albale15/simulador_de_Extraccion_de_polipos_intestinales/INFORME/apendices imagenes/fidelidad visual1.png

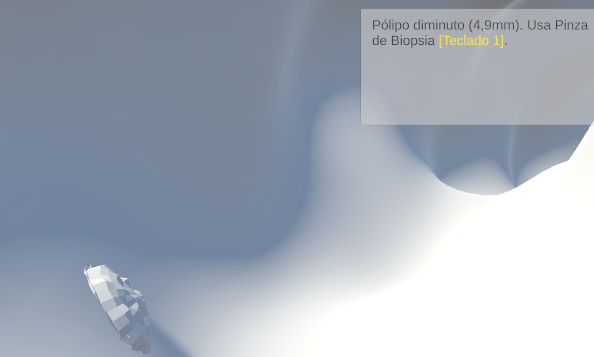
INFORME/apendices imagenes/fidelidad visual1.png
