albale15/simulador_de_Extraccion_de_polipos_intestinales/INFORME/apendices imagenes/MecanismoDeInsercion.PNG

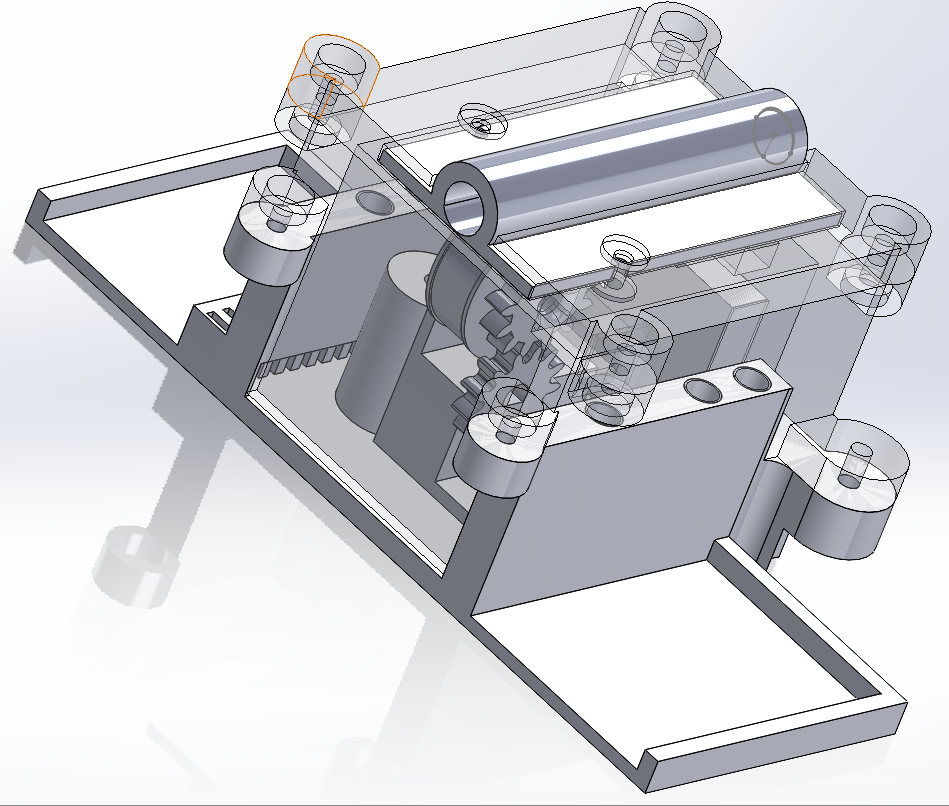
INFORME/apendices imagenes/MecanismoDeInsercion.PNG
