albale15/simulador_de_Extraccion_de_polipos_intestinales/presentacion/presentacion simulador de reseccion de polipos intestinales.pptx

## Simulador híbrido físico-virtual para el entrenamiento de resección de pólipos intestinales

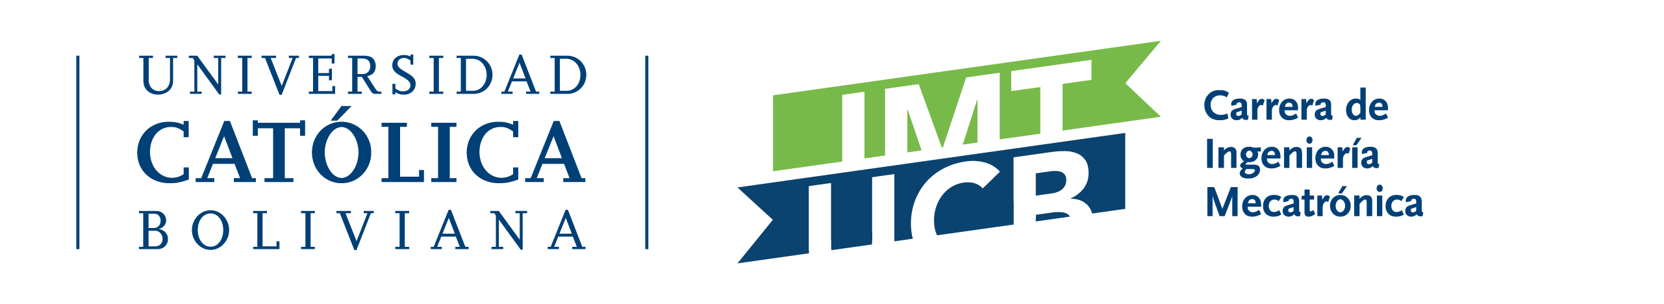
[picture p3: figure]

Por: Alejandro Eduardo Albarracin Rodriguez
TUTOR: Guillermo Enrique Manning Soria Galvarro
PANELISTA: Xavier Alexis Murillo Sanchez
RELATOR: Andrés Leonardo Gutierrez Rocha

## Introducción

TALLER DE GRADO 1-2026

Alejandro Eduardo Albarracin Rodriguez
TUTOR: Guillermo Enrique Manning Soria Galvarro
PANELISTA: Xavier Alexis Murillo Sanchez
RELATOR: Andrés Leonardo Gutierrez Rocha

- La Organización Mundial de la Salud (a través de datos recopilados en World Life Expectancy) indica que en Bolivia hubo cerca de 407 muertes atribuidas al cáncer colorrectal en 2020.
- En Bolivia, la escasez de simuladores clínicos o equipos de práctica especializados en el país obliga a que gran parte del aprendizaje de procedimientos endoscópicos se realice directamente sobre pacientes reales.

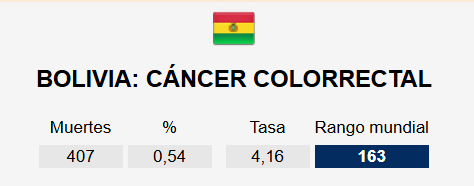
[picture p4: figure]

Datos de la Organización Mundial de la Salud (OMS), vía World Life Expectancy.

## Planteamiento del Problema

TALLER DE GRADO 1-2026

Alejandro Eduardo Albarracin Rodriguez
TUTOR: Guillermo Enrique Manning Soria Galvarro
PANELISTA: Xavier Alexis Murillo Sanchez
RELATOR: Andrés Leonardo Gutierrez Rocha

- Simuladores comerciales de alta fidelidad (GI Mentor) muy realistas, pero con costos prohibitivos (>USD 60,000).

- Soluciones locales de simulación médica — acceso más amplio, pero con limitaciones técnicas.

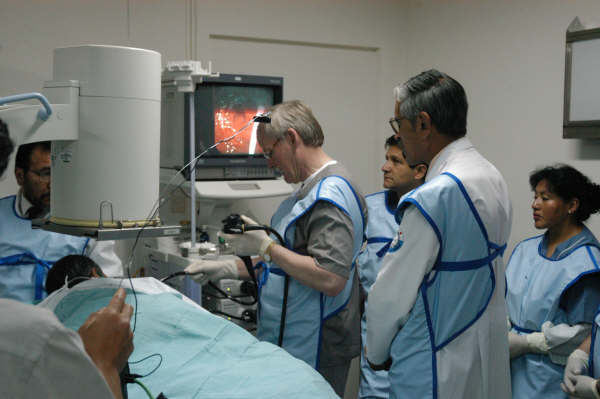
[picture p5: figure]

Capacitación en el Centro de Capacitación WGO La Paz.

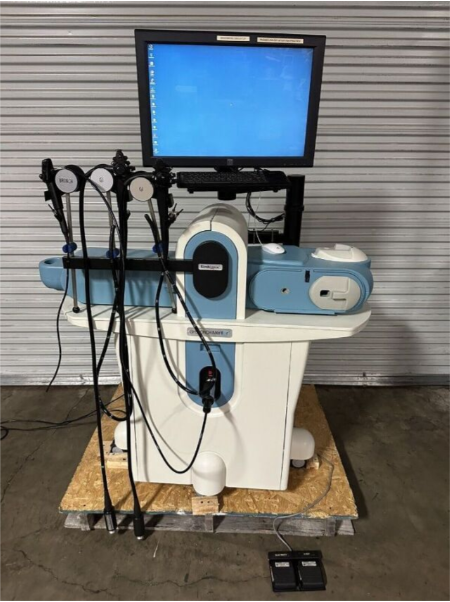
[picture p6: figure]

Simulador Gi Mentor para Endoscopia.

## Objetivo General

TALLER DE GRADO 1-2026

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

- Diseñar un simulador de resección de pólipos intestinales de bajo costo, con integración físico–virtual, con la finalidad de apoyar la práctica y entrenamiento en endoscopia terapéutica en entornos académicos con recursos limitados, permitiendo evaluar precisión, tiempo de respuesta y seguridad durante la práctica endoscópica simulada.

## Estado del Arte y Ventaja Competitiva

TALLER DE GRADO 1-2026

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

Simuladores Comerciales (ej. GI Mentor): Alta fidelidad, pero cerrados y con costo > $60,000 USD.
Prototipos Académicos Actuales: Bajo costo, pero sufren de alta latencia, desgaste mecánico, ruido mecánico y poca fidelidad práctica.
Nuestro Proyecto, latencia asíncrona imperceptible, con eliminación de ruidos, retroalimentación práctica.

## Arquitectura Híbrida Físico-Virtual

TALLER DE GRADO 1-2026

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

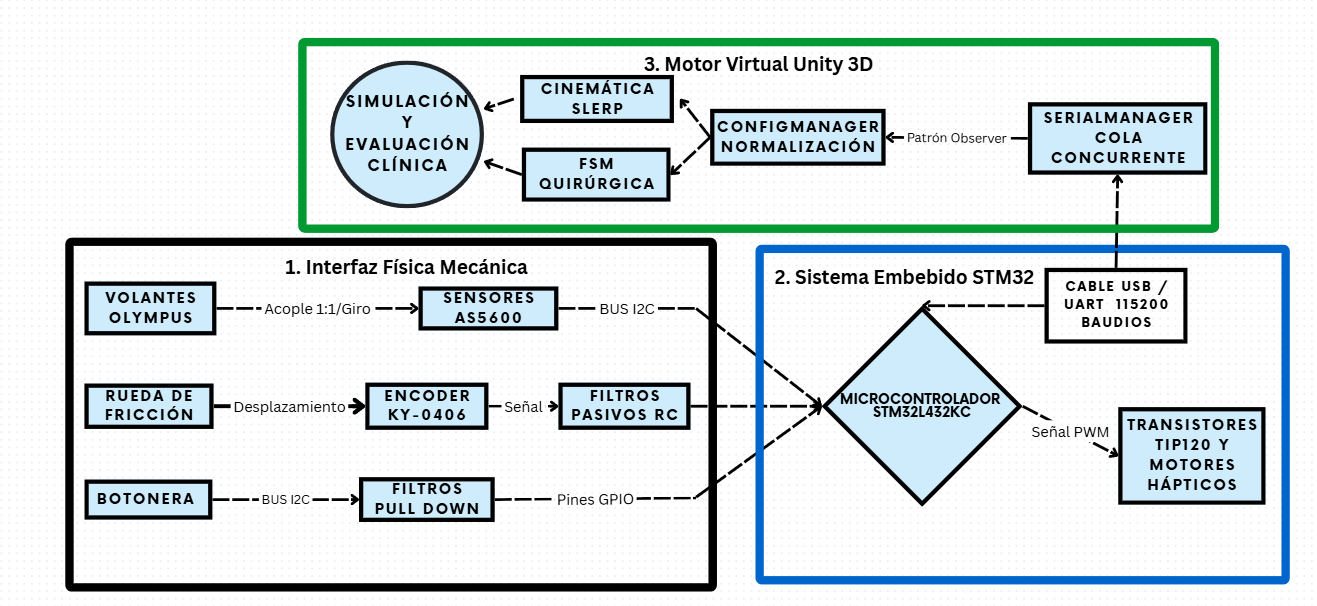
[picture p7: figure]

- Interfaz Física
- Sistema Embebido
- Entorno Virtual (Unity).

## Arquitectura Electrónica Embebida

TALLER DE GRADO 1-2026

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

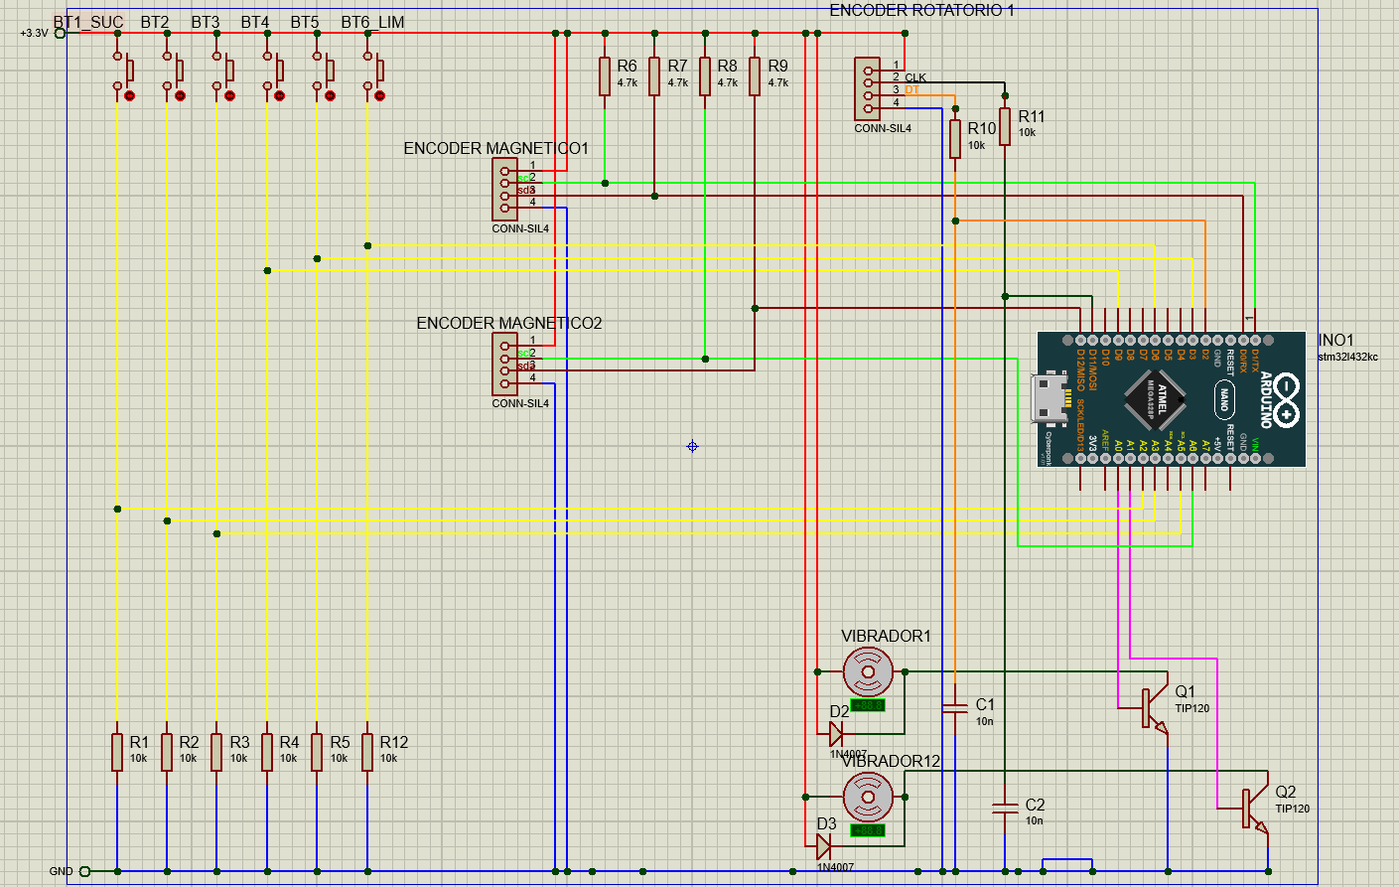
[picture p8: figure]

Circuito en Proteus.

Obj. 1. Diseño de circuito electrónico.

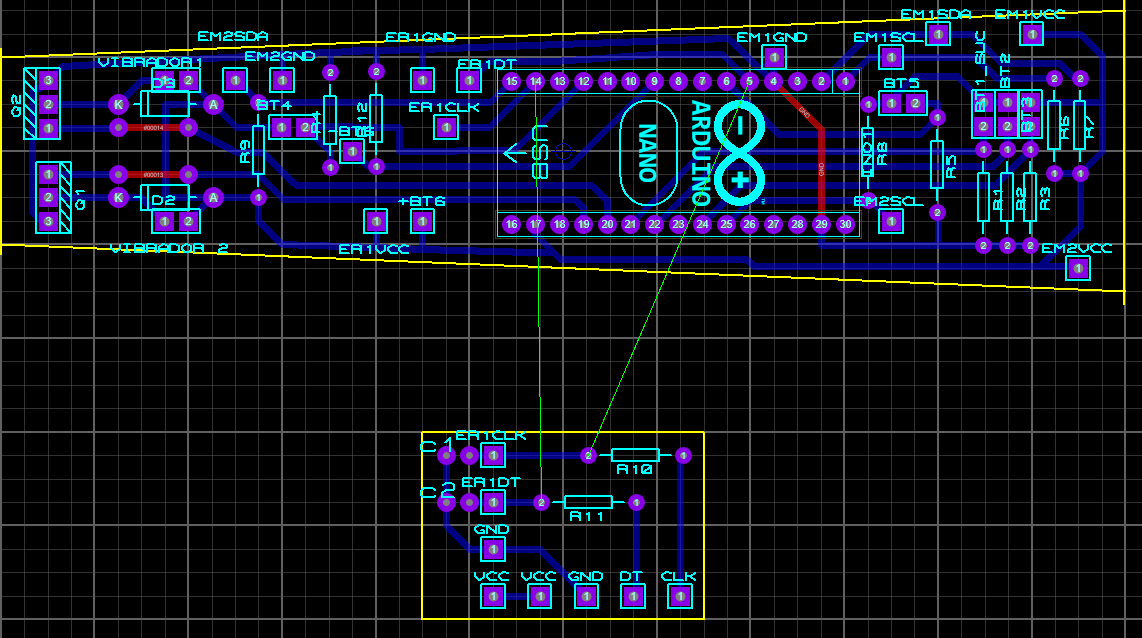
[picture p9: figure]

Diseños para las PCB en Proteus.

## Sensado Magnético

TALLER DE GRADO 1-2026

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

- Sustitución de potenciómetros para eliminar fricción y ruido mecánico.
- Sensores AS5600 con protocolo de comunicación I2C.
- Resolución digital de 12 bits (4096 posiciones por revolución).

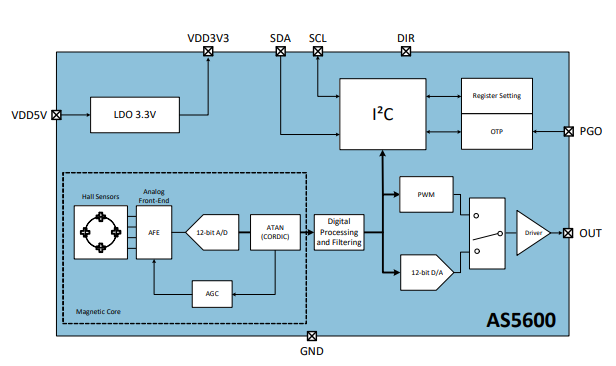
[picture p10: figure]

Encoder Magnetico AS5600.

## Filtrado Analógico y Digital

TALLER DE GRADO 1-2026

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

- Filtro pasivo RC por hardware (fc ≈ 159 Hz) para absorción de transitorios.
- Algoritmo digital (Firmware): Máquina de estados de 16 posiciones mediante interrupciones (EXTI) y Debounce de 10 ms.
- Seguro contra congelamiento en los motores vibradores (apagado automático después de 1000 ms).

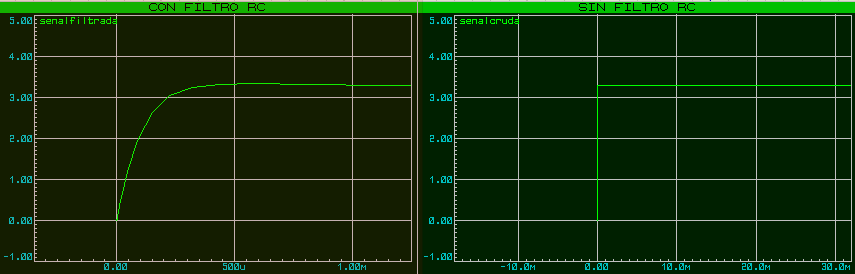
[picture p11: figure]

Curva de Señales del Sensor rotativo.

## Diseño Mecánico y Tren Cinemático

TALLER DE GRADO 1-2026

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

- Manufactura en FDM (Ácido Poliláctico – PLA)

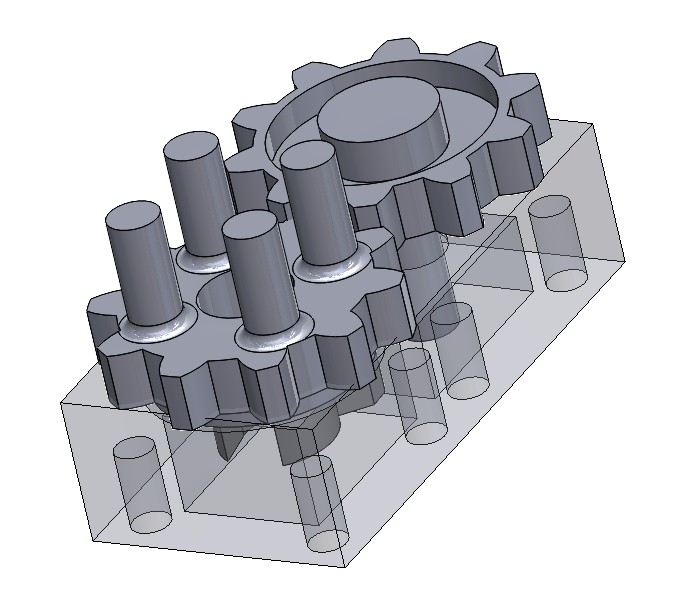
[picture p12: figure]

Caja de Engranes 1:1 del Centro de mando.

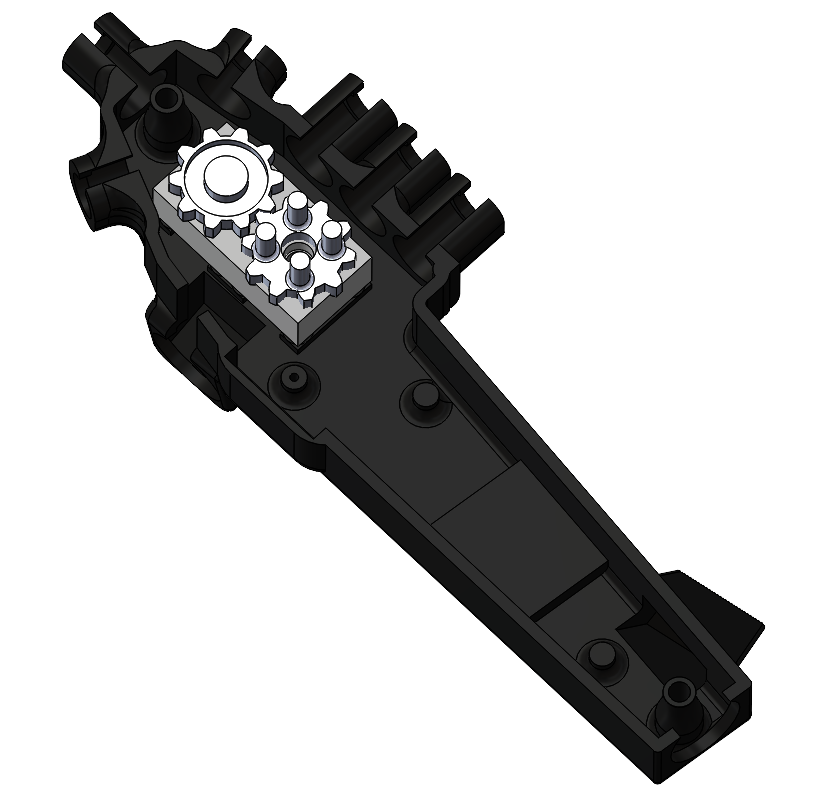
[picture p13: figure]
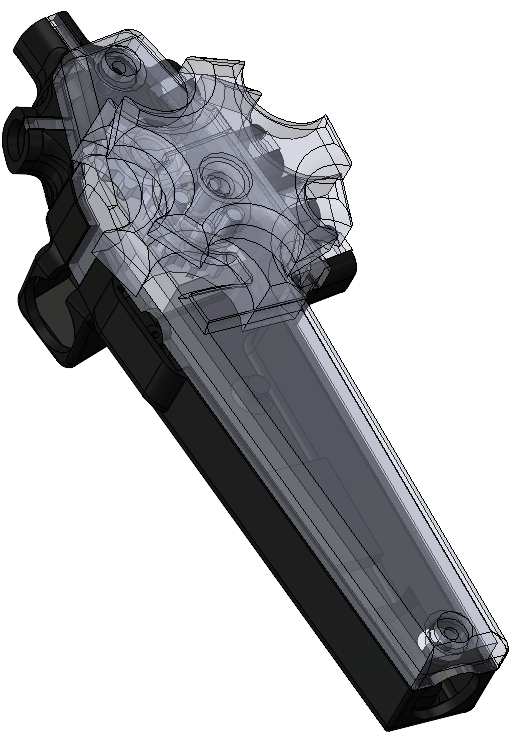
[picture p14: figure]

Mecanismo del Centro de Mando.

Obj. 3 - Fabricar los elementos físicos de interacción.

## Cinemática de Inserción Longitudinal

TALLER DE GRADO 1-2026

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

- Captura de desplazamiento: mecanismo basado en fricción estática (rueda de goma).
- Encoder rotativo KY-040 gestionado por interrupciones (EXTI).
- Diseño modular para ajustes o mejoras, alta escalabilidad.

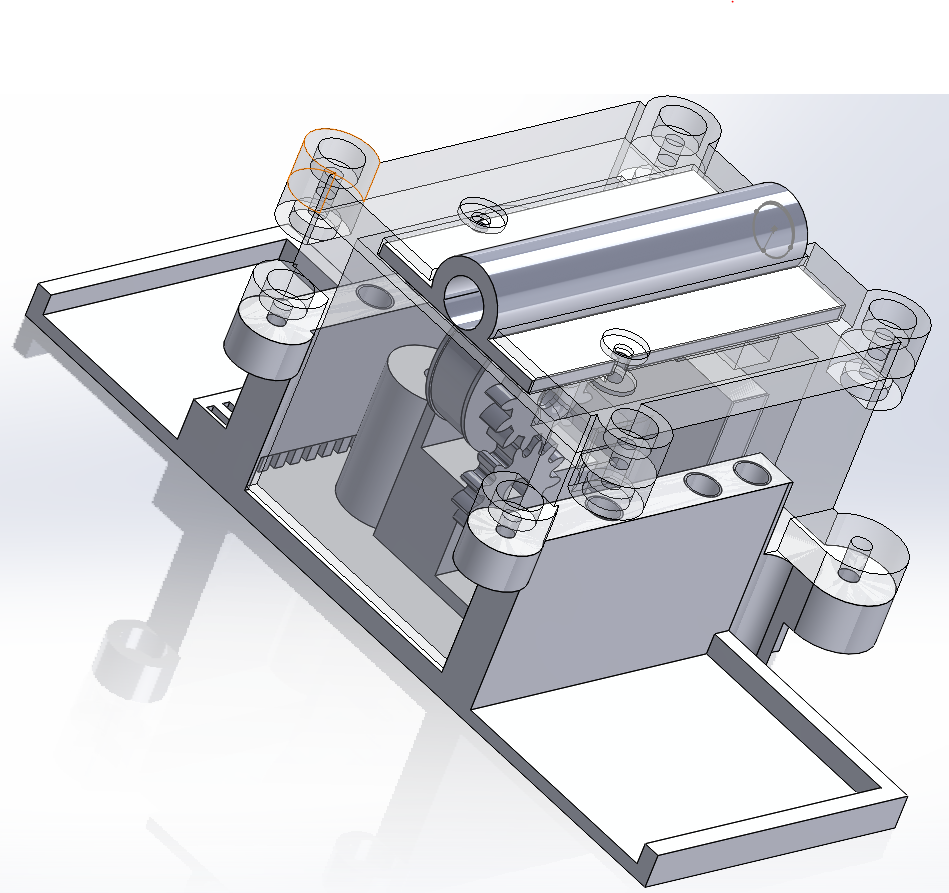
[picture p15: figure]

Mecanismo de Inserción.

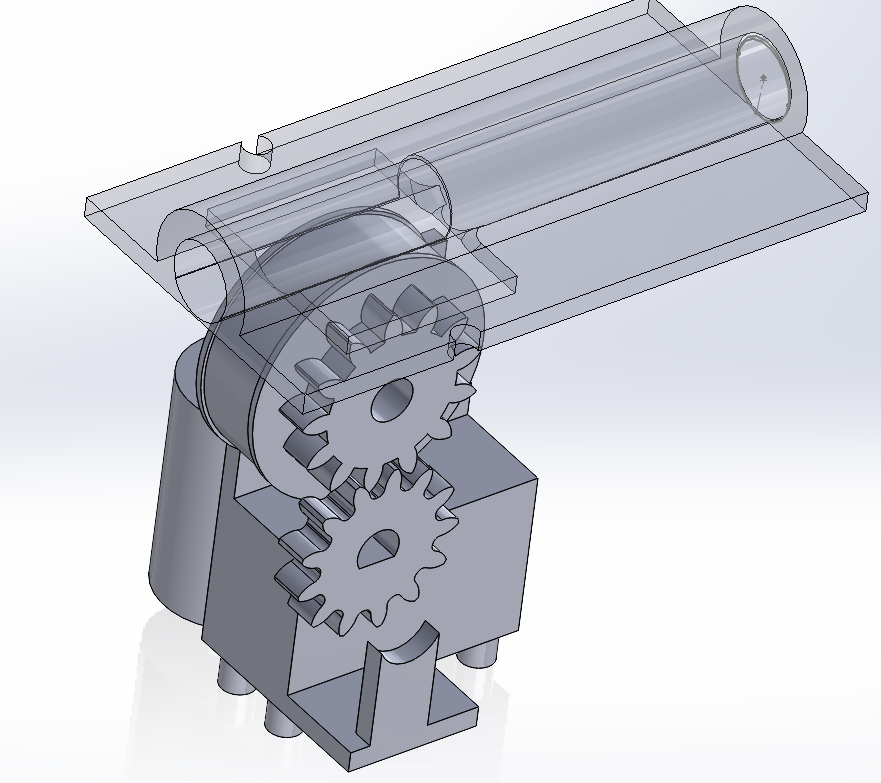
[picture p16: figure]

Transmisión de Movimiento del Mecanismo de Inserción.

## Sincronización y Telemetría

TALLER DE GRADO 1-2026

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

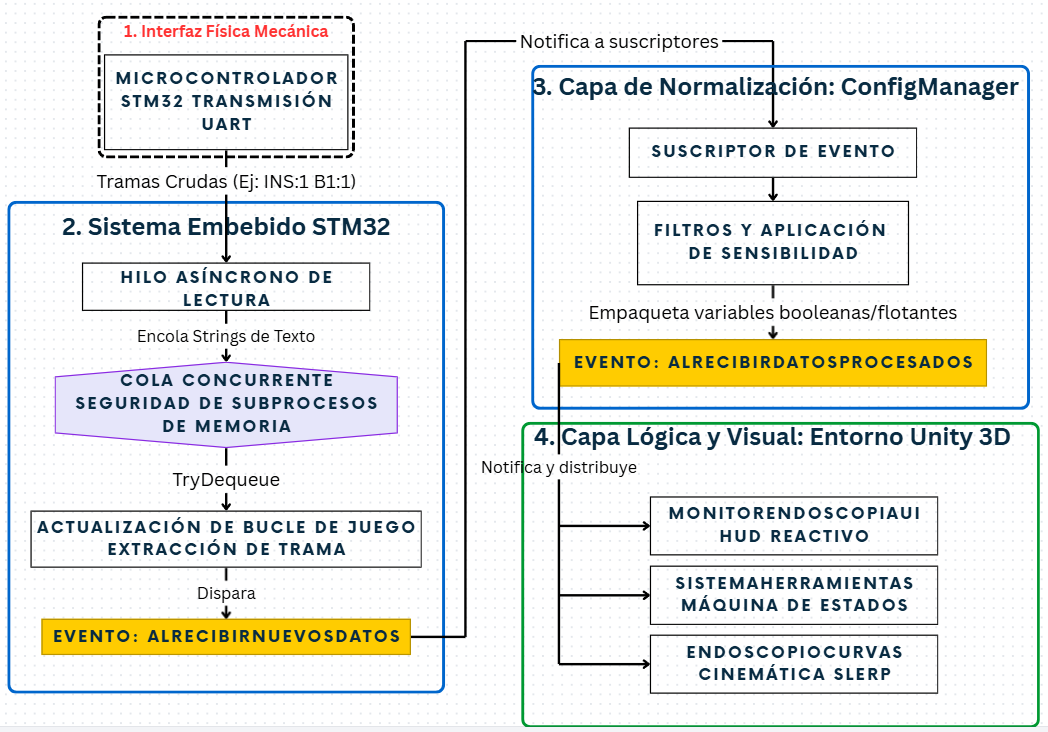
[picture p17: figure]

- Lectura serial asíncrona mediante hilos en segundo plano.
- Uso de colas concurrentes (Thread-Safe) para evitar colisiones de memoria.

- Patrón de diseño Observer para normalización de datos.
- Protocolo de Handshake donde Unity busca la firma ID: ENDOSCOPIO_V1.

Obj. 2 – Interconexión entre circuito físico y el entorno de simulación.

## Cinemática Virtual (Interpolación Slerp)

TALLER DE GRADO 1-2026

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

- Algoritmo de propagación de curvas mediante interpolación lineal esférica (Quaternion.Slerp).
- Monitoreo constante de estrés tisular (detección de bucles > 140°).
- Escudo "Anti-Lag" para evitar movimientos bruscos causados por hardware.

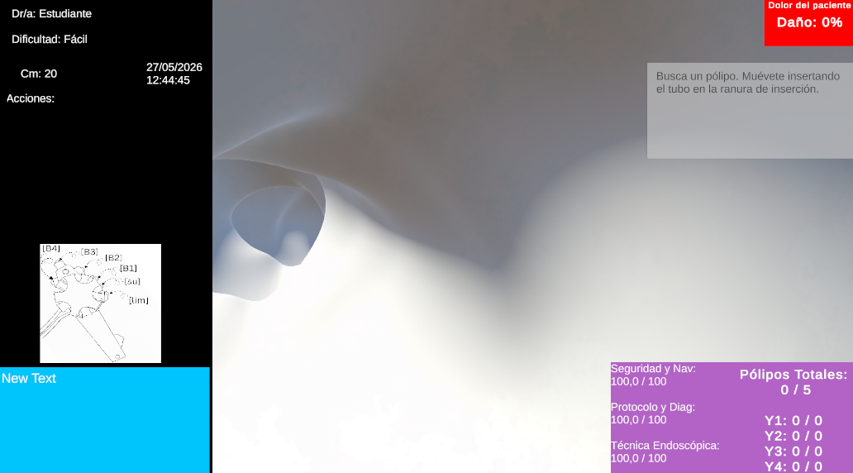
[picture p18: figure]
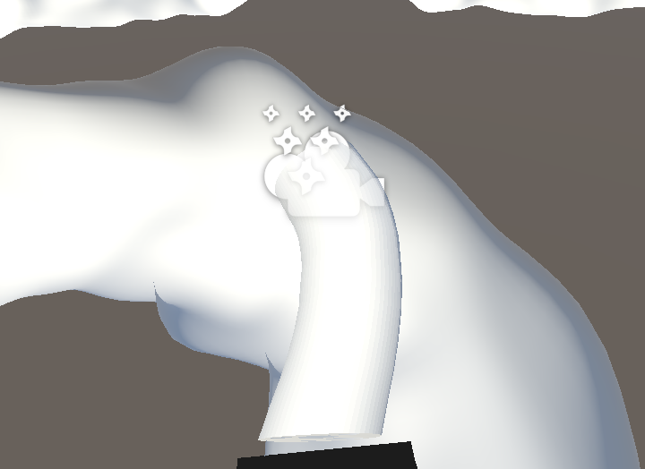
[picture p19: figure]

Punta de la Fibra simulada.

Enfoque de la Cámara de la fibra.

## Generación Procedural y Clasificación de Yamada

TALLER DE GRADO 1-2026

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

- Instanciación aleatoria utilizando física de rayos (Raycast).
- Alineación geométrica basada en las normales de la pared intestinal.
- Variación paramétrica visual (lesiones de 2 mm a 9 mm).

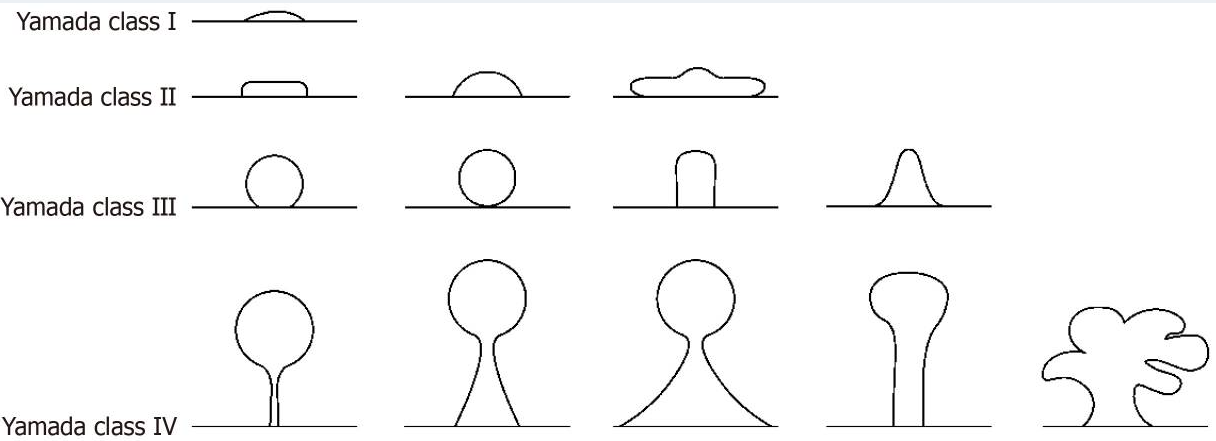
[picture p20: figure]

Clasificación Japonesa Yamada.

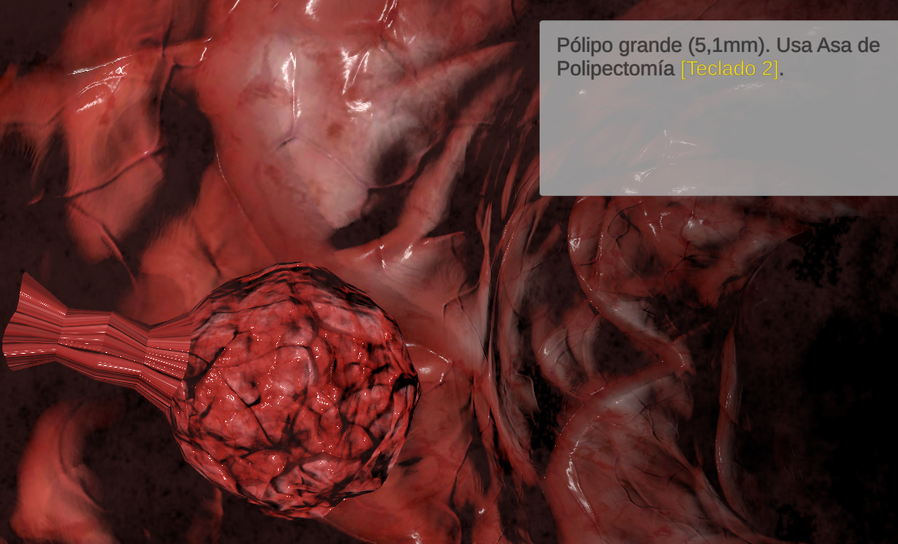
[picture p21: figure]

Pólipo del simulador y Guía conceptual.

Obj. 4 - Entorno virtual paramétrico capaz de renderizar y evaluar lesiones de 2 mm a 9 mm.

## Máquina de Estados Finita Quirúrgica (FSM)

TALLER DE GRADO 1-2026

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

- Restricción de herramientas según tamaño de lesión.
- Uso obligatorio de Pinza Fría para patologías ≤ 5 mm.
- Activación de Asa Diatérmica (electrocauterio) para lesiones mayores.

Intacto

Cortado/Suelto

Capturado

Obj. 6 - Módulo de evaluación algorítmica y retroalimentación reactiva integrado.

## Motor de Fluidos y Evaluación Ponderada

TALLER DE GRADO 1-2026

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

- Simulación de obstrucción visual (lente sucio por roce contra tejidos).
- Hemorragias dinámicas aleatorias con requerimiento de succión en < 5 segundos.
- Exportación de reportes tabulares (CSV) y JSON.

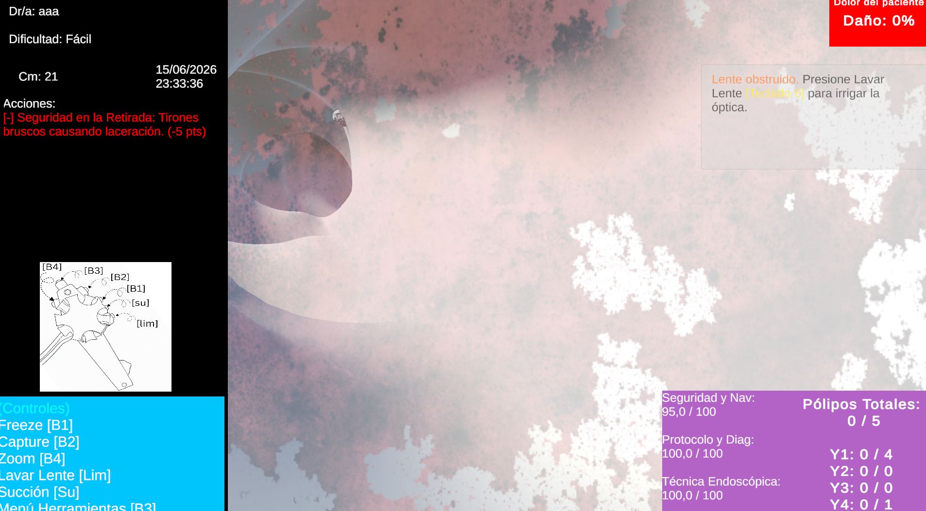
[picture p22: figure]
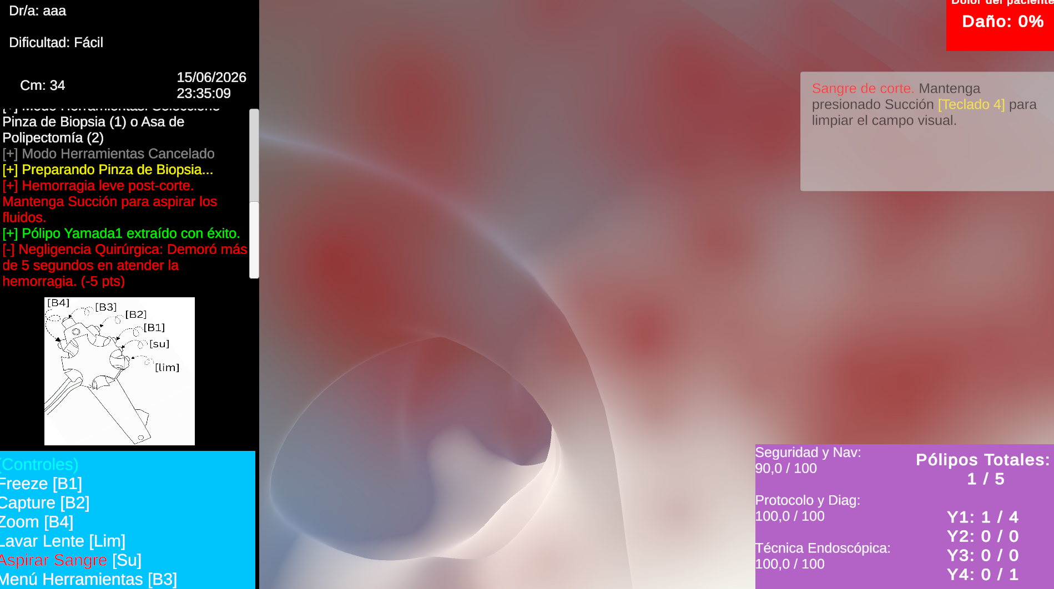
[picture p23: figure]

Cámara con Sangre en el Lente.

Cámara con Mucosa Intestinal.

Obj. 6 - Módulo de evaluación algorítmica y retroalimentación reactiva integrado.

## Fiabilidad de Sensado y Desviación Angular

TALLER DE GRADO 1-2026

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

- Margen de error de entradas discretas inferior al 5% requerido.
- Resolución experimental de volantes magnéticos de ~45 pulsos por vuelta.
- Desviación angular promedio máxima de 0.18° (tolerancia exigida < 10°).

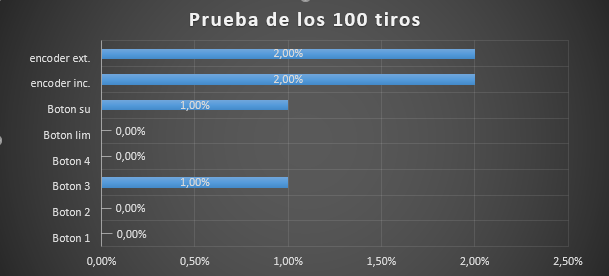
[picture p24: figure]

Obj. 1. Diseño de circuito electrónico con error de lectura comprobado menor al 5%.

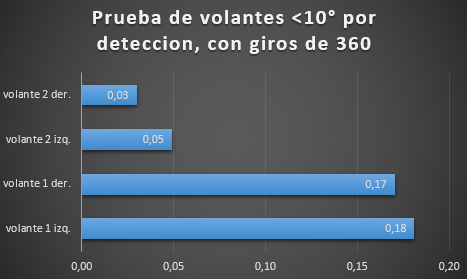
[picture p25: figure]

Obj. 3 - Interfaz física fabricada con desviación angular máxima probada de 0.18°.

## Tiempos de Latencia y Renderizado

TALLER DE GRADO 1-2026

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

- Evaluación de latencia mediante método RTT (Ping-Pong serial).
- Latencia promedio de todo el sistema: 16.04 milisegundos.
- Tasa de refresco estacionaria garantizada de 60 FPS sin saturación del bus.

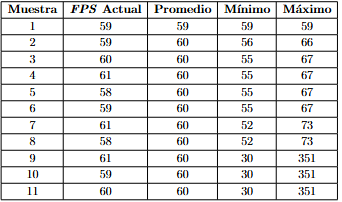
[picture p26: figure]

Tabla control de FPS por Acción.

Obj. 2 - comunicación en tiempo real con una latencia inferior a 100 milisegundos y una tasa de refresco mínima de 60 fps

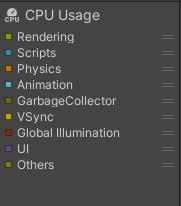
[picture p27: figure]
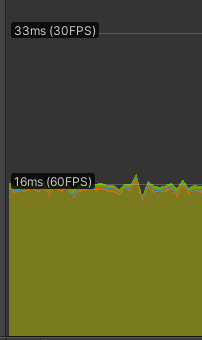
[picture p28: figure]

Tabla control de FPS Simulación por Unity.

## Validación Cinemática de Inserción

TALLER DE GRADO 1-2026

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

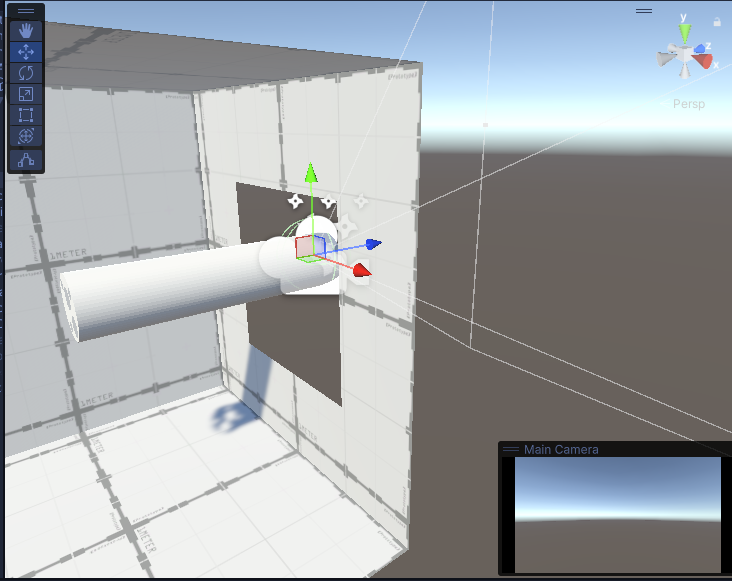
[picture p29: figure]

- Pruebas en escenario de vacío para aislar comportamiento del encoder.
- Error promedio en avance: 3.58% (Tracción óptima).
- Error promedio en retroceso: 6.91% (Histéresis por patinaje mecánico).
- Sistema compensado paramétricamente por debajo del límite del 10%.

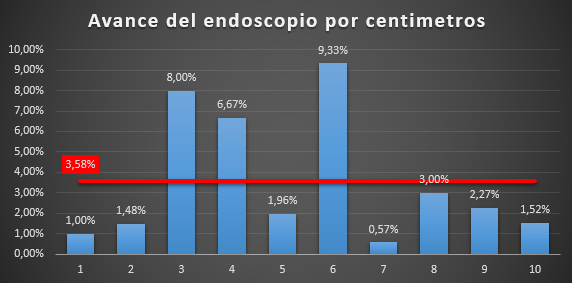
[picture p30: figure]
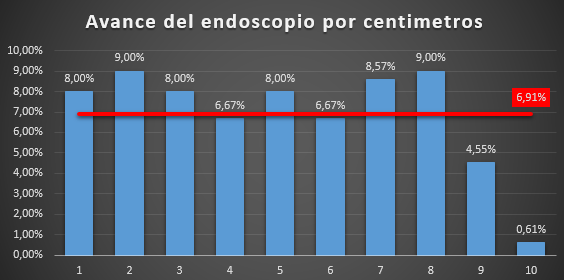
[picture p31: figure]

Obj. 5 - Correspondencia cinemática lograda con error máximo compensado menor al 10%

## Evaluación por Médicos Especialistas

TALLER DE GRADO 1-2026

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

- Panel de 4 médicos especialistas en endoscopia gastroenterológica.
- Efectividad de penalización algorítmica calificada en 6.75/10.
- Recomendación global para laboratorios introductorios de 8.25/10.

¿En qué medida está de acuerdo con que la penalización progresiva (advertencias visuales antes de fallar) acelera la comprensión del estudiante sobre sus propios errores operativos?

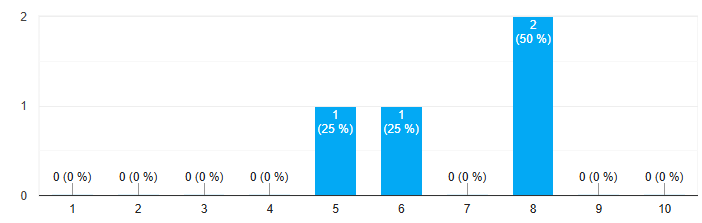
[picture p32: figure]

Obj. 6 - Módulo de retroalimentación interactiva y evaluación básica integrado.

En términos generales, ¿recomendaría la integración de este simulador híbrido como un módulo introductorio en los laboratorios de habilidades clínicas universitarias?

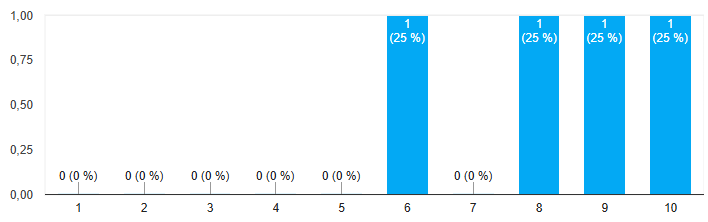
[picture p33: figure]

Obj. 8 - Validación clínica funcional y usabilidad evaluada por especialistas en endoscopia.

## Análisis de Costos (1$=9.96 Bs.)

TALLER DE GRADO 1-2026

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

- Costo de desarrollo e ingeniería (Ingeniería+Desarrollo): ~27,680 Bs.
- Costo unitario de materiales para replicabilidad: 2,757 Bs (~279 USD).
- Alternativa real y accesible frente a tecnologías cerradas de importación.

Categoría | Total (Bs.)
Materiales electrónicos | 369
Módulo sensorial y háptico | 80
Materiales mecánicos y fabricación | 2158
Fabricación externa | 150
Mano de obra y desarrollo | 27680
Costo total del prototipo | 30437 Bs.

Obj. 7 - Análisis financiero que demuestra una reducción de costos frente al mercado comercial.

## Conclusiones

TALLER DE GRADO 1-2026

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

- Viabilidad Mecatrónica: Se logró el diseño de un simulador funcional con un costo de materiales de 2,757 Bs, representando una alternativa económicamente viable.
- Sincronización: La telemetría asíncrona garantizó una latencia promedio de 16.04 ms y 60 FPS estables, eliminando la desorientación sensorial.
- Precisión de Sensado: El filtrado híbrido redujo el error de botones a 0%, el encoder a 2% y mantuvo una desviación angular máxima de 0.18°.
- Validación Clínica: El panel de 4 especialistas evaluó el sistema con 8.25/10 para su integración en laboratorios introductorios.

## Trabajo Futuro

TALLER DE GRADO 1-2026

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

- Materiales Biocompatibles: Transición del PLA hacia elastómeros de silicona (Shore 00) y recubrimientos de teflón para replicar la resistencia de la mucosa intestinal.
- Retroalimentación Activa: Integración de motores de Force Feedback y celdas de carga para emular la inversión de torque y la resistencia anatómica profunda.
- Motor de Físicas Avanzado: Migración a dinámicas de cuerpos blandos (Soft-Body Dynamics) en Unity para deformación plástica realista de los pólipos.

## Muchas Gracias.

TALLER DE GRADO 1-2026

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

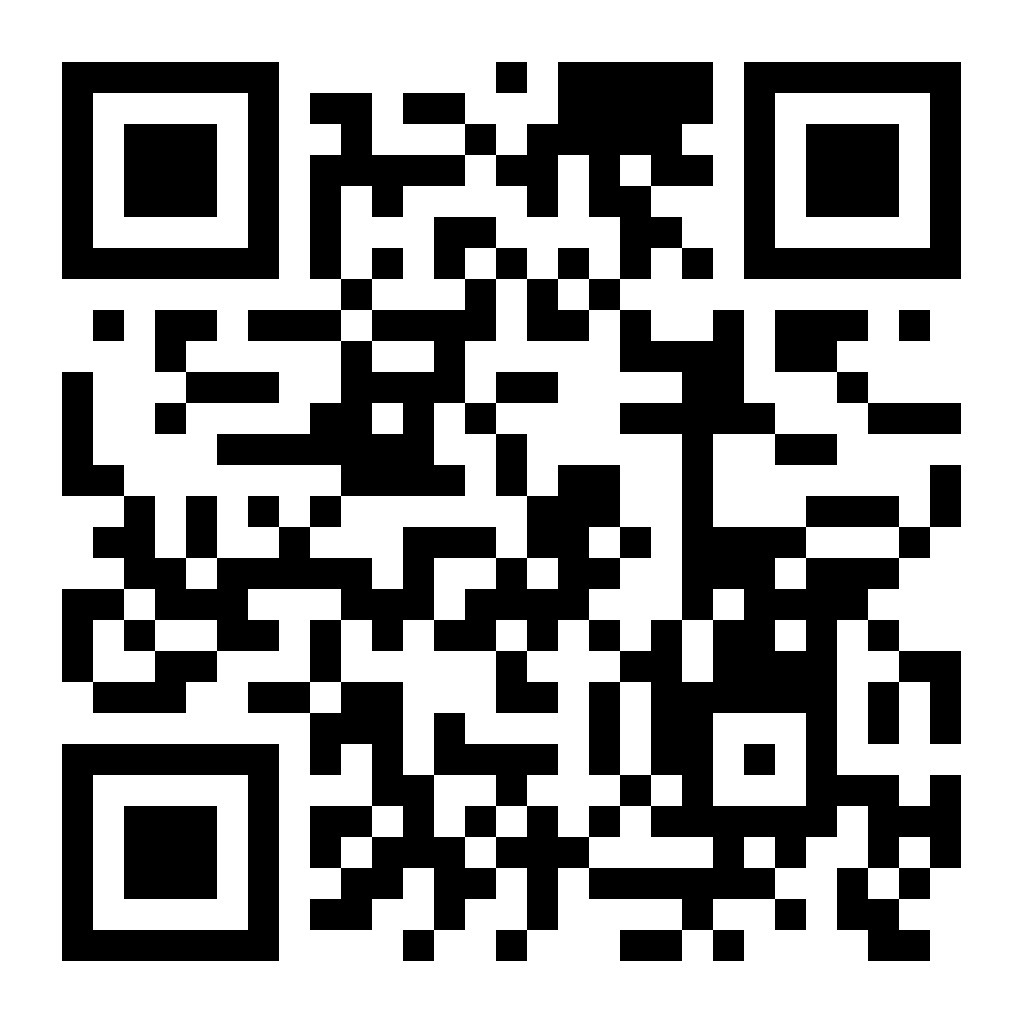
[picture p34: figure]

Repositorio en GitHub

Requerimientos mínimos de la aplicación
