albale15/simulador_de_Extraccion_de_polipos_intestinales/aplicacion/GDD Simulador de Extracción de Pólipos Intestinales.docx

# GDD Simulador de Extracción de Pólipos Intestinales

# 1) Descripción General

El simulador se centrará únicamente en el motor gráfico y la interfaz de Unity para poder realizar las prácticas virtuales. Contará con elementos 3D como el intestino, los pólipos y las pinzas, basando sus mecánicas netamente en el flujo de juego.

# 2) Arquitectura de Escenas La aplicación contará con dos escenas principales: el Menú Principal y el Simulador.

Menú Principal: Contará con un fondo de pantalla y tres botones: "Iniciar Práctica", "Historial/Registros" y "Configuración". En la pantalla habrá un texto que indicará si el centro de mando (endoscopio) está conectado; si no lo está, aparecerá un botón de reintento de conexión. El último elemento será un botón para salir de la aplicación.

Popup de Configuración: Permitirá cambiar la sensibilidad y el orden de los botones. Se podrá modificar la dirección y sensibilidad de los giros (izquierda/derecha, arriba/abajo), así como la dirección de inserción y extracción para corregir errores de hardware. Contará con un botón para probar los vibradores de la placa STM y otro para restablecer los valores originales.

Popup de Historial: Mostrará los datos guardados de cada usuario. Permitirá organizar la información creando, eliminando y navegando entre carpetas (o derivando el guardado a una ubicación en la PC). Permitirá exportar un archivo de Excel con los datos de la práctica, detallando los puntos perdidos por incumplimiento de parámetros, el nombre del usuario y la fecha.

# 3) Configuración del Simulador y Dificultades

Al iniciar, se presentará una fase de configuración donde se podrán ajustar los pesos de las calificaciones fundamentales, con opción a restablecer los valores predeterminados. Luego, se seleccionará la dificultad y la cantidad de pólipos (con un límite establecido), permitiendo personalizar la aparición de tipos específicos (Yamada). Tras presionar empezar, se generarán los pólipos en el intestino y el usuario esperará en una pantalla de carga que le indicará cómo se desarrollará la práctica según la dificultad.

Tutorial: Práctica rápida guiada con 5 pólipos predefinidos para enseñar los controles y cómo resolver el procedimiento.

Fácil: Sistema guiado que muestra el puntaje en tiempo real. Indica qué acciones tomar (ej. mantenerse quieto) y da feedback visual si se comete un error.

Normal: Retira las guías paso a paso; el sistema solo indicará al usuario cuando pierda puntos.

Realista: Emulación libre sin guías visuales ni elementos de apoyo. Si el usuario retira el endoscopio al inicio sin efectuar ninguna acción, finalizará con 0 puntos. Solo contará con respuestas hápticas de daño al paciente.

Menú de Pausa: Permitirá reanudar, reiniciar o volver al menú principal; también servirá para detener la práctica automáticamente si se desconecta el centro de mando.

# 4) Mecánicas del Hardware

Inserción/Extracción: Se genera empujando o sacando el tubo desde el centro de mando de la mesa.

Torque de giro: Técnica que tensa los cables del tubo de fibra, volviéndolo más rígido para darle fuerza y poder realizar los giros en las curvas del intestino.

Volantes (Izquierda/Derecha, Arriba/Abajo): Generan tensión en la punta de la fibra para que la cámara mire hacia la dirección deseada.

Accionadores (Botones): Sirven para ejecutar los protocolos médicos solicitados por el doctor.

Vibrador: Proporciona respuesta háptica como advertencia contra los daños al cuerpo del paciente.

# 5) Flujo de Juego (La Práctica)

El estudiante inicia con 100 puntos y debe demostrar control mecánico y adherencia al protocolo; el sistema solo restará puntos por errores.

Fase 1: Navegación Segura: El estudiante comienza a empujar el tubo usando el encoder de inserción. Al llegar a una curva, usa los volantes para centrar el lumen y aplica torque para reorientar la cámara y deslizarse (destensando al pasar la zona de peligro). En Unity, esto se traduce en avance en el eje local Z, rotación local Z (torque) y rotación X/Y en la punta (volantes). Se penaliza por falta de suavidad (si el encoder detecta "tirones" o fluctuaciones bruscas de velocidad > 5%) y por chocar de frente contra la pared perdiendo la visibilidad (trauma tisular).

Fase 2: Inspección y Hallazgo: A medida que avanza y retrocede, se debe usar el torque constantemente para inspeccionar detrás de los pliegues. En Unity, el giro del encoder rota la cámara y activa internamente PolipoEncontrado = true al entrar el pólipo en el cono de visión (Frustum). Si se llega al final del tramo sin enfocar el pólipo por falta de uso del torque, se pierden los puntos de diagnóstico.

Fase 3: Protocolo Médico: Una vez a la vista, el estudiante suelta la inserción y usa los volantes para centrar el pólipo. Debe usar los botones Freeze (pausa el renderizado) y Capture (guarda un registro), apoyándose del Zoom si es necesario. Se mantienen los puntos del protocolo solo si el pólipo estaba centrado y enfocado al capturar; intentar extraer sin documentar penaliza severamente.

Fase 4: Análisis de Yamada: Tras tomar la foto, el simulador pide seleccionar la herramienta del inventario según la forma del pólipo. Se debe elegir Pinza de Biopsia para Yamada I/II (base ancha) o Red/Lazo para Yamada III/IV (con tallo). Seleccionar la herramienta equivocada resta puntos críticos de "Criterio Clínico".

Fase 5: Posicionamiento y Estabilización: Se debe ubicar el pólipo en la parte inferior de la pantalla (a las 6 en punto). Unity lanza un Raycast desde el canal de trabajo hacia el pólipo. El estudiante debe mantener esa posición firme (impactando la base del pólipo) durante 3 segundos continuos sin temblar para simular la introducción del lazo por parte de la enfermera. Si el estudiante se mueve, el contador se reinicia.

Fase 6: Ejecución: Tras estabilizar, se simula el corte y el modelo 3D del pólipo se desprende o cambia de estado físico. El estudiante usa el botón de Aspirar para recolectar el tejido o limpiar, activando partículas de succión hacia la cámara.

Fase 7: Retirada Segura: El estudiante debe usar el encoder en sentido inverso para jalar hacia atrás y sacar el endoscopio revisando que no haya sangrado. Si jala el tubo rápidamente o sin mirar, se le restan puntos de seguridad. La retirada debe ser tan controlada como el ingreso hasta salir del colisionador inicial, momento en el que el simulador termina la partida y lanza los resultados.

# 6) Parámetros de Calificación La puntuación final va de 100 a 0, restando puntos de forma ponderada

## Parámetros de Seguridad y Navegación

- Índice de Trauma Tisular: Cantidad de veces que la cámara choca bruscamente contra las paredes intestinales.
- Suavidad de Desplazamiento: Penalización por "tirones" o movimientos erráticos (medido por la aceleración del encoder de inserción).
- Porcentaje de Exploración Visual: llegar a sacar todos los pólipos y haber revisado el intestino (almenos en su mayoria).
- Seguridad en la Retirada: Mantener una velocidad de retracción lenta y controlada al sacar el endoscopio al final del procedimiento.

## Parámetros de Protocolo y Diagnóstico

- Documentación de Hallazgos: Uso secuencial obligatorio de los botones Freeze y Capture al detectar un pólipo.
- Calidad de Captura: Verificación de que el pólipo esté centrado y enfocado en el momento exacto de tomar la fotografía.
- Criterio Clínico (Regla de Yamada): Selección correcta de la herramienta en el inventario (Pinza de Biopsia para Yamada I/II o Lazo para Yamada III/IV).

## Parámetros de Técnica Quirúrgica (Extracción)

- Estabilidad de Abordaje: Capacidad de mantener el pólipo fijado en el centro de la pantalla durante un tiempo mínimo (ej. 3 segundos) usando los volantes, antes de permitir el corte.
- Tasa de Extracción Exitosa: Cantidad de pólipos removidos correctamente (el volumen total del tejido cortado sin afectar tejido sano).
- Higiene del Campo Visual: Uso correcto del botón de Aspirar para limpiar la zona después de ejecutar el corte.

# 7) Adiciones en el código y lógicas

Algoritmo de serpiente, lo que hace es calcular la deformación de cada hueso para simular el endoscopio
