albale15/simulador_de_Extraccion_de_polipos_intestinales/aplicacion/apk/linux/simulador_Endoscopico_Data/Resources/UnityPlayer.png

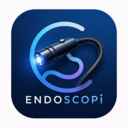
aplicacion/apk/linux/simulador_Endoscopico_Data/Resources/UnityPlayer.png
