albale15/simulador_de_Extraccion_de_polipos_intestinales/aplicacion/simulador_extraccion_polipos_I/Assets/2D/Texture/suciedad.png

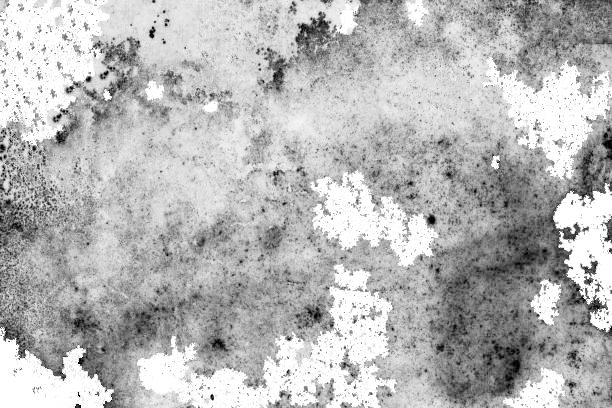
aplicacion/simulador_extraccion_polipos_I/Assets/2D/Texture/suciedad.png
