albale15/simulador_de_Extraccion_de_polipos_intestinales/INFORME/apendices imagenes/caalibracionEnVacio.png

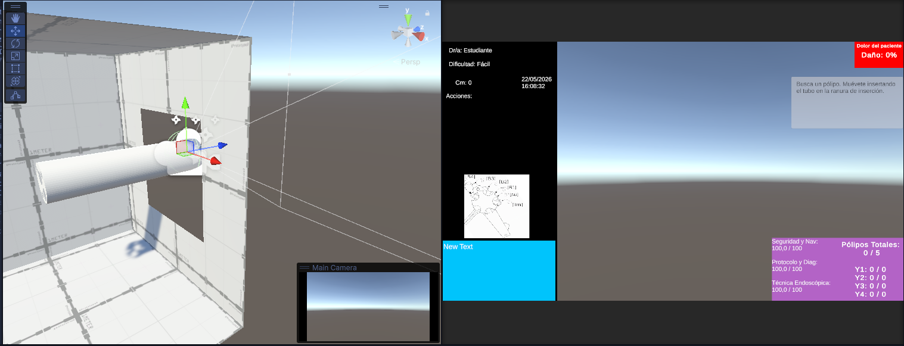
INFORME/apendices imagenes/caalibracionEnVacio.png
