albale15/simulador_de_Extraccion_de_polipos_intestinales/INFORME/apendices imagenes/Diagrama de Flujo de Software.png

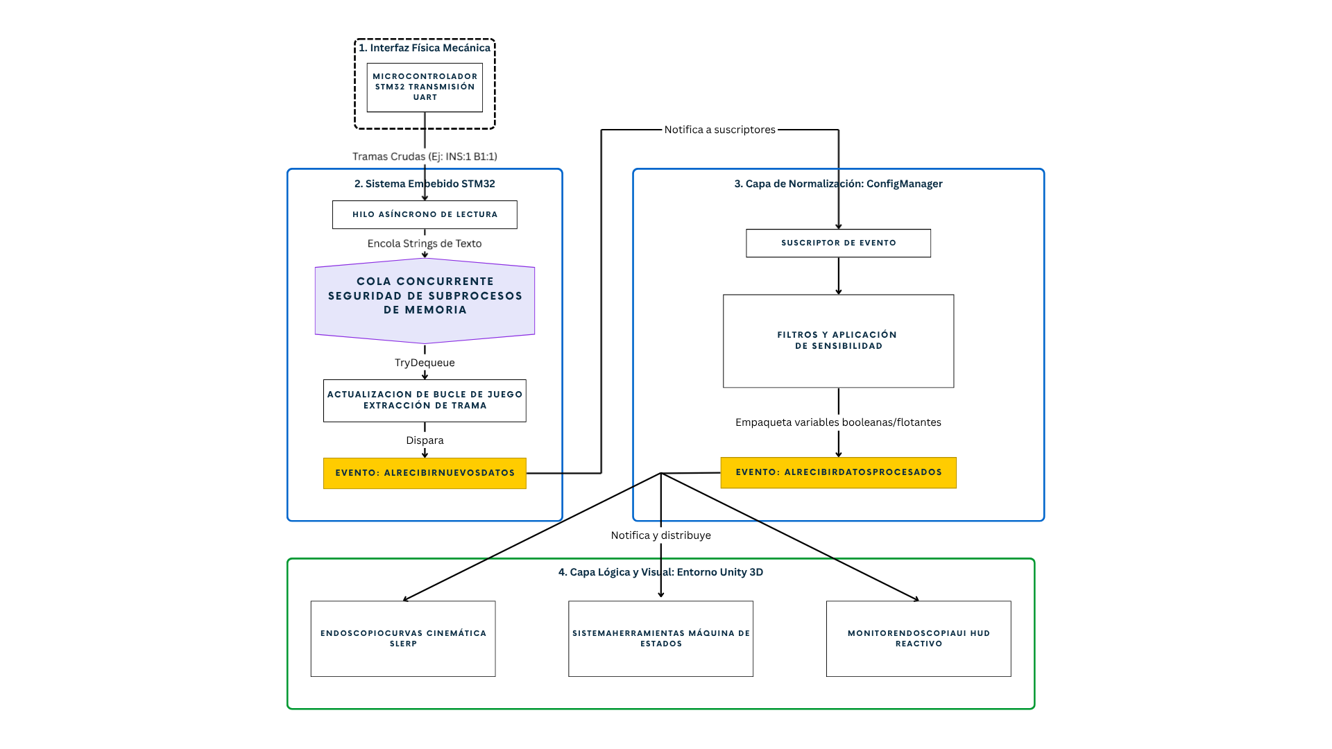
INFORME/apendices imagenes/Diagrama de Flujo de Software.png
