albale15/simulador_de_Extraccion_de_polipos_intestinales/INFORME/apendices imagenes/forms_pedagogia.PNG

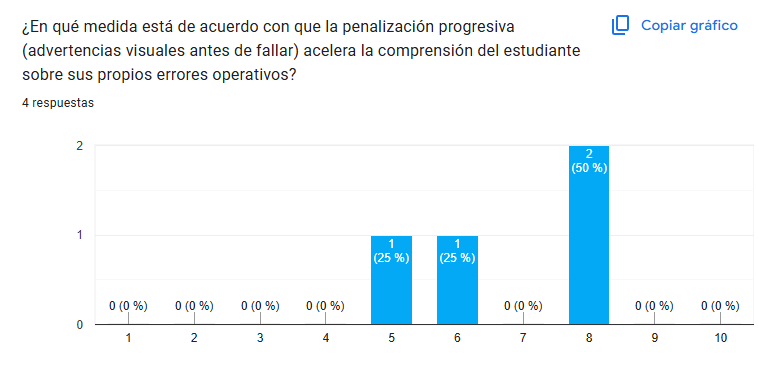
INFORME/apendices imagenes/forms_pedagogia.PNG
