albale15/simulador_de_Extraccion_de_polipos_intestinales/INFORME/apendices imagenes/imagen_Profiler.png

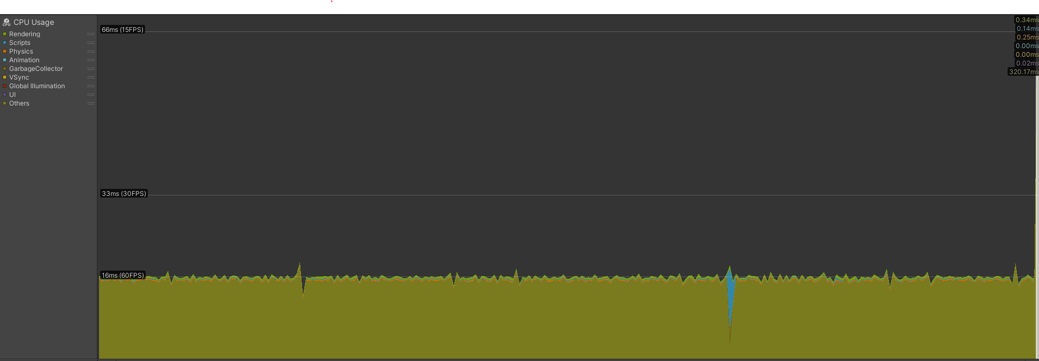
INFORME/apendices imagenes/imagen_Profiler.png
