albale15/simulador_de_Extraccion_de_polipos_intestinales/placa de circuito/circuito_proteus.PNG

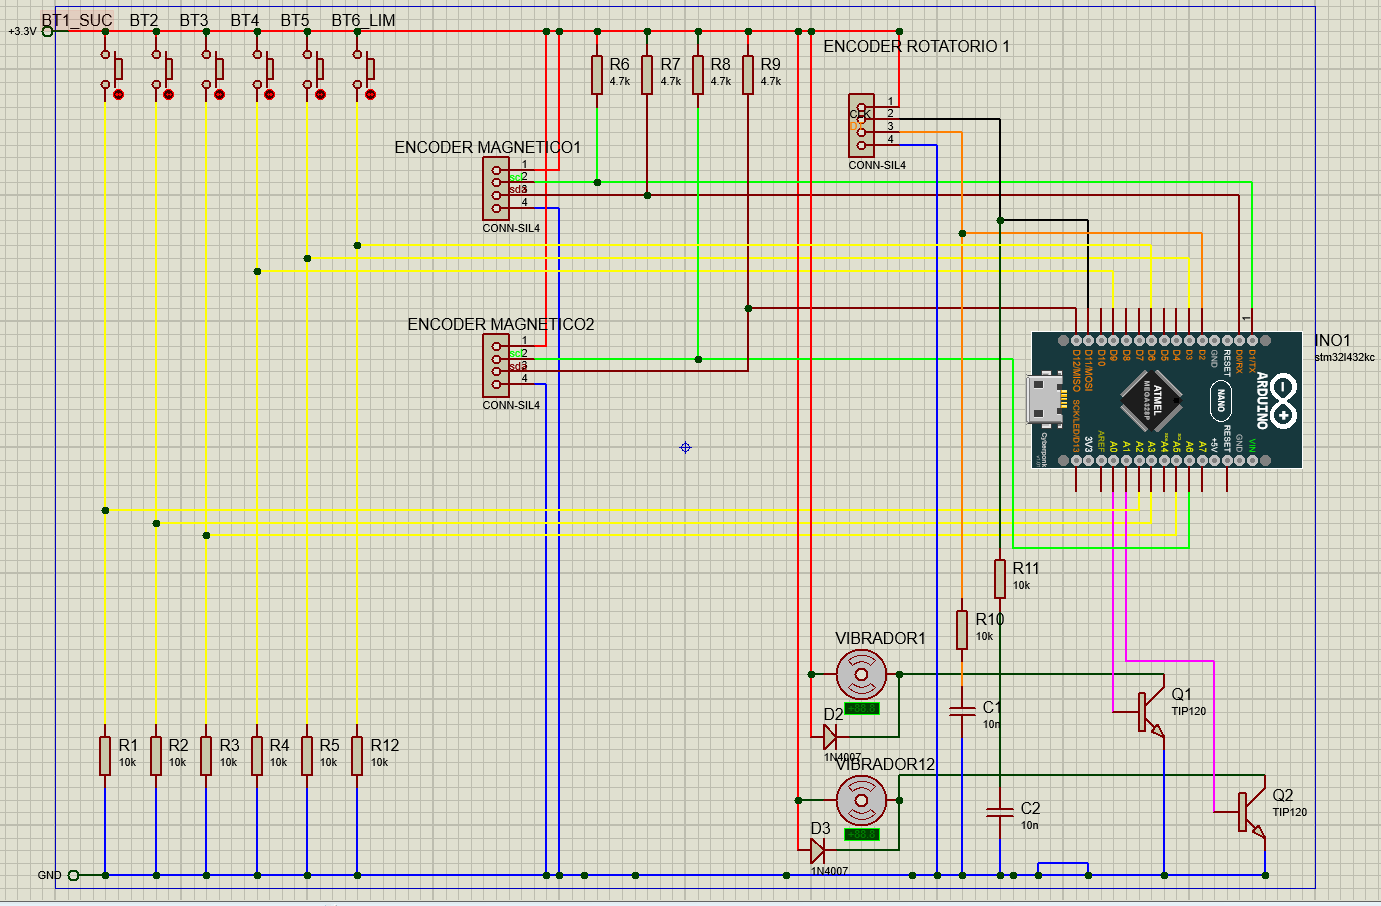
placa de circuito/circuito_proteus.PNG
