albale15/simulador_de_Extraccion_de_polipos_intestinales/listaDeMatertiales.xlsx

Sheet: Hoja1
Materiales |  | Precio por unidad/total | total bs.
circuito de control electrónico
STM32L432KC (Nucleo–L432KC) | 1 | 80 | 80
Encoder magnético AS5600 | 2 | 29 | 58
Capacitores cerámicos 10 nF | 4 | 2 | 8
Resistencias de pull-up 10 kΩ | 9 | 1 | 9
Resistencias serie 100 Ω | 2 | 1 | 2
Botones de acción momentánea | 5 | 11 | 55
Diodo tvs | 1 | 2 | 2
Vibrador tipo celular | 1 | 5 | 5
transistor NPN | 1 | 15 | 15
imu | 1 | 67.5 | 67.5
sensores Flex | 2 | 113.5 | 227
PCB(version final) | 1 | 50 | 50
USB-C para STM32 | 1 | 25 | 25
Cables(version final) | 1 | 30 | 30
elementos mecanicos
Filamento PETG | 1kg | 206 | 206
PLA | 1kg | 223 | 223
Tornillos M3 o M4 | 20-30 | 30 | 30
Tuercas insertables M3 o M4 | 20-30 | 15 | 15
Ejes metálicos para el encoder (en funcion del diseño) | 5mm-6mm | 140 | 140
Rodamientos(en funcion del diseño) | 2 | 8 | 16
Topes de goma | 2 | 10 | 20
Tubo flexible TPU | 1 m | 56 | 56
Patas de silicona antideslizante | 4 | 15 | 60
 |  | total esperado: | 1399.5

Sheet: Hoja2
M+B4:E40ateriales |  | Precio por unidad/total | total bs.
Módulo de Procesamiento y Gráficos
Placa de Desarrollo STM32 Nucleo-32: | 1 | 220 | 220
Cable USB a Micro-USB | 1 | 52 | 52
elementos electronicos o insumos electronicos |  |  | 0
Tiras de Espadines Hembra | 2 | 4 | 8
bornera conectores por tornillo de 2 | 4 | 2 | 8
Transistores TIP120 | 2 | 3 | 6
Diodos Rectificadores 1N4007 | 2 | 2 | 4
Resistencias de 4.7kΩ | 4 | 1 | 4
Resistencias de 10kΩ | 8 | 1 | 8
capacitor ceramico de 10 nf | 2 | 2 | 4
cable de telefono ( metros) | 2 | 5 | 10
cable lan (metros) | 2 | 10 | 20
botones autorretorno con tuerca | 5 | 5 | 25
Módulo Sensorial y Háptico |  |  | 0
Sensor Magnético I2C AS5600 | 2 | 25 | 50
Encoders Rotatorios Modulares HW-040 | 1 | 20 | 20
Motores Vibradores (Micro-motores tipo moneda) | 2 | 5 | 10
Módulo de Procesamiento y Gráficos |  |  | 0
PLA(experimental como produccion)kg | 3 | 223 | 669
tiempo de uso en una impresora 3d (propia) horas | 105 | 12 | 1260
Tornillos M3/M4 (por lote) | 1 | 60 | 60
Tuercas insertables M3/M4 (por lote) | 1 | 60 | 60
Tubo flexible TPU / manguera (metros) | 3 | 20 | 60
barras de psilicona | 2 | 2 | 4
tira de goma 1/4 demetro | 1 | 45 | 45
medios exernos usados |  |  | 0
creacion de pcb por cnc (costo de todas las placas) | 1 | 150 | 150
trabajo propio con las faces de experimentacion |  |  | 0
diseño del circuito (dias) | 18 | 240 | 4320
diseño mecanico solidworks (dias) | 34 | 240 | 8160
programacion del circuito | 12 | 240 | 2880
programacion del programa en unity | 44 | 240 | 10560
pruebas de funcionamiento | 7 | 240 | 1680
soldadura por horas (con materia prima) | 7 | 20 | 140
 |  | total esperado: | 30497

Sheet: Hoja3
Componente | Cantidad | Costo unitario (Bs.) | Subtotal (Bs.)
Placa STM32 Nucleo-32 | 1 | 220 | 220
Cable USB a Micro-USB | 1 | 52 | 52
Tiras de espadines hembra | 2 | 4 | 8
Borneras conectoras por tornillo | 4 | 2 | 8
Transistores TIP120 | 2 | 3 | 6
Diodos rectificadores 1N4007 | 2 | 2 | 4
Resistencias de 4.7 kΩ | 4 | 1 | 4
Resistencias de 10 kΩ | 8 | 1 | 8
Capacitores cerámicos de 10 nF | 2 | 2 | 4
Cable telefónico | 2 m | 5 | 10
Cable LAN | 2 m | 10 | 20
Botones autorretorno con tuerca | 5 | 5 | 25
Total materiales electrónicos |  |  | 369 Bs.
Componente | Cantidad | Costo unitario (Bs.) | Subtotal (Bs.)
Sensor magnético I2C AS5600 | 2 | 25 | 50
Encoders rotatorios modulares HW-040 | 1 | 20 | 20
Motores vibradores tipo moneda | 2 | 5 | 10
Total módulo sensorial y háptico |  |  | 80 Bs.
Componente | Cantidad | Costo unitario (Bs.) | Subtotal (Bs.)
PLA para impresión 3D | 3 kg | 223 | 669
Tiempo de impresión 3D | 105 h | 12 | 1260
Tornillos M3/M4 (por lote) | 1 | 60 | 60
Tuercas insertables M3/M4 | 1 | 60 | 60
Tubo flexible TPU / manguera | 3 m | 20 | 60
Barras de silicona | 2 | 2 | 4
Tira de goma 1/4 de metro | 1 | 45 | 45
Total materiales mecánicos y fabricación |  |  | 2158 Bs.
Concepto | Cantidad | Costo unitario (Bs.) | Subtotal (Bs.)
Fabricación de PCB por CNC | 1 | 150 | 150
Total fabricación externa |  |  | 150 Bs.
Actividad | Cantidad (12h x dia) | Costo unitario (20Bs. x 1h) | Subtotal (Bs.)
Diseño del circuito | 18 días | 240 | 4320
Diseño mecánico en SolidWorks | 34 días | 240 | 8160
Programación del circuito | 12 días | 240 | 2880 | 30437
Programación en Unity | 44 días | 240 | 10560
Pruebas de funcionamiento | 7 días | 240 | 1680
Soldadura y ensamblaje | 4 horas | 20 | 80
Total mano de obra y desarrollo |  |  | 27680 Bs.
Categoría | Total (Bs.)
Materiales electrónicos | 369
Módulo sensorial y háptico | 80
Materiales mecánicos y fabricación | 2158
Fabricación externa | 150
Mano de obra y desarrollo | 27680
Costo total del prototipo | 30437 Bs.
