albale15/simulador_de_Extraccion_de_polipos_intestinales/INFORME/evidencias.xlsx

Sheet: botones y volante prueba 1 y 2
 |  |  |  |  |  |  |  |  |  | Prueba de volantes <10° por deteccion, con giros de 360
 | Prueba de los 100 tiros para cada boton y encoder rotativo |  |  |  |  |  |  |  |  |  | Volante 1 Izquierda |  | Volante 1 Derecha
 | Numero de Pulsacion | Boton 1 | Boton 2 | Boton 3 | Boton 4 | Boton Lim | Boton Su | Encoder Incercion | Encoder Extraccion | Numero de giro | pulsos detectados | grados estimado por pulso | pulsos detectados | grados estimado por pulso
 | 1 | 1 | 1 | 1 | 1 | 1 | 1 | 1 | 1 | 1 | 51 | 7.06 | 48 | 7.5
 | 2 | 1 | 1 | 1 | 1 | 1 | 1 | 0 | 1 | 2 | 45 | 8.00 | 46 | 7.826086957
 | 3 | 1 | 1 | 1 | 1 | 1 | 1 | 1 | 1 | 3 | 46 | 7.83 | 45 | 8
 | 4 | 1 | 1 | 1 | 1 | 1 | 1 | 1 | 1 | 4 | 46 | 7.83 | 45 | 8
 | 5 | 1 | 1 | 1 | 1 | 1 | 1 | 1 | 1 | 5 | 45 | 8.00 | 46 | 7.826086957 | Prueba de los 100 tiros para cada boton y encoder rotativo |  |  |  | Prueba de volantes <10° por deteccion, con giros de 360
 | 6 | 1 | 1 | 1 | 1 | 1 | 1 | 1 | 1 | 6 | 45 | 8.00 | 47 | 7.659574468 | Elemento | Número de Tiros | Tiros Detectados | Porcentage de Errores | Elemento | grado calculado | media de grados | desviacion en grados
 | 7 | 1 | 1 | 1 | 1 | 1 | 1 | 1 | 1 | 7 | 46 | 7.83 | 45 | 8 | Boton 1 | 100 | 100 | 0.0% | volante 1 izq. | 8 | 7.82 | 0.18
 | 8 | 1 | 1 | 1 | 1 | 1 | 1 | 1 | 1 | 8 | 46 | 7.83 | 46 | 7.826086957 | Boton 2 | 100 | 100 | 0.0% | volante 1 der. | 8 | 7.83 | 0.17
 | 9 | 1 | 1 | 1 | 1 | 1 | 1 | 1 | 0 | 9 | 46 | 7.83 | 45 | 8 | Boton 3 | 100 | 99 | 1.0% | volante 2 izq. | 8 | 7.95 | 0.05
 | 10 | 1 | 1 | 1 | 1 | 1 | 1 | 1 | 1 | 10 | 45 | 8.00 | 47 | 7.659574468 | Boton 4 | 100 | 100 | 0.0% | volante 2 der. | 8 | 7.97 | 0.03
 | 11 | 1 | 1 | 1 | 1 | 1 | 1 | 1 | 1 | total |  | 7.82 |  | 7.83 | Boton lim | 100 | 100 | 0.0%
 | 12 | 1 | 1 | 1 | 1 | 1 | 1 | 1 | 1 |  |  |  |  |  | Boton su | 100 | 99 | 1.0%
 | 13 | 1 | 1 | 1 | 1 | 1 | 1 | 1 | 1 |  |  |  |  |  | encoder inc. | 100 | 98 | 2.0%
 | 14 | 1 | 1 | 1 | 1 | 1 | 1 | 1 | 1 |  |  |  |  |  | encoder ext. | 100 | 98 | 2.0%
 | 15 | 1 | 1 | 0 | 1 | 1 | 1 | 1 | 1 | Prueba de volantes <10° por deteccion, con giros de 360
 | 16 | 1 | 1 | 1 | 1 | 1 | 1 | 1 | 1 |  | Volante 2 Izquierda |  | Volante 2 Derecha
 | 17 | 1 | 1 | 1 | 1 | 1 | 0 | 1 | 1 | Numero de giro | pulsos detectados | grados estimado por pulso | pulsos detectados | grados estimado por pulso
 | 18 | 1 | 1 | 1 | 1 | 1 | 1 | 1 | 1 | 1 | 44 | 8.181818182 | 42 | 8.571428571
 | 19 | 1 | 1 | 1 | 1 | 1 | 1 | 1 | 1 | 2 | 45 | 8 | 46 | 7.826086957
 | 20 | 1 | 1 | 1 | 1 | 1 | 1 | 1 | 1 | 3 | 46 | 7.826086957 | 45 | 8
 | 21 | 1 | 1 | 1 | 1 | 1 | 1 | 1 | 1 | 4 | 46 | 7.826086957 | 46 | 7.826086957
 | 22 | 1 | 1 | 1 | 1 | 1 | 1 | 1 | 1 | 5 | 44 | 8.181818182 | 45 | 8
 | 23 | 1 | 1 | 1 | 1 | 1 | 1 | 1 | 1 | 6 | 46 | 7.826086957 | 46 | 7.826086957
 | 24 | 1 | 1 | 1 | 1 | 1 | 1 | 1 | 1 | 7 | 47 | 7.659574468 | 45 | 8
 | 25 | 1 | 1 | 1 | 1 | 1 | 1 | 1 | 1 | 8 | 44 | 8.181818182 | 46 | 7.826086957
 | 26 | 1 | 1 | 1 | 1 | 1 | 1 | 1 | 1 | 9 | 46 | 7.826086957 | 45 | 8
 | 27 | 1 | 1 | 1 | 1 | 1 | 1 | 1 | 1 | 10 | 45 | 8 | 46 | 7.826086957
 | 28 | 1 | 1 | 1 | 1 | 1 | 1 | 1 | 1 | total |  | 7.95 |  | 7.97
 | 29 | 1 | 1 | 1 | 1 | 1 | 1 | 1 | 1
 | 30 | 1 | 1 | 1 | 1 | 1 | 1 | 1 | 1
 | 31 | 1 | 1 | 1 | 1 | 1 | 1 | 1 | 1
 | 32 | 1 | 1 | 1 | 1 | 1 | 1 | 1 | 1
 | 33 | 1 | 1 | 1 | 1 | 1 | 1 | 1 | 1
 | 34 | 1 | 1 | 1 | 1 | 1 | 1 | 1 | 1
 | 35 | 1 | 1 | 1 | 1 | 1 | 1 | 1 | 1
 | 36 | 1 | 1 | 1 | 1 | 1 | 1 | 1 | 1
 | 37 | 1 | 1 | 1 | 1 | 1 | 1 | 1 | 1
 | 38 | 1 | 1 | 1 | 1 | 1 | 1 | 1 | 1
 | 39 | 1 | 1 | 1 | 1 | 1 | 1 | 1 | 1
 | 40 | 1 | 1 | 1 | 1 | 1 | 1 | 1 | 1
 | 41 | 1 | 1 | 1 | 1 | 1 | 1 | 1 | 1
 | 42 | 1 | 1 | 1 | 1 | 1 | 1 | 1 | 1
 | 43 | 1 | 1 | 1 | 1 | 1 | 1 | 1 | 1
 | 44 | 1 | 1 | 1 | 1 | 1 | 1 | 1 | 1
 | 45 | 1 | 1 | 1 | 1 | 1 | 1 | 1 | 1
 | 46 | 1 | 1 | 1 | 1 | 1 | 1 | 1 | 1
 | 47 | 1 | 1 | 1 | 1 | 1 | 1 | 1 | 1
 | 48 | 1 | 1 | 1 | 1 | 1 | 1 | 1 | 1
 | 49 | 1 | 1 | 1 | 1 | 1 | 1 | 1 | 1
 | 50 | 1 | 1 | 1 | 1 | 1 | 1 | 1 | 1
 | 51 | 1 | 1 | 1 | 1 | 1 | 1 | 1 | 1
 | 52 | 1 | 1 | 1 | 1 | 1 | 1 | 1 | 1
 | 53 | 1 | 1 | 1 | 1 | 1 | 1 | 1 | 1
 | 54 | 1 | 1 | 1 | 1 | 1 | 1 | 1 | 1
 | 55 | 1 | 1 | 1 | 1 | 1 | 1 | 1 | 1
 | 56 | 1 | 1 | 1 | 1 | 1 | 1 | 1 | 1
 | 57 | 1 | 1 | 1 | 1 | 1 | 1 | 1 | 1
 | 58 | 1 | 1 | 1 | 1 | 1 | 1 | 1 | 1
 | 59 | 1 | 1 | 1 | 1 | 1 | 1 | 1 | 1
 | 60 | 1 | 1 | 1 | 1 | 1 | 1 | 1 | 1
 | 61 | 1 | 1 | 1 | 1 | 1 | 1 | 1 | 1
 | 62 | 1 | 1 | 1 | 1 | 1 | 1 | 1 | 1
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
 | Lim:0 Su:0 B1:0 B2:0 B3:0 B4:0 E1:0 E2:0 INS:-1
 | Lim:0 Su:0 B1:0 B2:0 B3:0 B4:0 E1:0 E2:0 INS:-1
 | Lim:0 Su:0 B1:0 B2:0 B3:0 B4:0 E1:0 E2:0 INS:-1
 | Lim:0 Su:0 B1:0 B2:0 B3:0 B4:0 E1:0 E2:0 INS:-1
 | Lim:0 Su:0 B1:0 B2:0 B3:0 B4:0 E1:0 E2:0 INS:-1

Sheet: prueba 3 y 4 atencia fps
 |  |  |  |  |  | Tasa de Refresco - FPS (60 fps)
 |  |  |  |  |  | FPS | Promedio | Min | Max
 |  |  |  |  | 1 | 59 | 59 | 59 | 59
 |  |  |  |  | 2 | 59 | 60 | 56 | 66
 |  |  |  |  | 3 | 60 | 60 | 55 | 67
 |  |  |  |  | 4 | 61 | 60 | 55 | 67
 |  |  |  |  | 5 | 58 | 60 | 55 | 67
 |  |  |  |  | 6 | 59 | 60 | 55 | 67
 |  |  |  |  | 7 | 61 | 60 | 52 | 73
 |  |  |  |  | 8 | 58 | 60 | 52 | 73
 |  |  |  |  | 9 | 61 | 60 | 30 | 351
 |  |  |  |  | 10 | 59 | 60 | 30 | 351
 |  |  |  |  | 11 | 60 | 60 | 30 | 351
 | Prueba de Latencia con Acciones en el Endoscopio Fisico
 | Boton 1 | Boton 2 | Boton 3 | Boton 4 | Boton Lim | Boton Su | Encoder Incercion | Encoder Extraccion | Volante 1 Izquierda | Volante 1 Derecha | Volante 2 Izquierda | Volante 2 Derecha | Prueba de Latencia con Acciones en el Endoscopio Fisico
1 | 16 | 16 | 17 | 16 | 16 | 16 | 17 | 19 | 16 | 17 | 16 | 17 | Elemetos | botones | Volantes | Encoders | total
2 | 16 | 16 | 16 | 16 | 16 | 16 | 16 | 13 | 16 | 16 | 16 | 15 | Promedio | 16.05 | 15.95 | 16.125 | 16.04
3 | 16 | 16 | 16 | 16 | 16 | 16 | 15 | 16 | 16 | 16 | 16 | 16
4 | 16 | 16 | 16 | 16 | 16 | 16 | 16 | 17 | 17 | 16 | 16 | 16
5 | 16 | 16 | 16 | 16 | 16 | 16 | 16 | 17 | 16 | 16 | 16 | 17
6 | 16 | 16 | 16 | 16 | 16 | 16 | 16 | 15 | 16 | 16 | 16 | 16
7 | 16 | 16 | 17 | 16 | 16 | 16 | 16 | 16 | 16 | 16 | 16 | 16
8 | 16 | 16 | 16 | 17 | 16 | 16 | 16 | 16 | 16 | 16 | 16 | 16
9 | 16 | 16 | 16 | 16 | 16 | 16 | 16 | 16 | 16 | 16 | 16 | 16
10 | 16 | 16 | 16 | 16 | 16 | 16 | 16 | 16 | 16 | 15 | 16 | 16
11 | 16 | 16 | 17 | 16 | 16 | 16 | 16 | 16 | 16 | 16 | 16 | 16
12 | 17 | 16 | 16 | 16 | 16 | 16 | 16 | 20 | 17 | 16 | 16 | 16
13 | 16 | 16 | 16 | 16 | 16 | 16 | 16 | 16 | 16 | 16 | 16 | 16
14 | 16 | 17 | 16 | 16 | 16 | 16 | 16 | 16 | 16 | 16 | 15 | 16
15 | 16 | 16 | 16 | 16 | 16 | 16 | 16 | 16 | 16 | 16 | 17 | 16
16 | 16 | 16 | 16 | 16 | 16 | 16 | 16 | 16 | 16 | 16 | 16 | 17
17 | 16 | 16 | 16 | 16 | 16 | 16 | 16 | 16 | 16 | 16 | 16 | 16
18 | 15 | 16 | 16 | 16 | 16 | 16 | 16 | 16 | 16 | 16 | 16 | 16
19 | 16 | 16 | 16 | 16 | 16 | 16 | 16 | 16 | 8 | 16 | 16 | 16
20 | 16 | 16 | 16 | 16 | 16 | 17 | 16 | 16 | 16 | 16 | 16 | 16
Promedio: | 16 | 16.05 | 16.15 | 16.05 | 16 | 16.05 | 16 | 16.25 | 15.7 | 16 | 16 | 16.1

Sheet: prueba 3 bloque 2
prueba 3 bloque 2
 | Avance del endoscopio por centimetros
 | Prueba | Avance fisico cm | Avance virtual cm | Porcentage de error
 | 1 | 9.9 | 10 | 1.00%
 | 2 | 20 | 20.3 | 1.48%
 | 3 | 5.4 | 5 | 8.00%
 | 4 | 16 | 15 | 6.67%
 | 5 | 25 | 25.5 | 1.96%
 | 6 | 32.8 | 30 | 9.33%
 | 7 | 34.8 | 35 | 0.57%
 | 8 | 9.7 | 10 | 3.00%
 | 9 | 21.5 | 22 | 2.27%
 | 10 | 32.5 | 33 | 1.52%
 |  |  | promedio de error: | 3.58%
 | Retroceso del endoscopio por centimetros
 | Prueba | Retroceso fisico cm | Retroceso virtual cm | porcentage de error
 | 1 | 9.2 | 10 | 8.00%
 | 2 | 18.2 | 20 | 9.00%
 | 3 | 4.6 | 5 | 8.00%
 | 4 | 16 | 15 | 6.67%
 | 5 | 23 | 25 | 8.00%
 | 6 | 32 | 30 | 6.67%
 | 7 | 32 | 35 | 8.57%
 | 8 | 9.1 | 10 | 9.00%
 | 9 | 21 | 22 | 4.55%
 | 10 | 33.2 | 33 | 0.61%
 |  |  | promedio de error: | 6.91%

Sheet: analisis de costos
Componente | Cantidad | Costo unitario (Bs.) | Subtotal (Bs.)
Placa STM32 Nucleo-32 | 1 | 220 | 220
Cable USB a Micro-USB | 1 | 52 | 52
Tiras de espadines hembra | 2 | 4 | 8
Borneras conectoras por tornillo | 4 | 2 | 8
Transistores TIP120 | 2 | 3 | 6
Diodos rectificadores 1N4007 | 2 | 2 | 4
Resistencias de 4.7 kΩ | 4 | 1 | 4
Resistencias de 10 kΩ | 8 | 1 | 8
Capacitores cerámicos de 10 nF | 2 | 2 | 4
Cable telefónico | 2 m | 5 | 10
Cable LAN | 2 m | 10 | 20
Botones autorretorno con tuerca | 5 | 5 | 25
Total materiales electrónicos |  |  | 369 Bs.
Componente | Cantidad | Costo unitario (Bs.) | Subtotal (Bs.)
Sensor magnético I2C AS5600 | 2 | 25 | 50
Encoders rotatorios modulares HW-040 | 1 | 20 | 20
Motores vibradores tipo moneda | 2 | 5 | 10
Total módulo sensorial y háptico |  |  | 80 Bs.
Componente | Cantidad | Costo unitario (Bs.) | Subtotal (Bs.)
PLA para impresión 3D | 3 kg | 223 | 669
Tiempo de impresión 3D | 105 h | 12 | 1260
Tornillos M3/M4 (por lote) | 1 | 60 | 60
Tuercas insertables M3/M4 | 1 | 60 | 60
Tubo flexible TPU / manguera | 3 m | 20 | 60
Barras de silicona | 2 | 2 | 4
Tira de goma 1/4 de metro | 1 | 45 | 45
Total materiales mecánicos y fabricación |  |  | 2158 Bs.
Concepto | Cantidad | Costo unitario (Bs.) | Subtotal (Bs.)
Fabricación de PCB por CNC | 1 | 150 | 150
Total fabricación externa |  |  | 150 Bs.
Actividad | Cantidad (12h x dia) | Costo unitario (20Bs. x 1h) | Subtotal (Bs.)
Diseño del circuito | 18 días | 240 | 4320
Diseño mecánico en SolidWorks | 34 días | 240 | 8160
Programación del circuito | 12 días | 240 | 2880
Programación en Unity | 44 días | 240 | 10560
Pruebas de funcionamiento | 7 días | 240 | 1680
Soldadura y ensamblaje | 4 horas | 20 | 80
Total mano de obra y desarrollo |  |  | 27680 Bs.
Categoría | Total (Bs.)
Materiales electrónicos | 369
Módulo sensorial y háptico | 80
Materiales mecánicos y fabricación | 2158
Fabricación externa | 150
Mano de obra y desarrollo | 27680
Costo total del prototipo | 30437 Bs.

Sheet: Hoja1
Nombre de prueba | resumen porsentaje de errores
Boton 1 | 0.00%
Boton 2 | 0.00%
Boton 3 | 1.00%
Boton 4 | 0.00%
Boton lim | 0.00%
Boton su | 1.00%
encoder inc. | 2.00%
encoder ext. | 2.00%
volante 1 izq. | 0.18
volante 1 der. | 0.17
volante 2 izq. | 0.05
volante 2 der. | 0.03
Avance del endoscopio por centimetros
1 | 1.00% | 3.58%
2 | 1.48% | 3.58%
3 | 8.00% | 3.58%
4 | 6.67% | 3.58%
5 | 1.96% | 3.58%
6 | 9.33% | 3.58%
7 | 0.57% | 3.58%
8 | 3.00% | 3.58%
9 | 2.27% | 3.58%
10 | 1.52% | 3.58%
Retroceso del endoscopio por centimetros
1 | 8.00% | 6.91%
2 | 9.00% | 6.91%
3 | 8.00% | 6.91%
4 | 6.67% | 6.91%
5 | 8.00% | 6.91%
6 | 6.67% | 6.91%
7 | 8.57% | 6.91%
8 | 9.00% | 6.91%
9 | 4.55% | 6.91%
10 | 0.61% | 6.91%
