albale15/simulador_de_Extraccion_de_polipos_intestinales/modelo de el sistema en mesa/EnsamblajeMecanismo de insercion.SLDASM

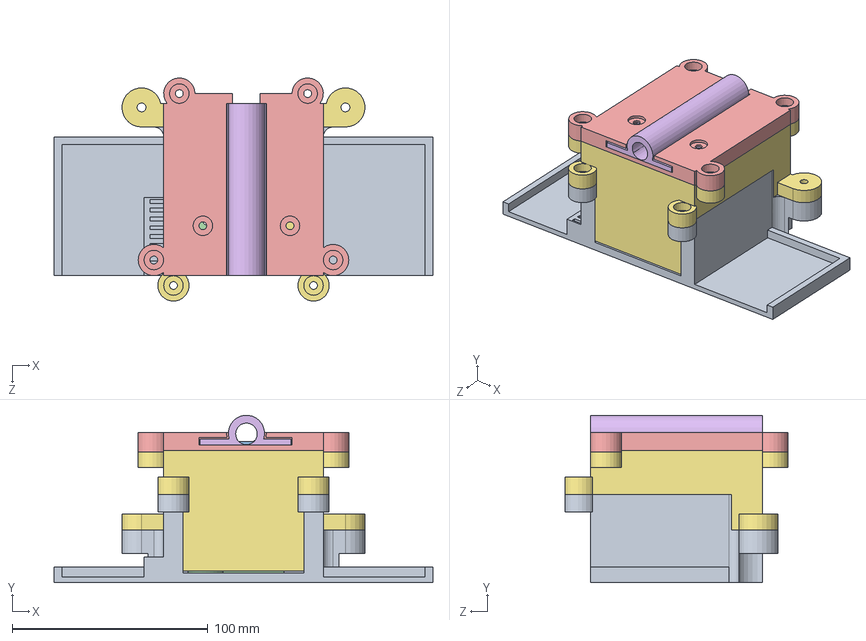
[picture p72: CAD file, 2026-05-27]
modelo de el sistema en mesa/EnsamblajeMecanismo de insercion.SLDASM
193.6 x 85.4 x 114.0 mm
BaseEncodersEngranes
EngraneEncoderR2
EngraneRuedaR2
ParedSoporteEngranes
parte1TapaEngranes
parte2TapaEngranes
parteMediaCajaEngraness
