albale15/simulador_de_Extraccion_de_polipos_intestinales/modelo endoscopio centro de mando/EnsamblajemodeloEndoscopi.SLDASM

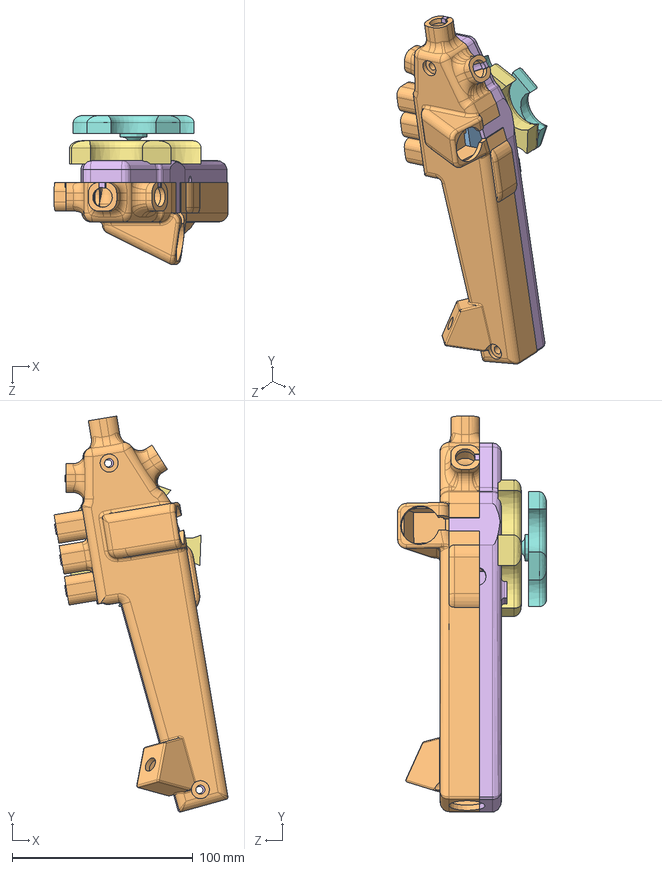
[picture p73: CAD file, 2026-05-24]
modelo endoscopio centro de mando/EnsamblajemodeloEndoscopi.SLDASM
96.3 x 219.2 x 82.5 mm
agarres
base carcasa
caja de encoders
engrane1
engrane2
tapa
volante1
volante2
