albale15/simulador_de_Extraccion_de_polipos_intestinales/modelo de el sistema en mesa/imprimir/configuracion de impresion/CE3E3V2_parteMediaCajaEngranes.3mf

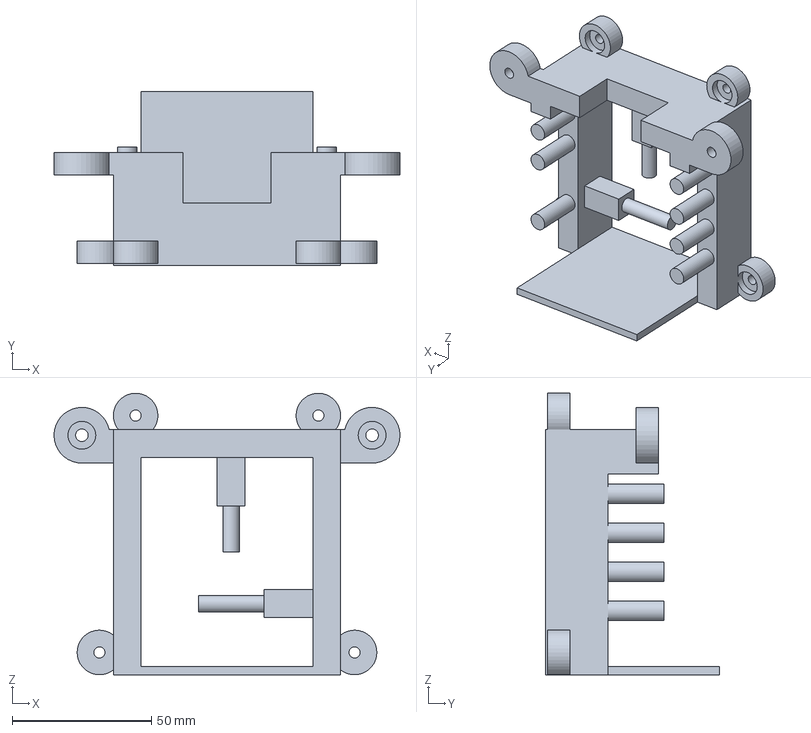
[picture p74: CAD file, 2026-04-19]
modelo de el sistema en mesa/imprimir/configuracion de impresion/CE3E3V2_parteMediaCajaEngranes.3mf
124.1 x 62.5 x 101.0 mm
