albale15/simulador_de_Extraccion_de_polipos_intestinales/modelo de el sistema en mesa/imprimir/tapaCable.STL

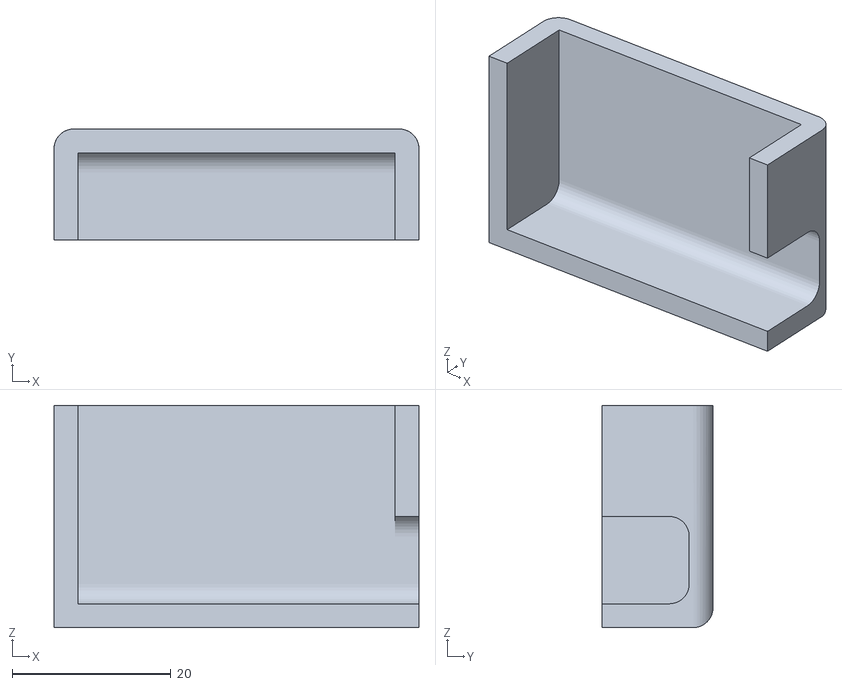
[picture p75: CAD file, 2026-06-24]
modelo de el sistema en mesa/imprimir/tapaCable.STL
46.0 x 14.0 x 28.0
