albale15/simulador_de_Extraccion_de_polipos_intestinales/modelo endoscopio centro de mando/engrane2.SLDPRT

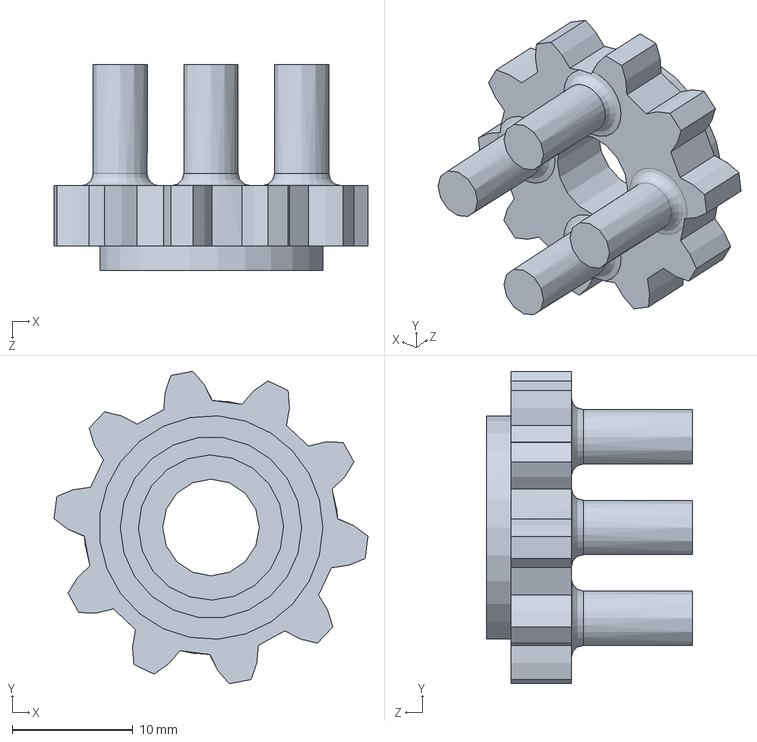
[picture p76: CAD file, 2026-05-27]
modelo endoscopio centro de mando/engrane2.SLDPRT
26.0 x 25.8 x 17.0 mm
