albale15/simulador_de_Extraccion_de_polipos_intestinales/modelo endoscopio centro de mando/imprimir/tapa.STL

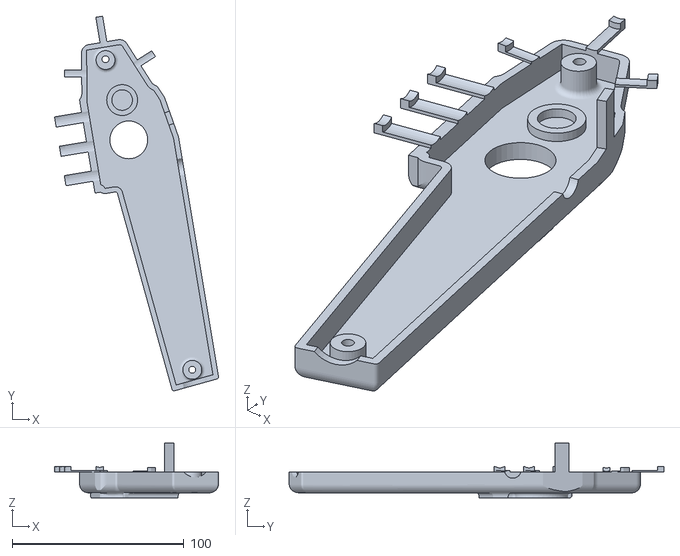
[picture p77: CAD file, 2026-05-24]
modelo endoscopio centro de mando/imprimir/tapa.STL
95.5 x 218.1 x 32.0
