albale15/simulador_de_Extraccion_de_polipos_intestinales/modelo endoscopio centro de mando/materia base/modelo4CarcasaSuelta.SLDPRT

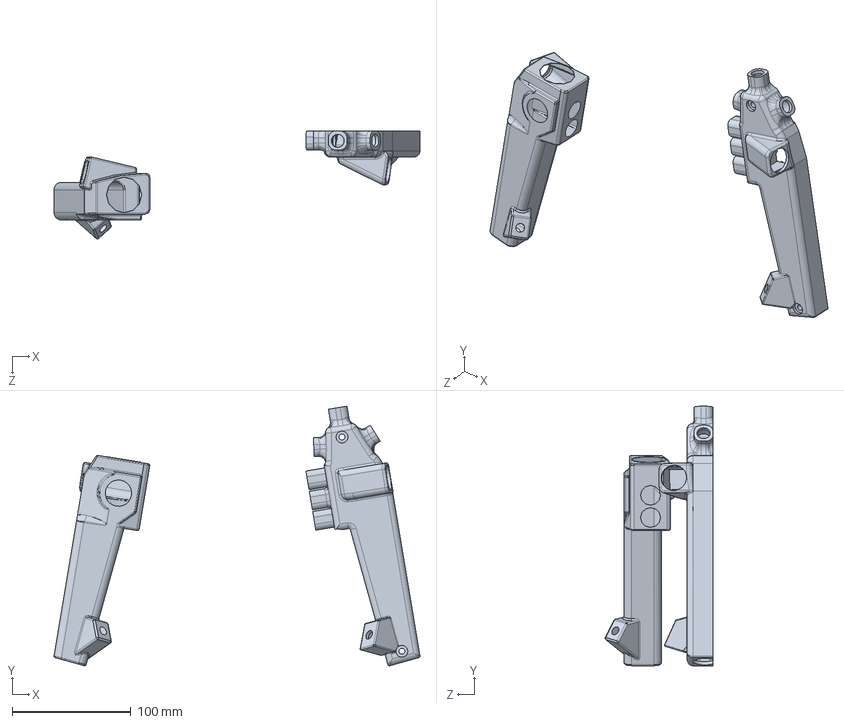
[picture p78: CAD file, 2026-04-09]
modelo endoscopio centro de mando/materia base/modelo4CarcasaSuelta.SLDPRT
308.9 x 219.1 x 91.2 mm
