albale15/simulador_de_Extraccion_de_polipos_intestinales/modelo endoscopio centro de mando/materia base/separacion de solidos/tapacircuitov1.SLDPRT

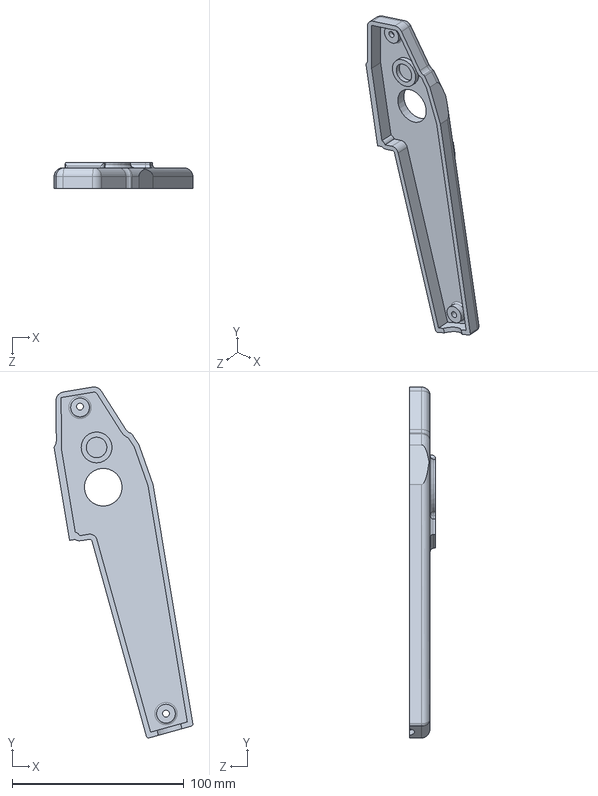
[picture p79: CAD file, 2026-04-09]
modelo endoscopio centro de mando/materia base/separacion de solidos/tapacircuitov1.SLDPRT
80.8 x 204.5 x 15.0 mm
