albale15/simulador_de_Extraccion_de_polipos_intestinales/modelo3CarcasaSuelta.SLDPRT

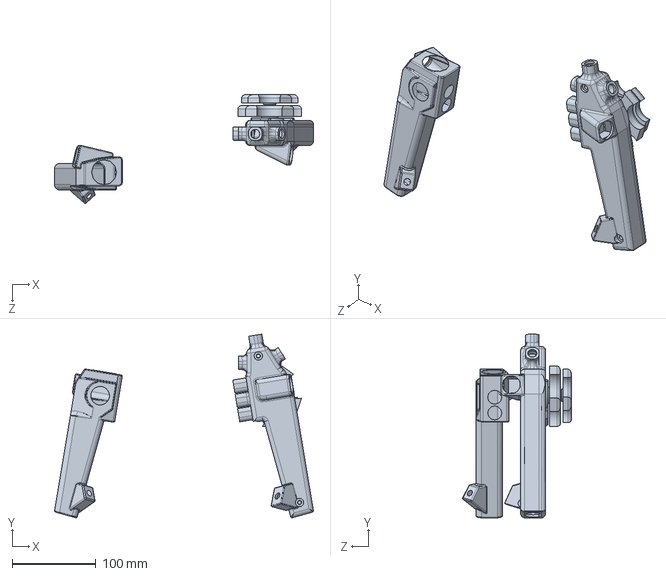
[picture p80: CAD file, 2026-04-06]
modelo3CarcasaSuelta.SLDPRT
308.9 x 219.1 x 130.0 mm
