albale15/simulador_de_Extraccion_de_polipos_intestinales/modelo de el sistema en mesa/estructura de insercion.SLDPRT

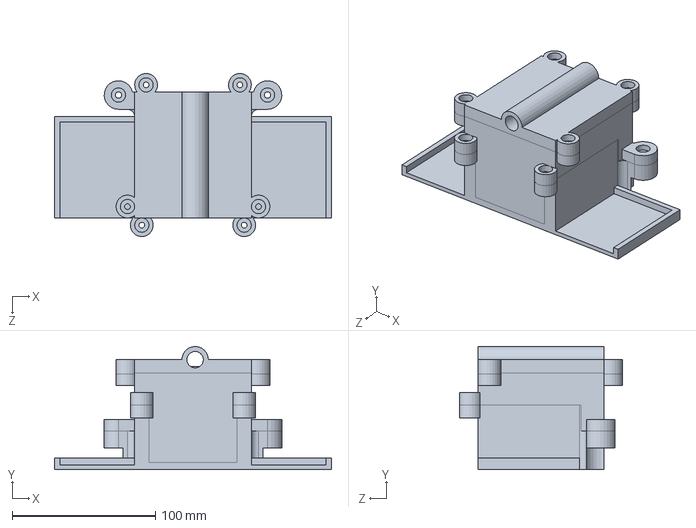
[picture p81: CAD file, 2026-05-16]
modelo de el sistema en mesa/estructura de insercion.SLDPRT
193.6 x 86.0 x 114.0 mm
