albale15/simulador_de_Extraccion_de_polipos_intestinales/modelo de el sistema en mesa/imprimir/ParedSoporteEngranes.STL

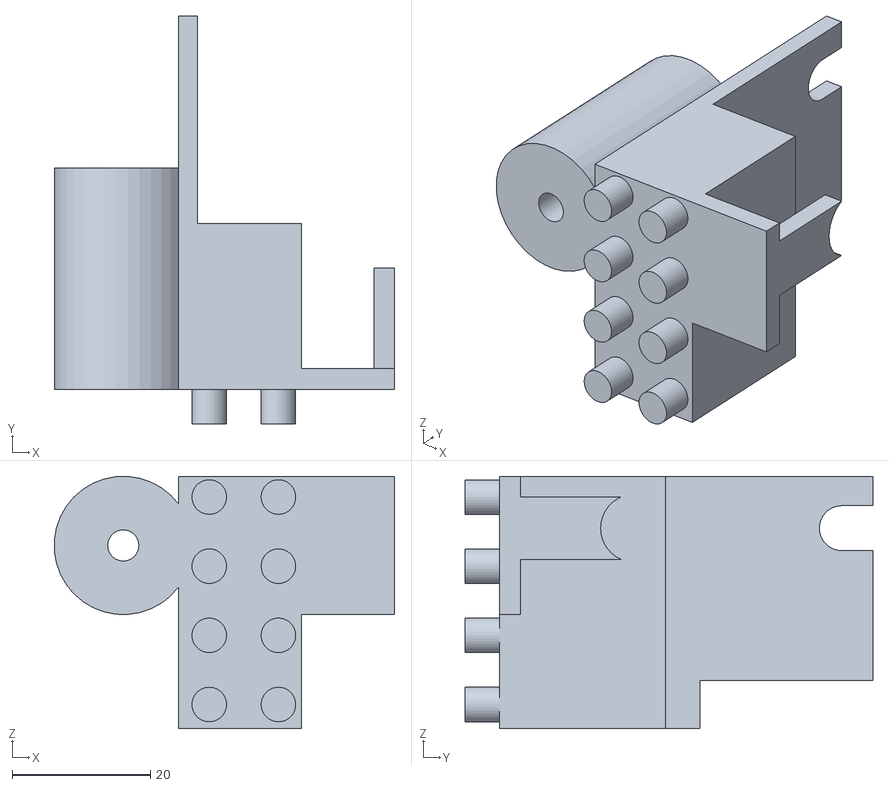
[picture p82: CAD file, 2026-05-24]
modelo de el sistema en mesa/imprimir/ParedSoporteEngranes.STL
49.2 x 59.0 x 36.5
