albale15/simulador_de_Extraccion_de_polipos_intestinales/modelo de el sistema en mesa/solidos separados/EngraneRuedaR2.SLDPRT

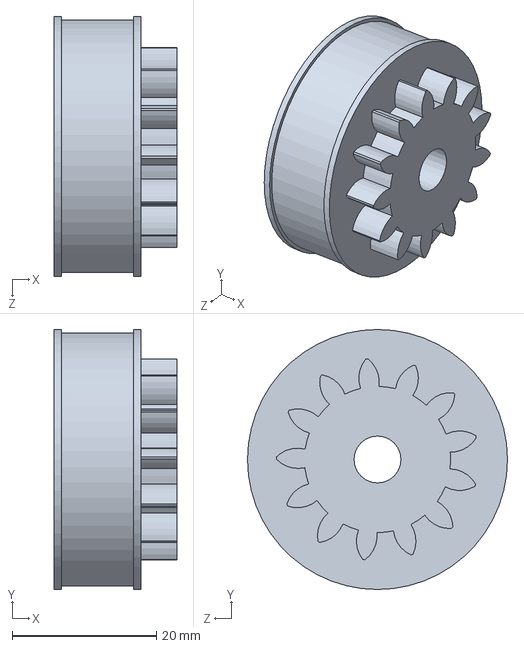
[picture p83: CAD file, 2026-05-27]
modelo de el sistema en mesa/solidos separados/EngraneRuedaR2.SLDPRT
17.0 x 36.0 x 36.0 mm
