albale15/simulador_de_Extraccion_de_polipos_intestinales/modelo endoscopio centro de mando/agarres.SLDPRT

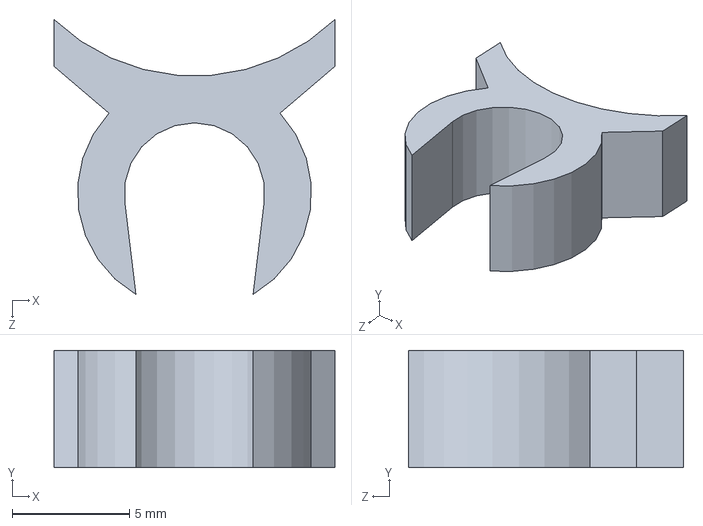
[picture p84: CAD file, 2026-05-24]
modelo endoscopio centro de mando/agarres.SLDPRT
12.0 x 5.00 x 11.7 mm
