albale15/simulador_de_Extraccion_de_polipos_intestinales/modelo endoscopio centro de mando/materia base/separacion de solidos/basecircuitov1.SLDPRT

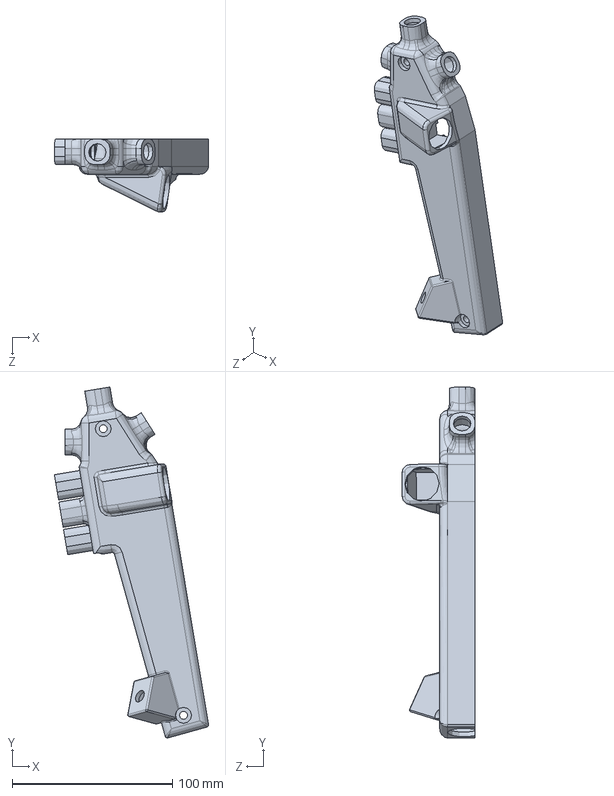
[picture p85: CAD file, 2026-04-09]
modelo endoscopio centro de mando/materia base/separacion de solidos/basecircuitov1.SLDPRT
96.3 x 219.0 x 45.5 mm
