albale15/simulador_de_Extraccion_de_polipos_intestinales/modelo de el sistema en mesa/imprimir/EngraneRuedaR2.STL

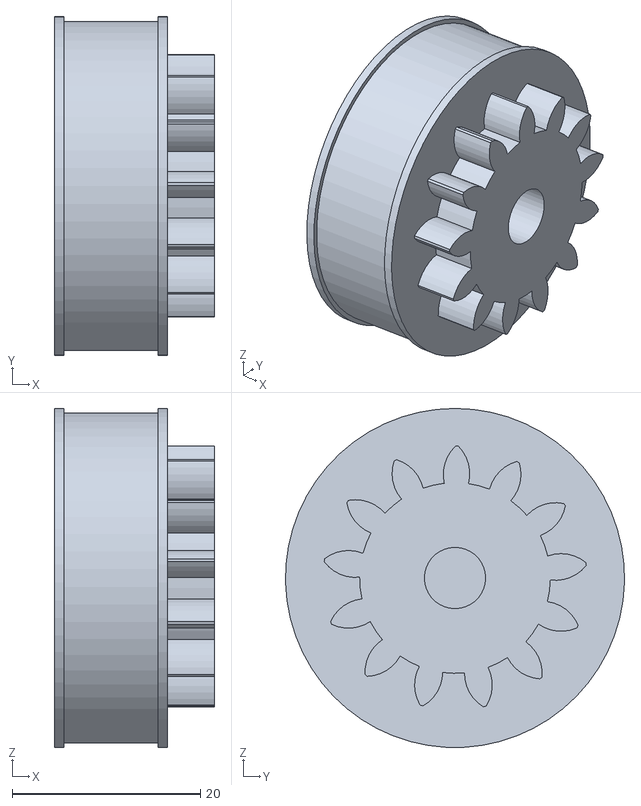
[picture p86: CAD file, 2026-05-24]
modelo de el sistema en mesa/imprimir/EngraneRuedaR2.STL
17.0 x 36.0 x 36.0
