albale15/simulador_de_Extraccion_de_polipos_intestinales/modelo endoscopio centro de mando/caja de encoders.SLDPRT

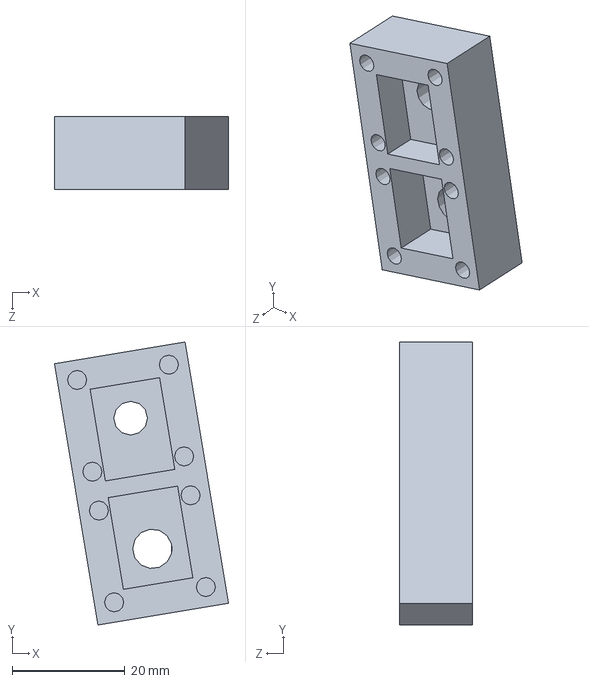
[picture p87: CAD file, 2026-05-24]
modelo endoscopio centro de mando/caja de encoders.SLDPRT
30.9 x 50.2 x 13.0 mm
