albale15/simulador_de_Extraccion_de_polipos_intestinales/modelo endoscopio centro de mando/imprimir/agarres2.STL

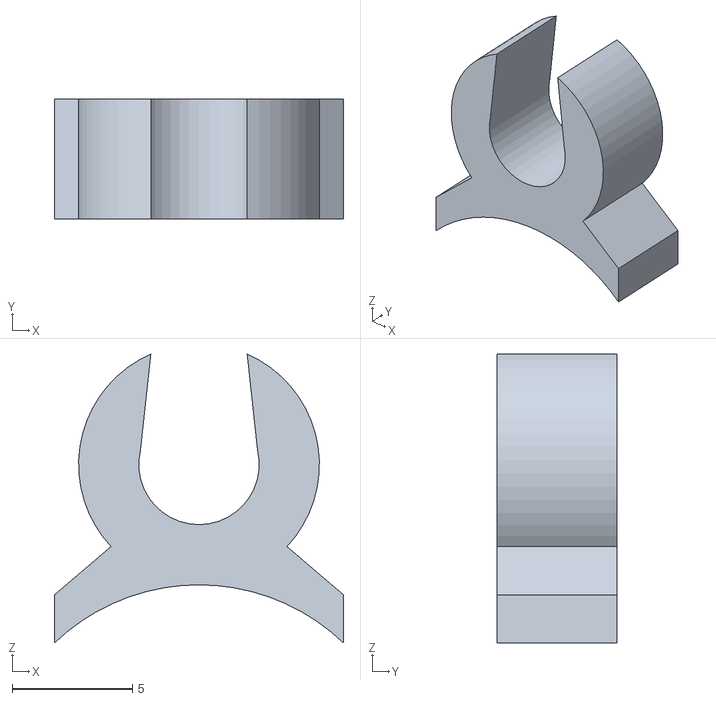
[picture p88: CAD file, 2026-05-24]
modelo endoscopio centro de mando/imprimir/agarres2.STL
12.0 x 5.00 x 12.0
