albale15/simulador_de_Extraccion_de_polipos_intestinales/modelo de el sistema en mesa/imprimir/BaseEncodersEngranes.STL

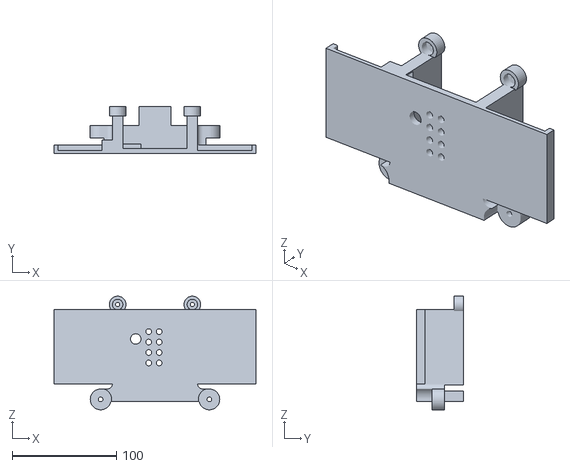
[picture p89: CAD file, 2026-05-18]
modelo de el sistema en mesa/imprimir/BaseEncodersEngranes.STL
193.6 x 45.0 x 108.9
