albale15/simulador_de_Extraccion_de_polipos_intestinales/modelo de el sistema en mesa/solidos separados/parte2TapaEngranes.SLDPRT

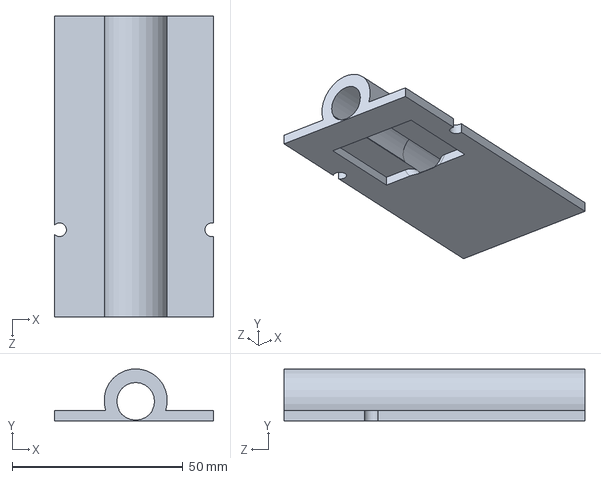
[picture p90: CAD file, 2026-05-18]
modelo de el sistema en mesa/solidos separados/parte2TapaEngranes.SLDPRT
46.5 x 15.2 x 88.0 mm
