albale15/simulador_de_Extraccion_de_polipos_intestinales/modelo endoscopio centro de mando/base carcasa.SLDPRT

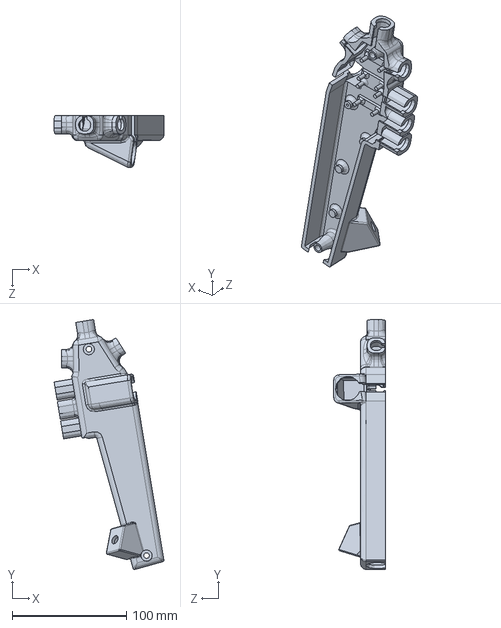
[picture p91: CAD file, 2026-05-24]
modelo endoscopio centro de mando/base carcasa.SLDPRT
96.3 x 219.0 x 45.5 mm
