albale15/simulador_de_Extraccion_de_polipos_intestinales/modelo endoscopio centro de mando/imprimir/engrane1.STL

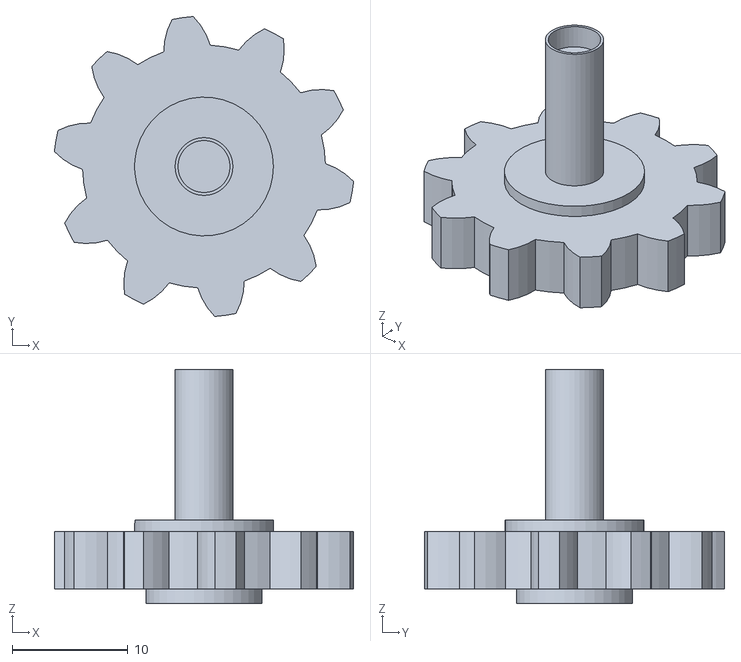
[picture p92: CAD file, 2026-05-24]
modelo endoscopio centro de mando/imprimir/engrane1.STL
25.9 x 25.9 x 20.2
