albale15/simulador_de_Extraccion_de_polipos_intestinales/modelo de el sistema en mesa/solidos separados/parteMediaCajaEngraness.SLDPRT

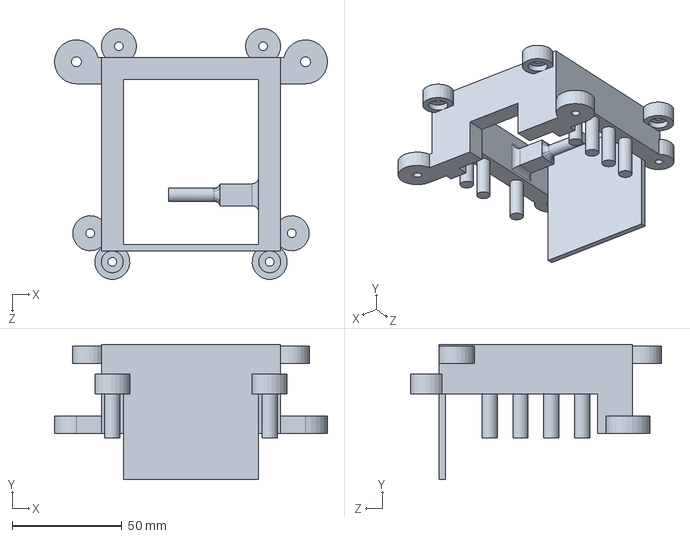
[picture p94: CAD file, 2026-05-18]
modelo de el sistema en mesa/solidos separados/parteMediaCajaEngraness.SLDPRT
124.1 x 61.5 x 114.0 mm
