albale15/simulador_de_Extraccion_de_polipos_intestinales/modelo endoscopio centro de mando/imprimir/volante2.STL

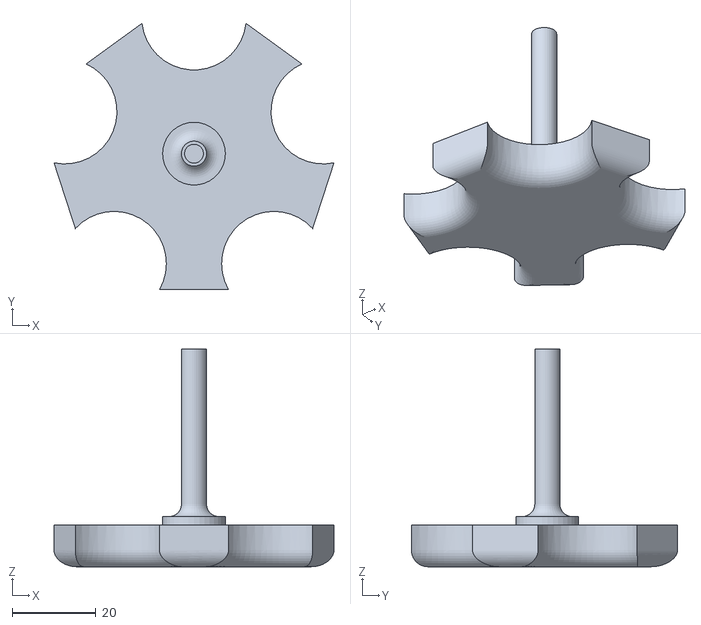
[picture p95: CAD file, 2026-05-12]
modelo endoscopio centro de mando/imprimir/volante2.STL
66.9 x 63.6 x 52.0
