albale15/simulador_de_Extraccion_de_polipos_intestinales/modelo de el sistema en mesa/imprimir/parte1TapaEngranes.STL

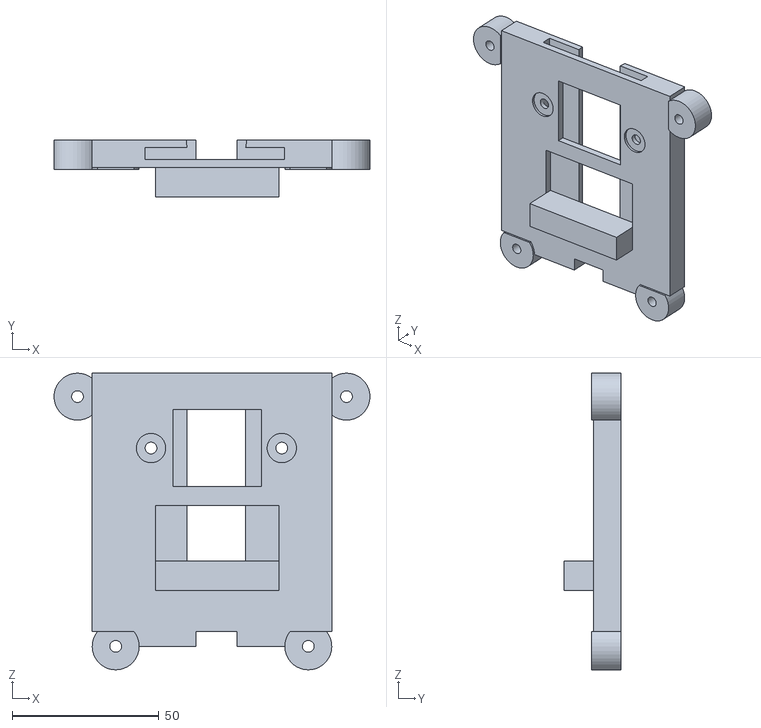
[picture p96: CAD file, 2026-05-12]
modelo de el sistema en mesa/imprimir/parte1TapaEngranes.STL
107.6 x 19.2 x 101.0
