albale15/simulador_de_Extraccion_de_polipos_intestinales/modelo de el sistema en mesa/imprimir/EngraneRuedaR1.STL

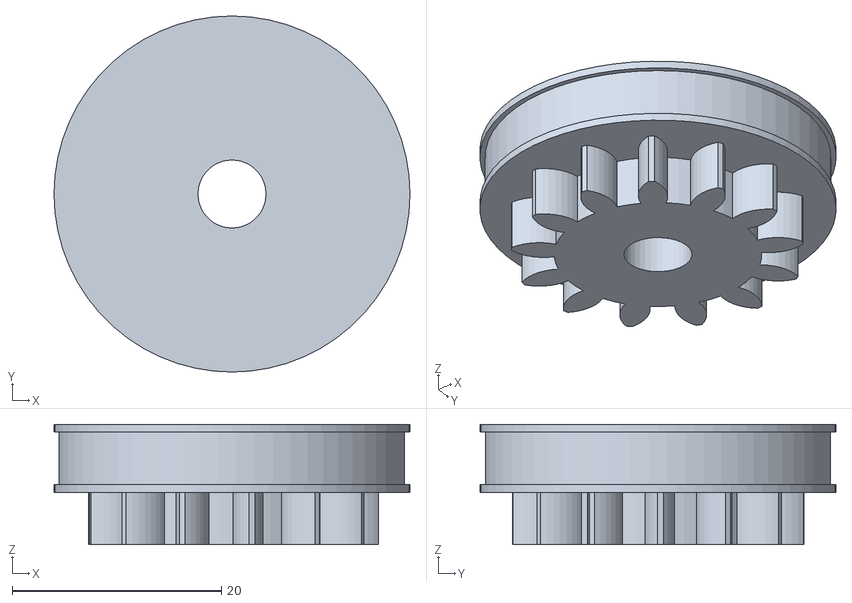
[picture p97: CAD file, 2026-05-12]
modelo de el sistema en mesa/imprimir/EngraneRuedaR1.STL
34.0 x 34.0 x 11.5
