albale15/simulador_de_Extraccion_de_polipos_intestinales/modelo de el sistema en mesa/solidos separados/EngraneEncoderR2.SLDPRT

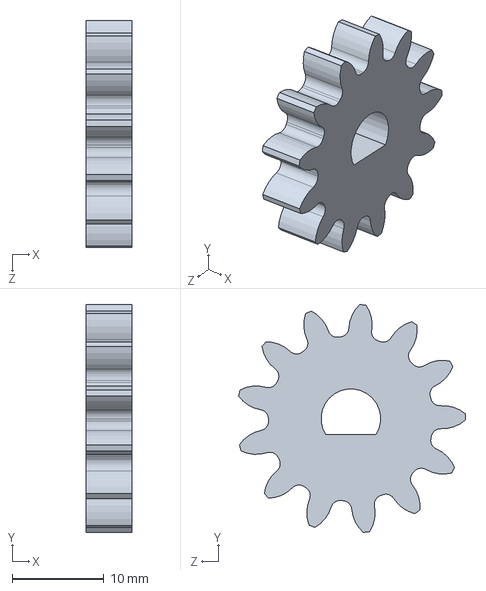
[picture p98: CAD file, 2026-05-16]
modelo de el sistema en mesa/solidos separados/EngraneEncoderR2.SLDPRT
5.00 x 24.9 x 24.8 mm
