albale15/simulador_de_Extraccion_de_polipos_intestinales/modelo endoscopio centro de mando/volante1.SLDPRT

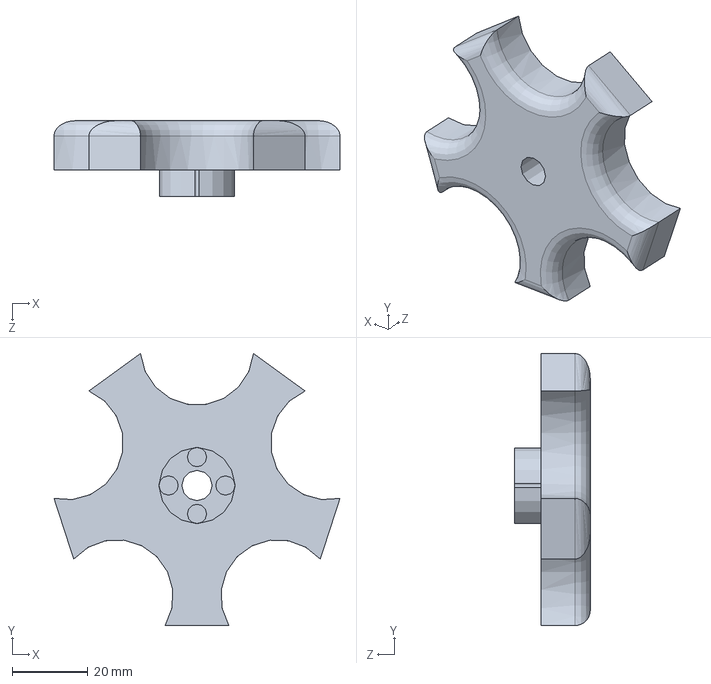
[picture p99: CAD file, 2026-05-24]
modelo endoscopio centro de mando/volante1.SLDPRT
75.6 x 71.9 x 20.0 mm
