albale15/simulador_de_Extraccion_de_polipos_intestinales/modelo de el sistema en mesa/solidos separados/TapaEngranes.SLDPRT

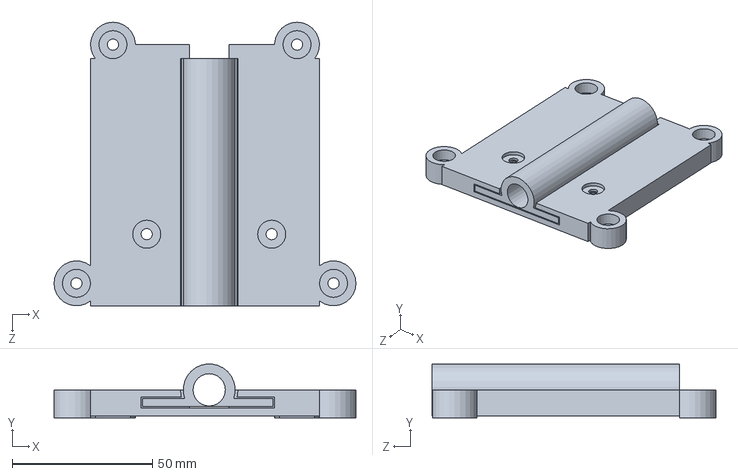
[picture p100: CAD file, 2026-05-16]
modelo de el sistema en mesa/solidos separados/TapaEngranes.SLDPRT
107.6 x 19.2 x 101.0 mm
