albale15/simulador_de_Extraccion_de_polipos_intestinales/modelo de el sistema en mesa/solidos separados/parte1TapaEngranes.SLDPRT

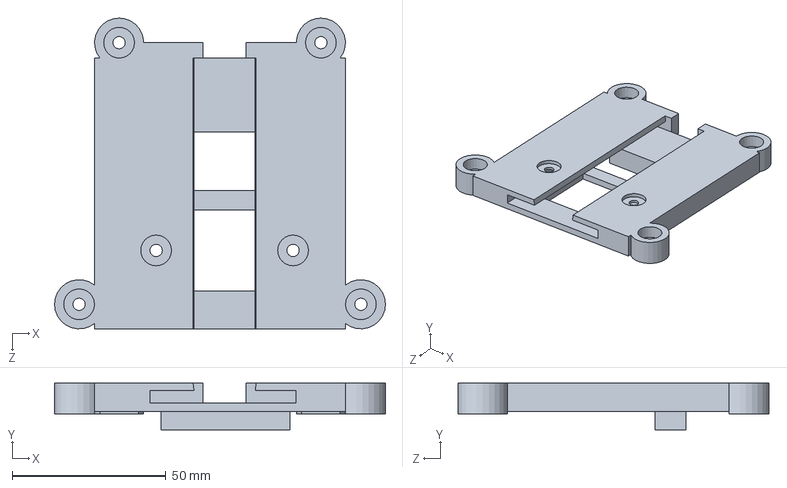
[picture p101: CAD file, 2026-05-12]
modelo de el sistema en mesa/solidos separados/parte1TapaEngranes.SLDPRT
107.6 x 15.3 x 101.0 mm
