albale15/simulador_de_Extraccion_de_polipos_intestinales/modelo de el sistema en mesa/solidos separados/BaseRasp.SLDPRT

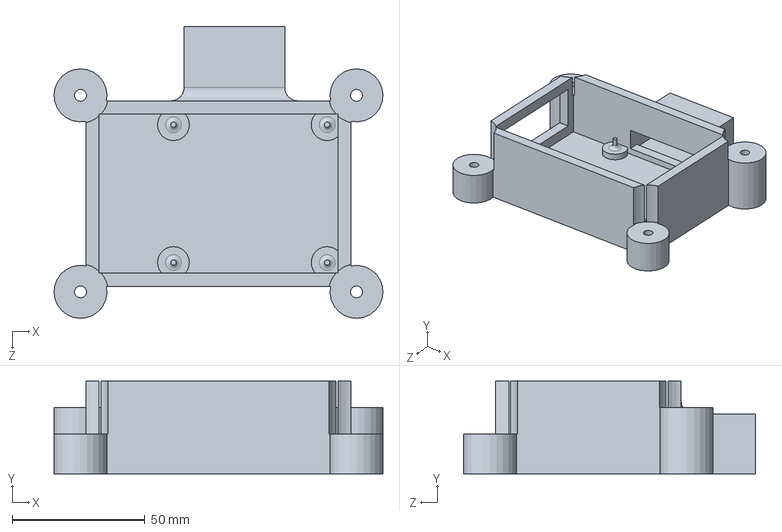
[picture p102: CAD file, 2026-04-20]
modelo de el sistema en mesa/solidos separados/BaseRasp.SLDPRT
124.1 x 35.0 x 110.1 mm
