albale15/simulador_de_Extraccion_de_polipos_intestinales/(list of files, cad)

Other CAD files:
modelo de el sistema en mesa/solidos separados/tapaCable.SLDPRT
modelo endoscopio centro de mando/imprimir/agarres.STL
modelo de el sistema en mesa/solidos separados/ParedSoporteEngranes.SLDPRT
modelo endoscopio centro de mando/engrane1.SLDPRT
modelo de el sistema en mesa/imprimir/parte2TapaEngranes.STL
modelo de el sistema en mesa/solidos separados/BaseEncodersEngranes.SLDPRT
modelo endoscopio centro de mando/imprimir/base carcasa.STL
modelo endoscopio centro de mando/volante2.SLDPRT
modelo de el sistema en mesa/solidos separados/parteMediaCajaEngranes.SLDPRT
modelo endoscopio centro de mando/tapa.SLDPRT
modelo de el sistema en mesa/imprimir/TapaEngranes.STL
modelo endoscopio centro de mando/agarres2.SLDPRT
modelo de el sistema en mesa/imprimir/EngraneEncoderR2.STL
modelo de el sistema en mesa/solidos separados/EngraneEncoderR1.SLDPRT
modelo de el sistema en mesa/imprimir/parteMediaCajaEngranes.STL
modelo de el sistema en mesa/solidos separados/EngraneRuedaR1.SLDPRT
modelo de el sistema en mesa/imprimir/EngraneEncoderR1.STL
Planos/centro de mando/CentroDeMando.SLDDRW
Planos/centro de mando/version antigua/agarres.SLDDRW
Planos/centro de mando/version antigua/base carcasa.SLDDRW
Planos/centro de mando/version antigua/caja de encoders.SLDDRW
Planos/centro de mando/version antigua/engrane1.SLDDRW
Planos/centro de mando/version antigua/engrane2.SLDDRW
Planos/centro de mando/version antigua/plantilla.SLDDRW
Planos/centro de mando/version antigua/tapa.SLDDRW
Planos/centro de mando/version antigua/volante1.SLDDRW
Planos/centro de mando/version antigua/volante2.SLDDRW
Planos/mecanismo de insercion/BaseEncodersEngranes.SLDDRW
Planos/mecanismo de insercion/ParedSoporteEngranes.SLDDRW
Planos/mecanismo de insercion/mecanismo de insercion.SLDDRW
Planos/mecanismo de insercion/parte1TapaEngranes.SLDDRW
Planos/mecanismo de insercion/parte2TapaEngranes.SLDDRW
Planos/mecanismo de insercion/parteMediaCajaEngranes.SLDDRW
Planos/mecanismo de insercion/planos antiguos/BaseEncodersEngranes.SLDDRW
Planos/mecanismo de insercion/planos antiguos/EngraneEncoderR2.SLDDRW
Planos/mecanismo de insercion/planos antiguos/ParedSoporteEngranes.SLDDRW
Planos/mecanismo de insercion/planos antiguos/parte1TapaEngranes.SLDDRW
Planos/mecanismo de insercion/planos antiguos/parte2TapaEngranes.SLDDRW
Planos/mecanismo de insercion/planos antiguos/parteMediaCajaEngranes.SLDDRW
aplicacion/modelados3d/intestino.blend
aplicacion/modelados3d/intestino2.blend
aplicacion/modelados3d/intestinoMASgRANDE.blend
aplicacion/modelados3d/intestinoMASgRANDE2.blend
aplicacion/modelados3d/pinzaAsas.blend
aplicacion/modelados3d/pinzaDientes.blend
aplicacion/modelados3d/poliposYamada.blend
aplicacion/modelados3d/puntaEndoscopio.blend
aplicacion/modelados3d/puntaEndoscopioConHuesos.blend
