albale15/simulador_de_Extraccion_de_polipos_intestinales/INFORME/apendices imagenes/EnsamblajemodeloEndoscopi.PNG

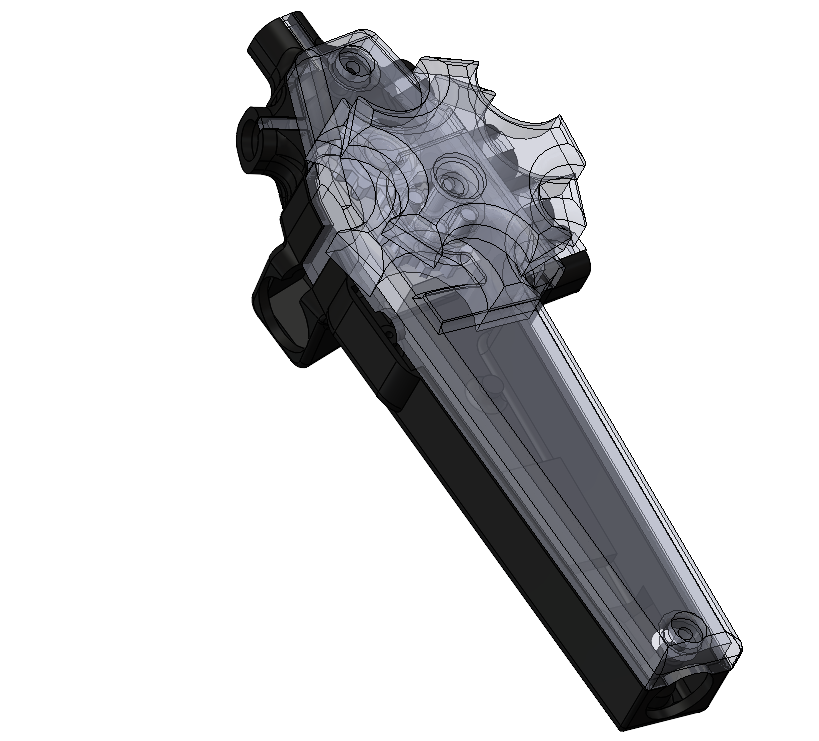
INFORME/apendices imagenes/EnsamblajemodeloEndoscopi.PNG
