albale15/simulador_de_Extraccion_de_polipos_intestinales/INFORME/apendices imagenes/CentroDeMando.pdf

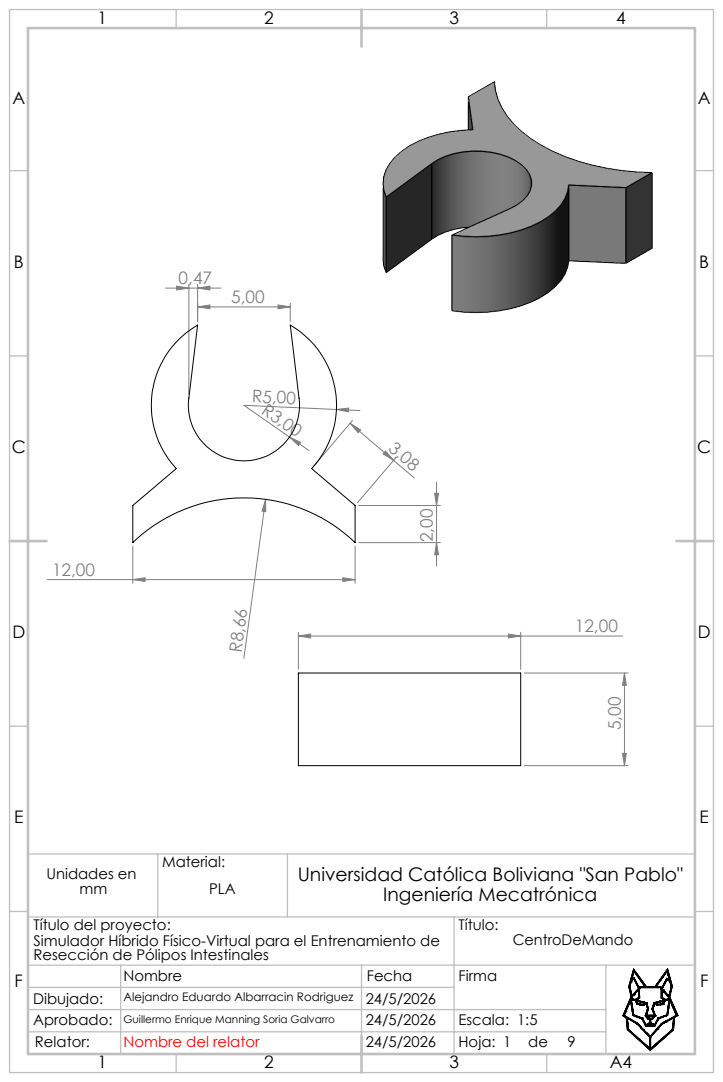
[picture p104: page 1]

Unidades en mm | Material: PLA | Universidad Católica Boliviana "San Pablo" Ingeniería Mecatrónica

Título del proyecto: Simulador Híbrido Físico-Virtual para el Entrenamiento de Resección de Pólipos Intestinales | Título: CentroDeMando

Nombre | Fecha | Firma

Dibujado: | Alejandro Eduardo Albarracin Rodriguez | 24/5/2026
Aprobado: | Guillermo Enrique Manning Soria Galvarro | | Escala:
Relator: | Nombre del relator | | Hoja:

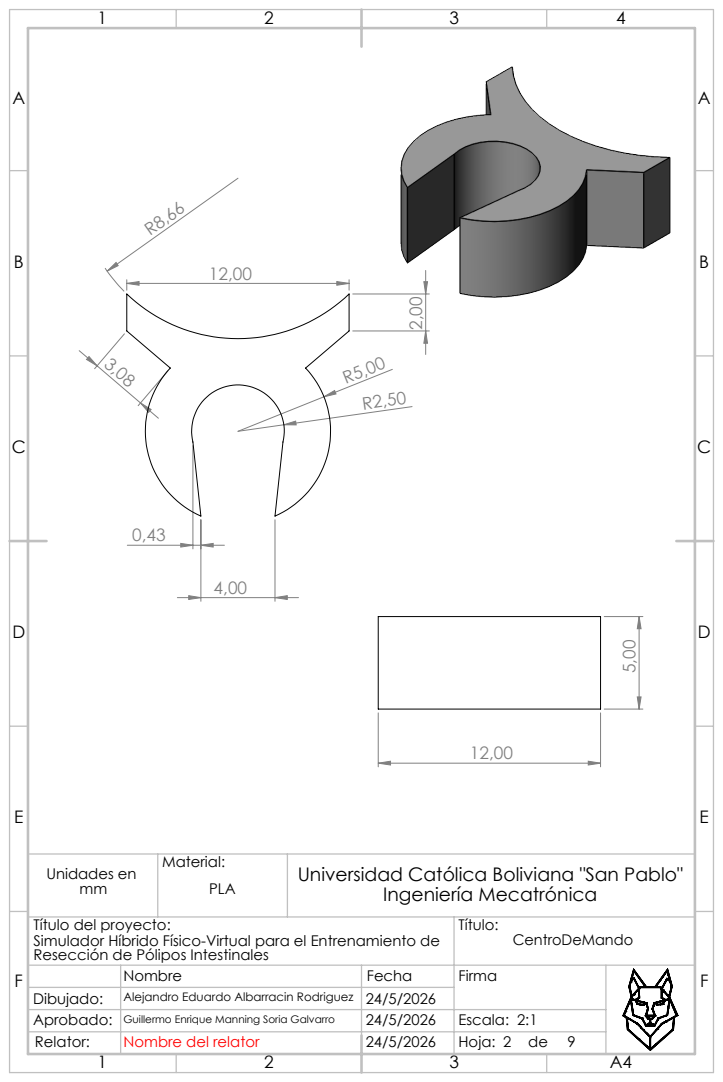
[picture p105: page 2]

Unidades en mm | Material: PLA | Universidad Católica Boliviana "San Pablo" Ingeniería Mecatrónica

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

Nombre | Fecha | Firma

Dibujado: | Alejandro Eduardo Albarracin Rodriguez | 24/5/2026

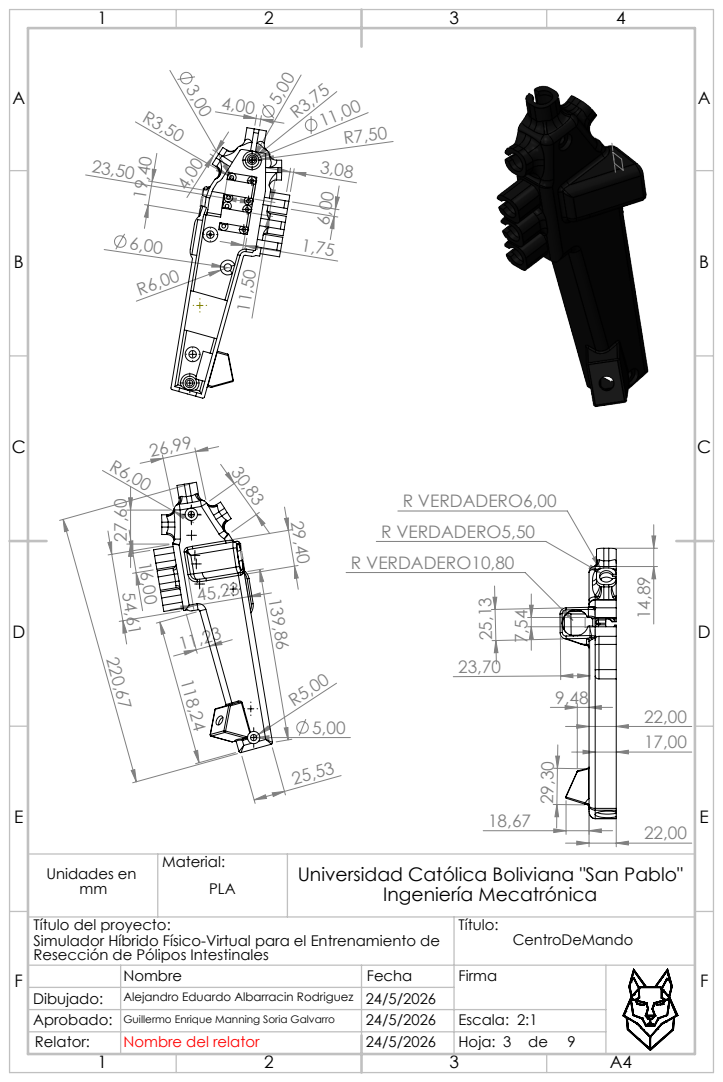
[picture p106: page 3]
R VERDADERO10,80 25,13; R VERDADERO5,50; R VERDADERO6,00

Unidades en mm | Material: PLA | Universidad Católica Boliviana "San Pablo" Ingeniería Mecatrónica

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

Nombre | Fecha | Firma

Dibujado: | Alejandro Eduardo Albarracin Rodriguez | 24/5/2026

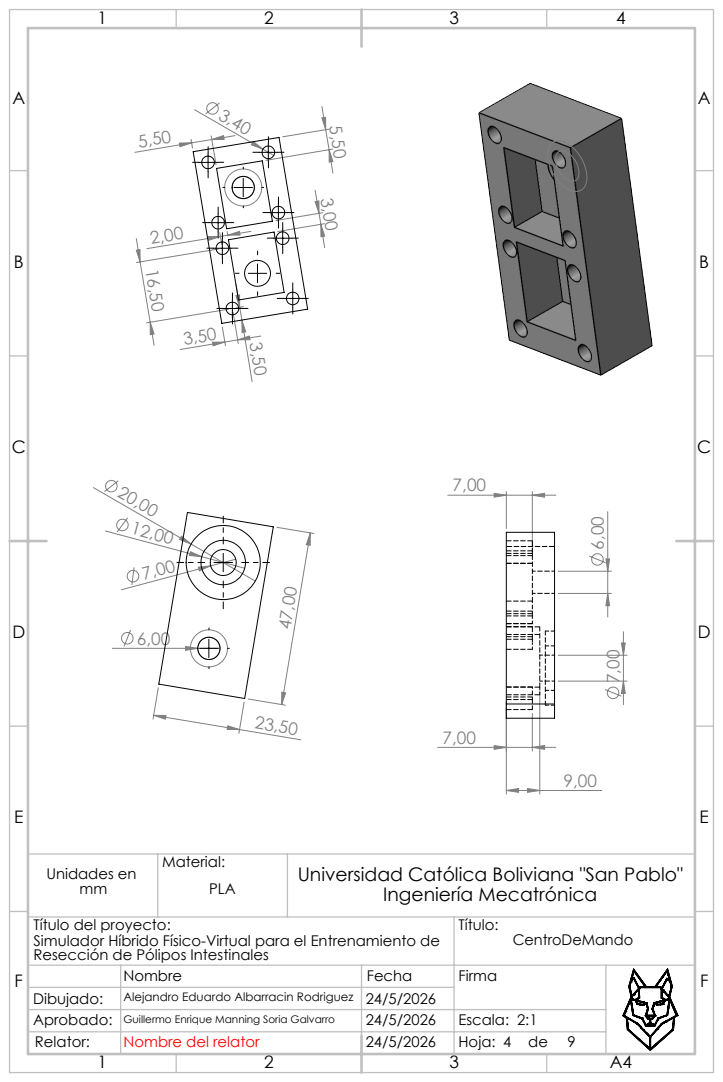
[picture p107: page 4]

Unidades en mm | Material: PLA | Universidad Católica Boliviana "San Pablo" Ingeniería Mecatrónica

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

Nombre | Fecha | Firma

Dibujado: | Alejandro Eduardo Albarracin Rodriguez | 24/5/2026

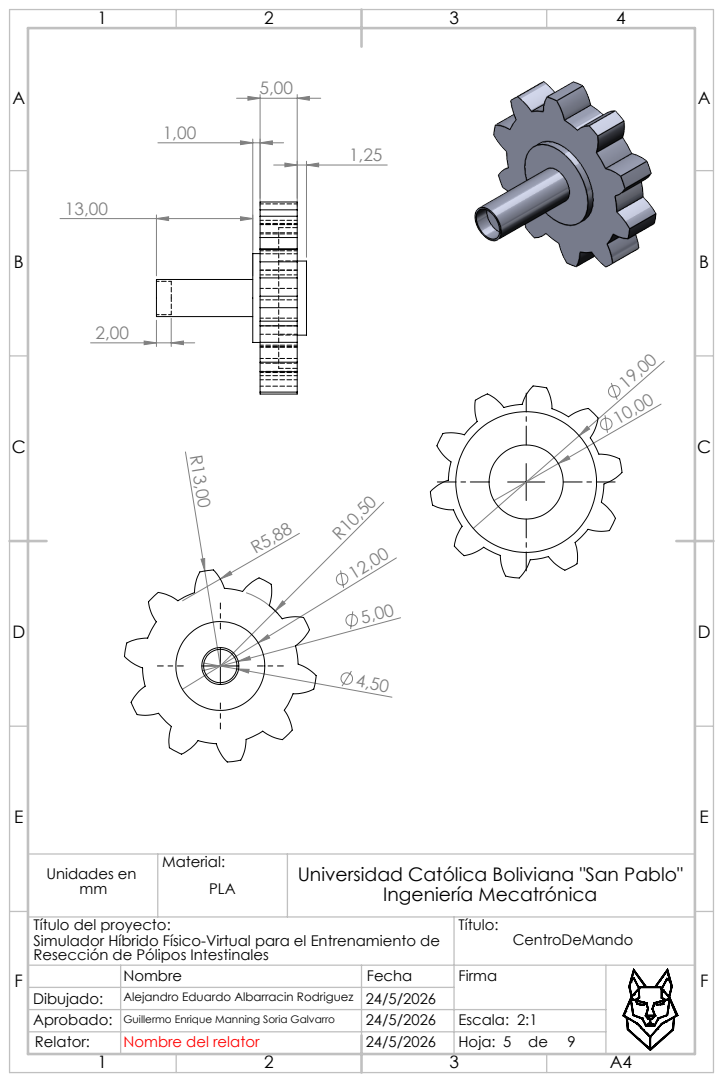
[picture p108: page 5]

Unidades en mm | Material: PLA | Universidad Católica Boliviana "San Pablo" Ingeniería Mecatrónica

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

Nombre | Fecha | Firma

Dibujado: | Alejandro Eduardo Albarracin Rodriguez | 24/5/2026

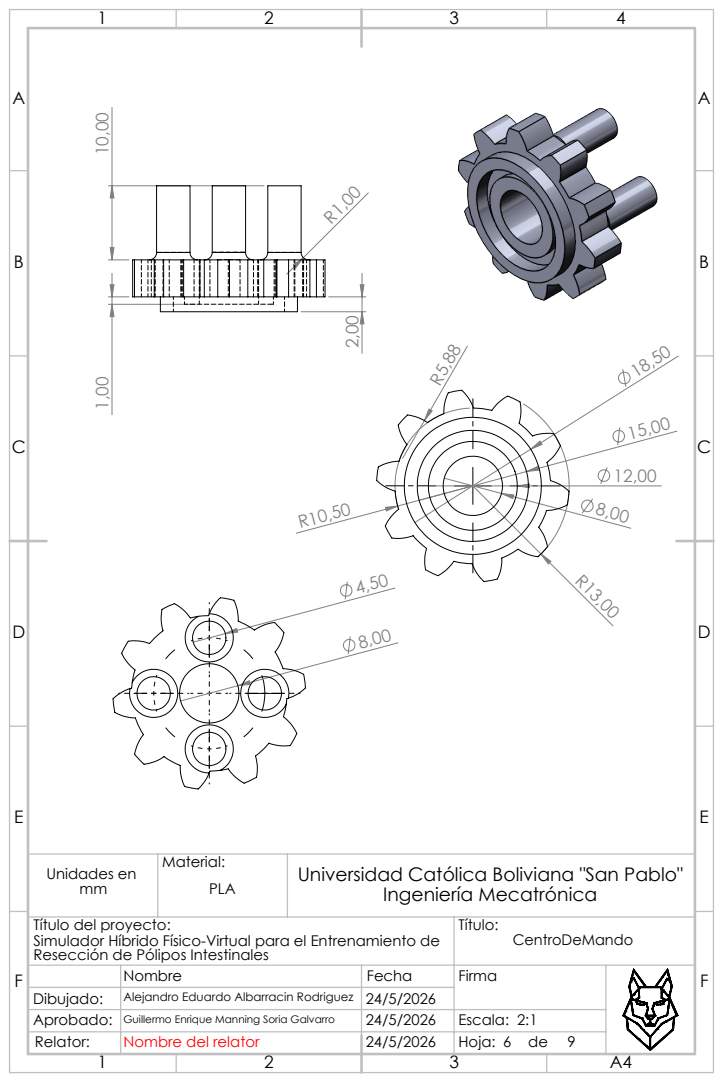
[picture p109: page 6]

Unidades en mm | Material: PLA | Universidad Católica Boliviana "San Pablo" Ingeniería Mecatrónica

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

Nombre | Fecha | Firma

Dibujado: | Alejandro Eduardo Albarracin Rodriguez | 24/5/2026

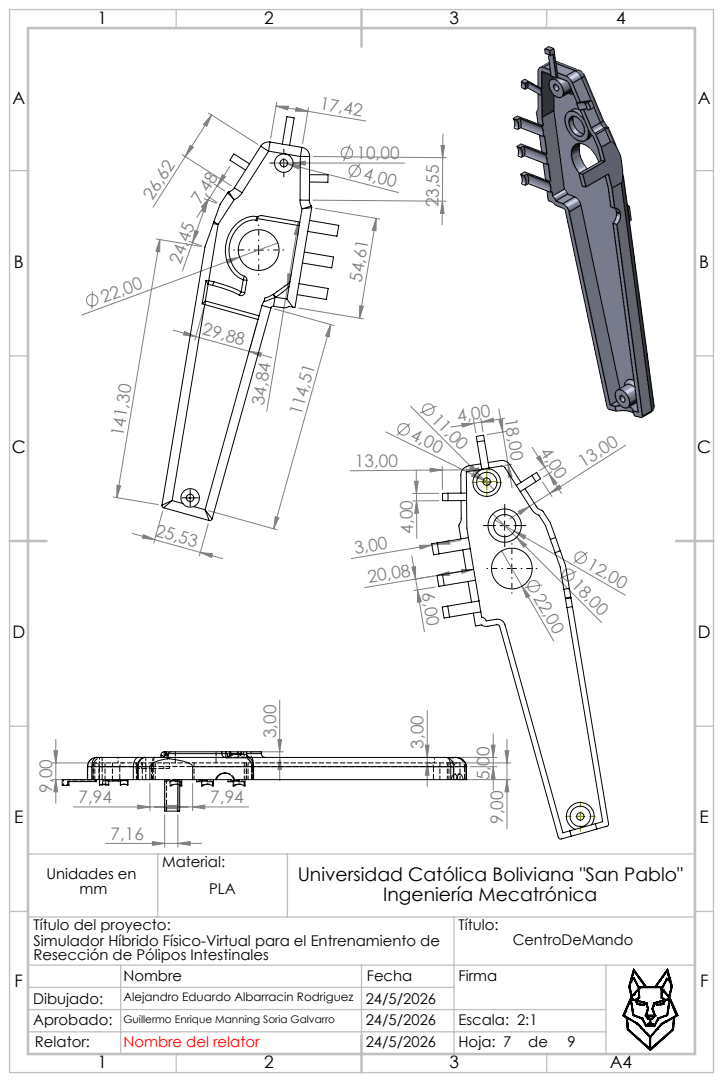
[picture p110: page 7]

Unidades en mm | Material: PLA | Universidad Católica Boliviana "San Pablo" Ingeniería Mecatrónica

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

Nombre | Fecha | Firma

Dibujado: | Alejandro Eduardo Albarracin Rodriguez | 24/5/2026

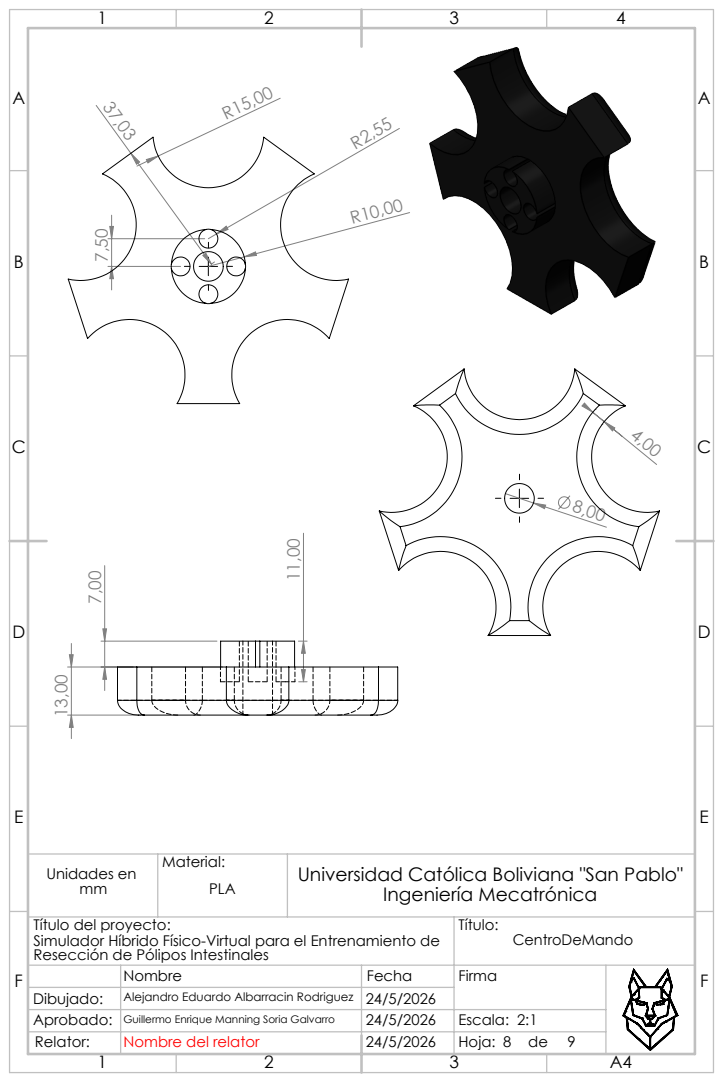
[picture p111: page 8]

Unidades en mm | Material: PLA | Universidad Católica Boliviana "San Pablo" Ingeniería Mecatrónica

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

Nombre | Fecha | Firma

Dibujado: | Alejandro Eduardo Albarracin Rodriguez | 24/5/2026

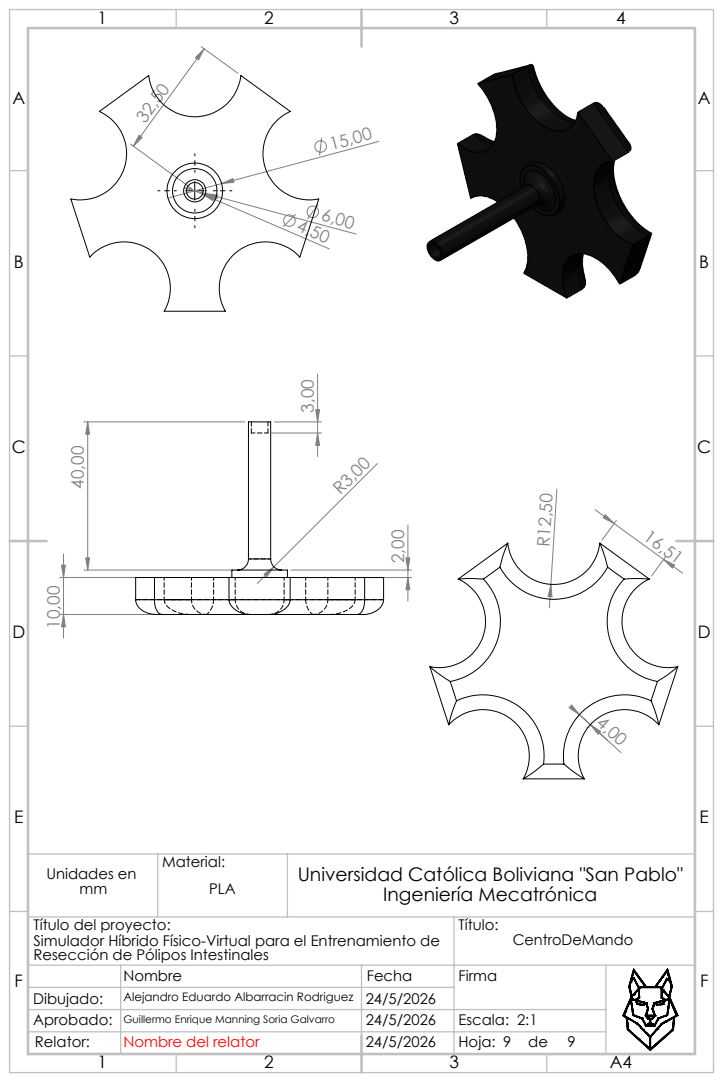
[picture p112: page 9]

Unidades en mm | Material: PLA | Universidad Católica Boliviana "San Pablo" Ingeniería Mecatrónica

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

Nombre | Fecha | Firma

Dibujado: | Alejandro Eduardo Albarracin Rodriguez | 24/5/2026
