albale15/simulador_de_Extraccion_de_polipos_intestinales/INFORME/apendices imagenes/mecanismo de insercion.pdf

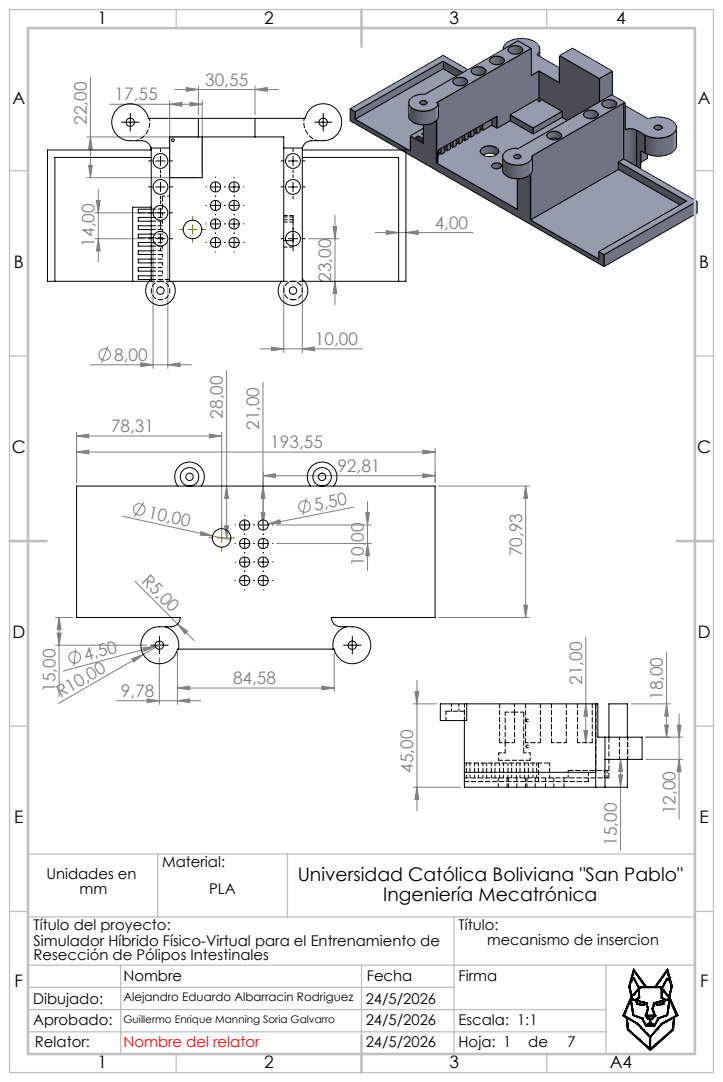
[picture p113: page 1]

Unidades en mm | Material: PLA | Universidad Católica Boliviana "San Pablo" Ingeniería Mecatrónica

Título del proyecto: Simulador Híbrido Físico-Virtual para el Entrenamiento de Resección de Pólipos Intestinales | Título: mecanismo de insercion

Nombre | Fecha | Firma

Dibujado: | Alejandro Eduardo Albarracin Rodriguez | 24/5/2026
Aprobado: | Guillermo Enrique Manning Soria Galvarro | | Escala:
Relator: | Nombre del relator | | Hoja:

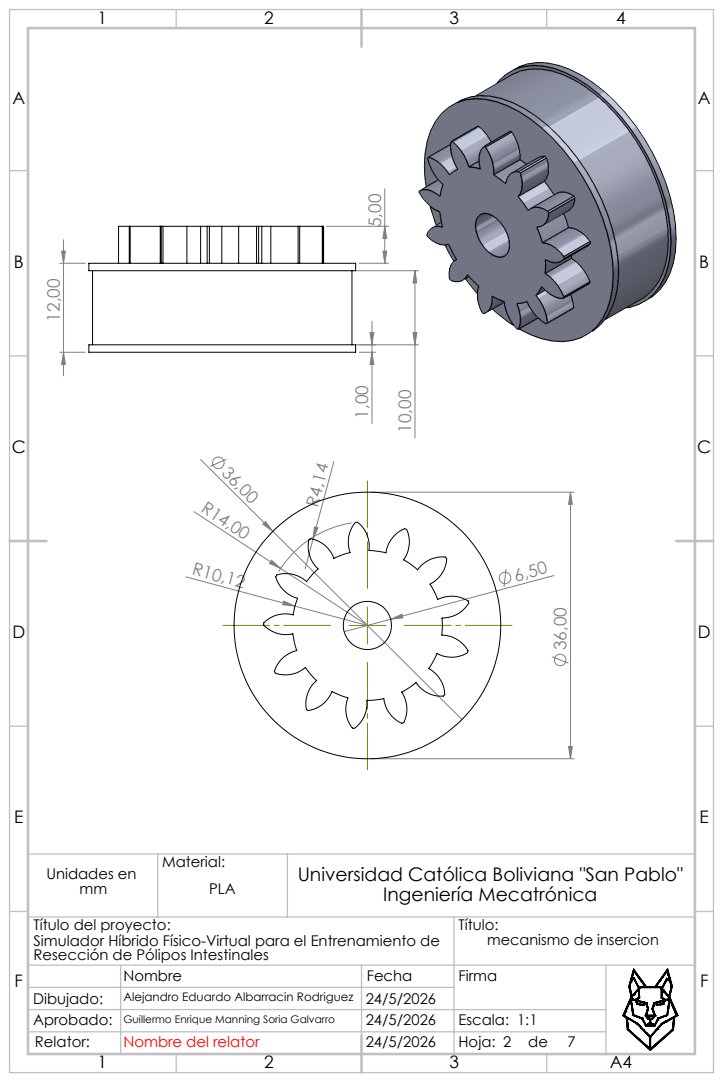
[picture p114: page 2]

Unidades en mm | Material: PLA | Universidad Católica Boliviana "San Pablo" Ingeniería Mecatrónica

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

Nombre | Fecha | Firma

Dibujado: | Alejandro Eduardo Albarracin Rodriguez | 24/5/2026

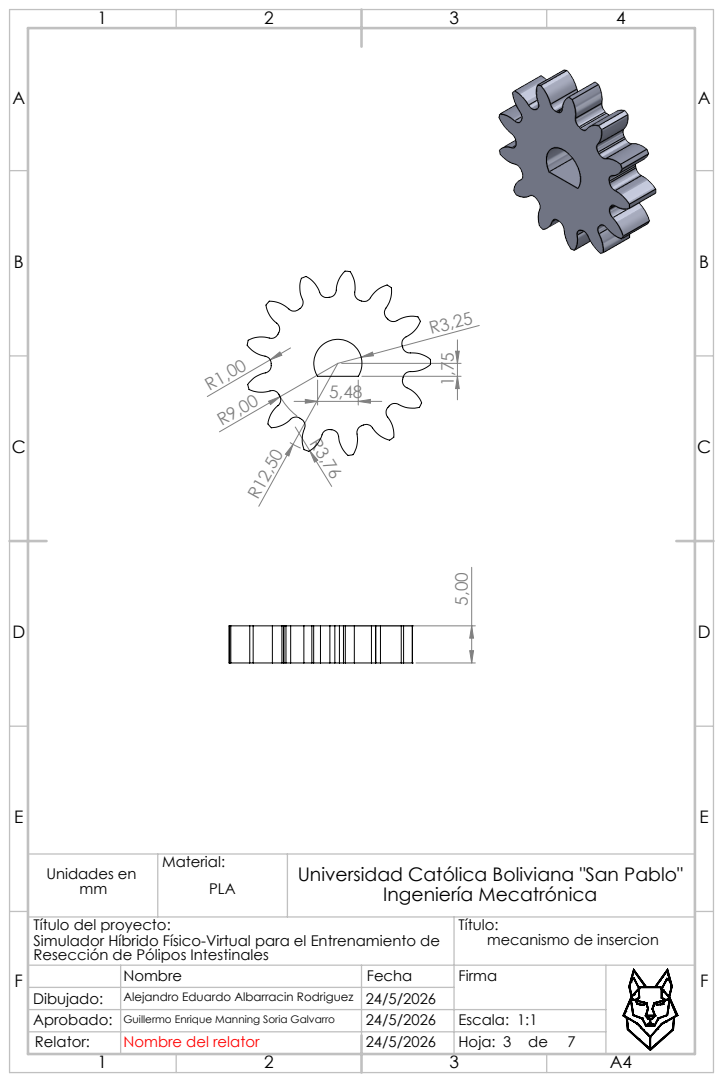
[picture p115: page 3]

Unidades en mm | Material: PLA | Universidad Católica Boliviana "San Pablo" Ingeniería Mecatrónica

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

Nombre | Fecha | Firma

Dibujado: | Alejandro Eduardo Albarracin Rodriguez | 24/5/2026

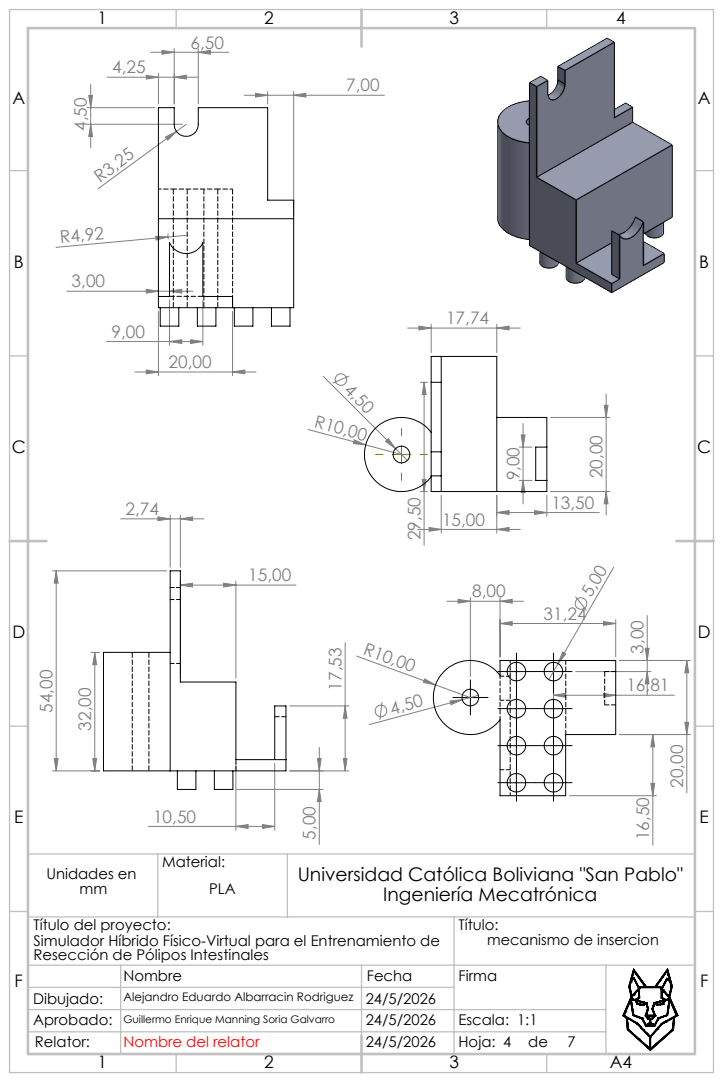
[picture p116: page 4]

Unidades en mm | Material: PLA | Universidad Católica Boliviana "San Pablo" Ingeniería Mecatrónica

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

Nombre | Fecha | Firma

Dibujado: | Alejandro Eduardo Albarracin Rodriguez | 24/5/2026

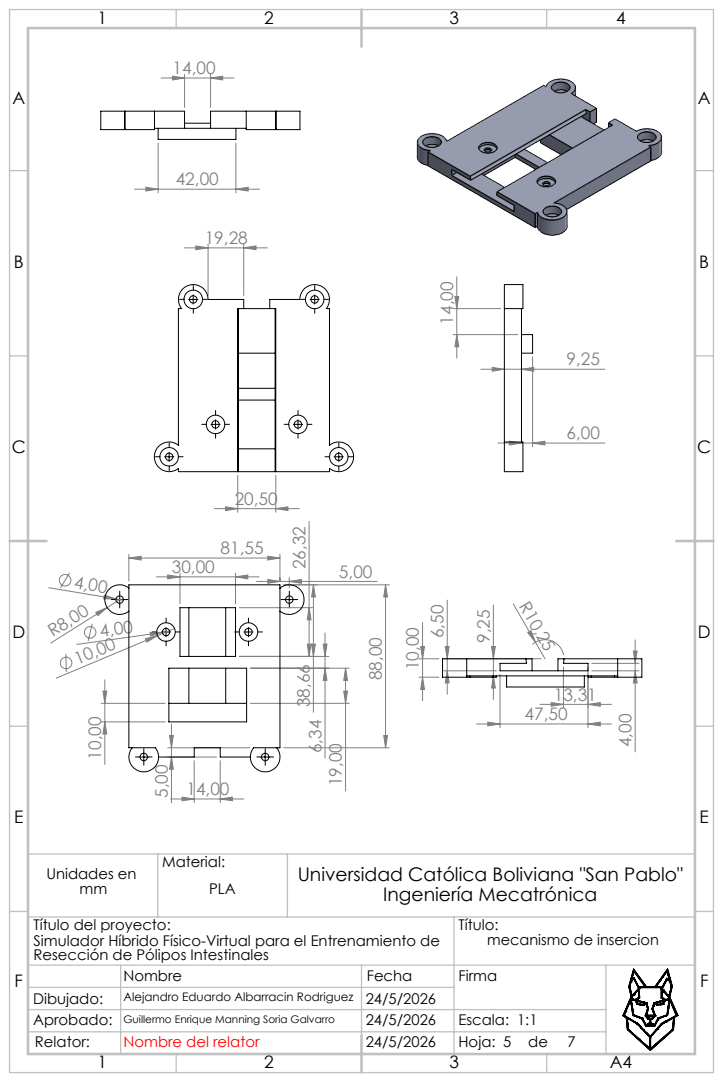
[picture p117: page 5]

Unidades en mm | Material: PLA | Universidad Católica Boliviana "San Pablo" Ingeniería Mecatrónica

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

Nombre | Fecha | Firma

Dibujado: | Alejandro Eduardo Albarracin Rodriguez | 24/5/2026

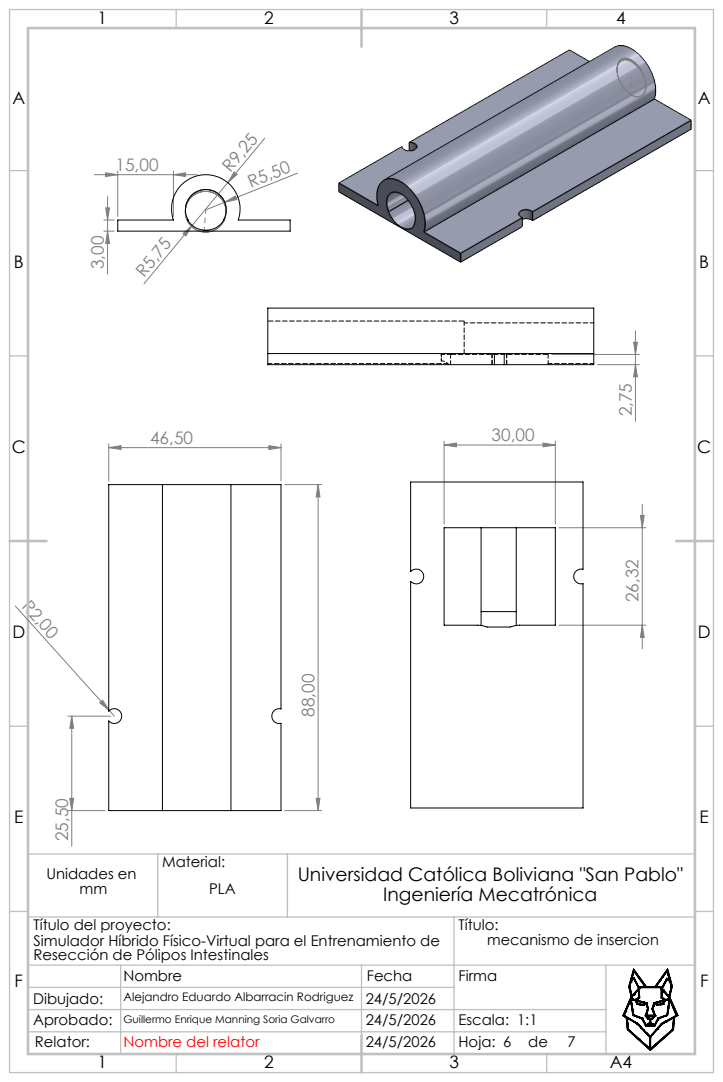
[picture p118: page 6]

Unidades en mm | Material: PLA | Universidad Católica Boliviana "San Pablo" Ingeniería Mecatrónica

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

Nombre | Fecha | Firma

Dibujado: | Alejandro Eduardo Albarracin Rodriguez | 24/5/2026

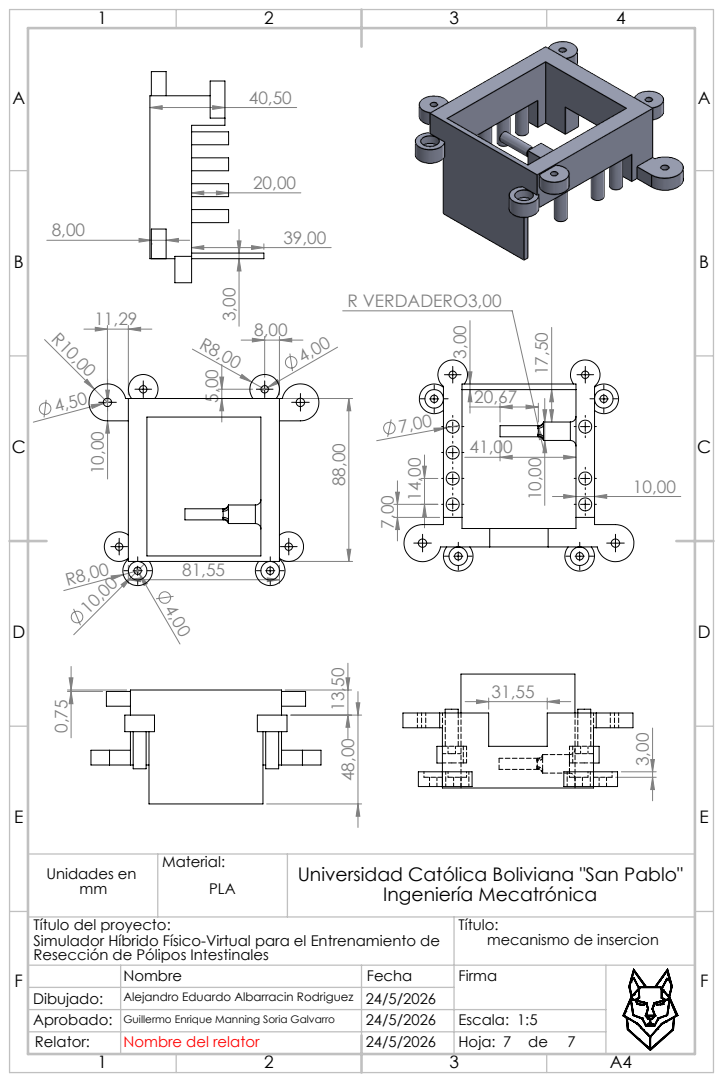
[picture p119: page 7]
R VERDADERO3,00

Unidades en mm | Material: PLA | Universidad Católica Boliviana "San Pablo" Ingeniería Mecatrónica

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

Nombre | Fecha | Firma

Dibujado: | Alejandro Eduardo Albarracin Rodriguez | 24/5/2026
