albale15/simulador_de_Extraccion_de_polipos_intestinales/Planos/centro de mando/pdfs/caja de encoders.pdf

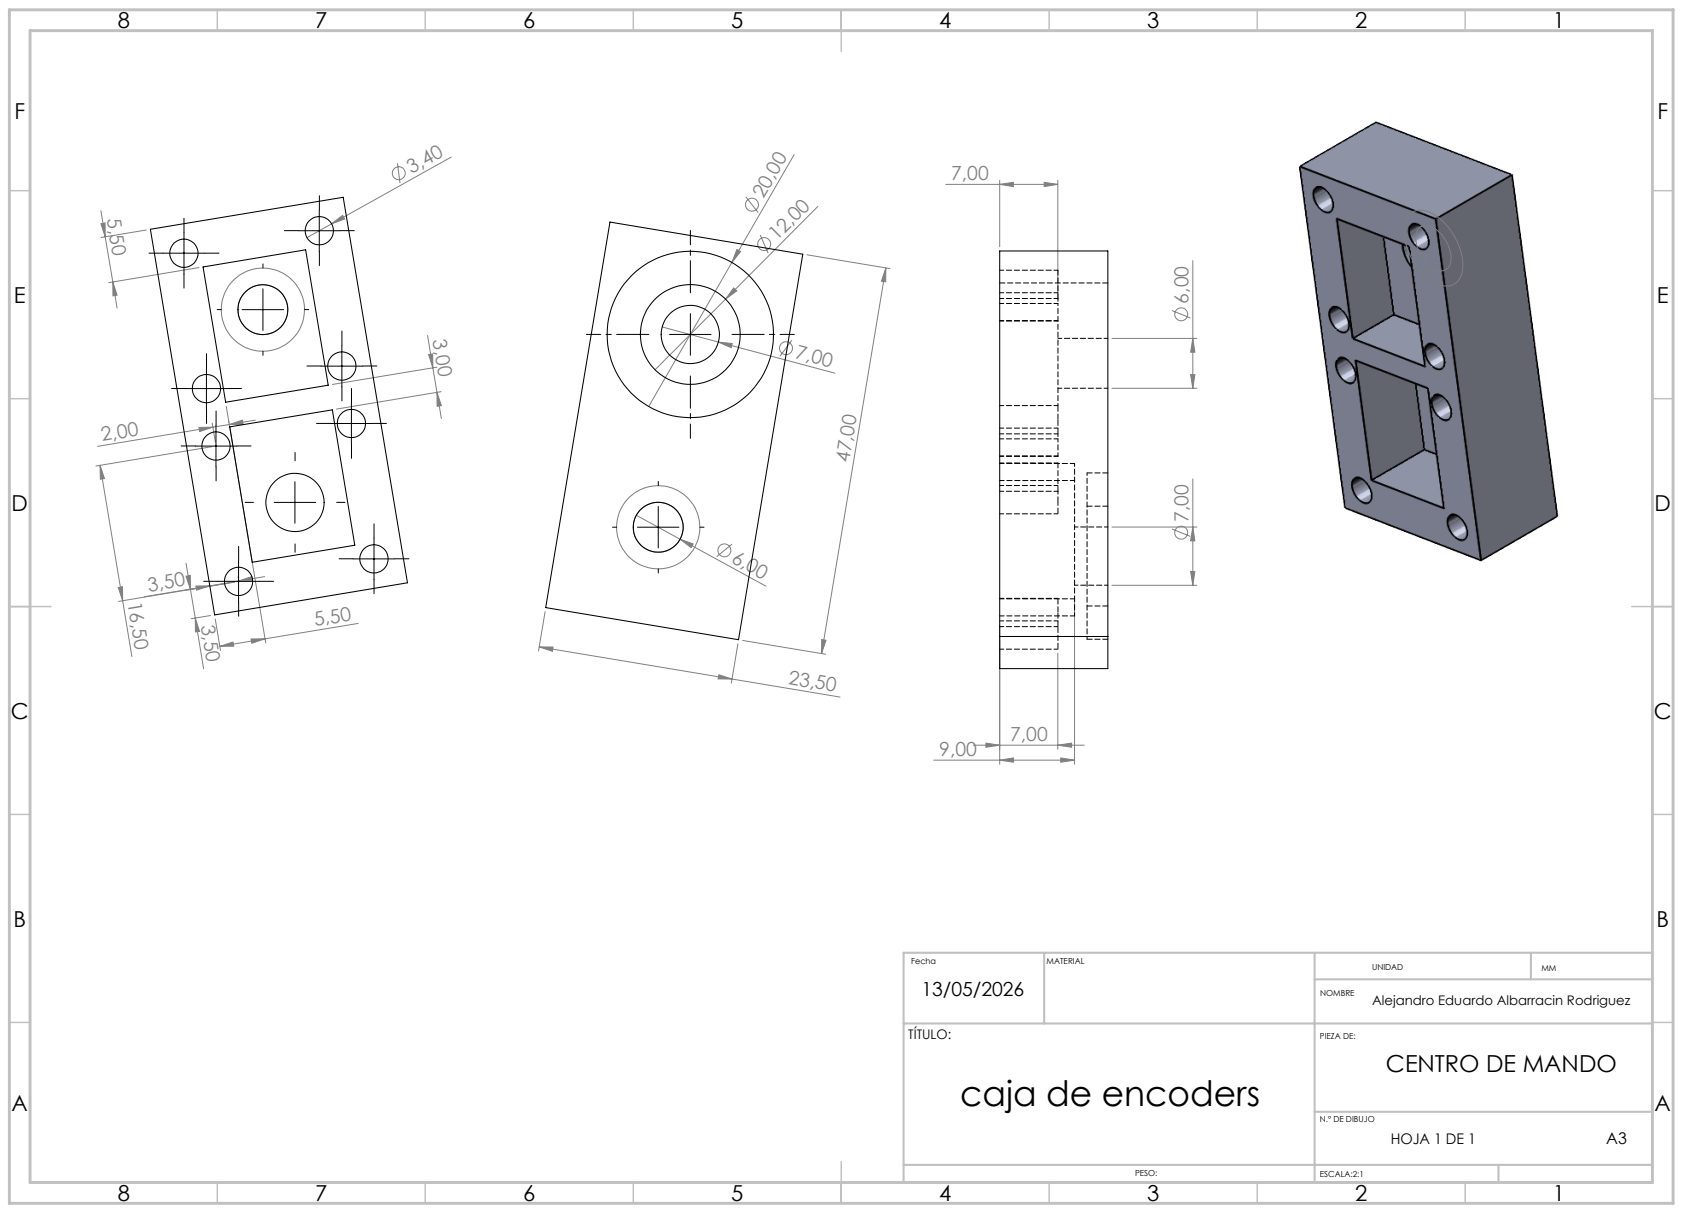
[picture p120: page 1]
N.º DE DIBUJO; HOJA 1 DE 1; Alejandro Eduardo Albarracin Rodriguez

TÍTULO: caja de encoders | PIEZA DE: CENTRO DE MANDO
