albale15/simulador_de_Extraccion_de_polipos_intestinales/placa de circuito/circuito final para pcb.PDF

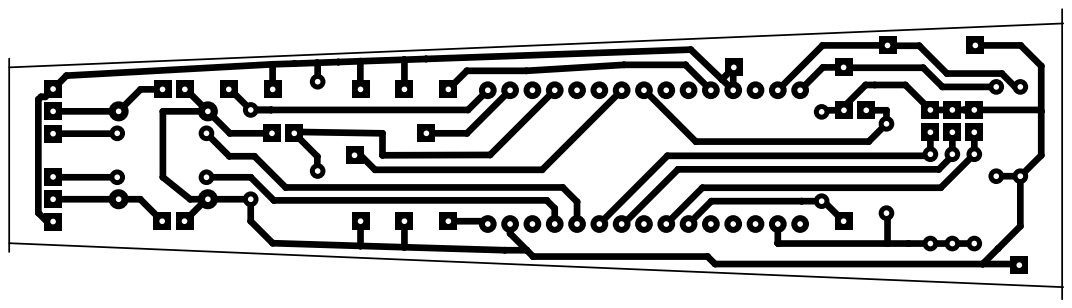
[picture p121: page 1]
