albale15/simulador_de_Extraccion_de_polipos_intestinales/Planos/centro de mando/pdfs/agarres.pdf

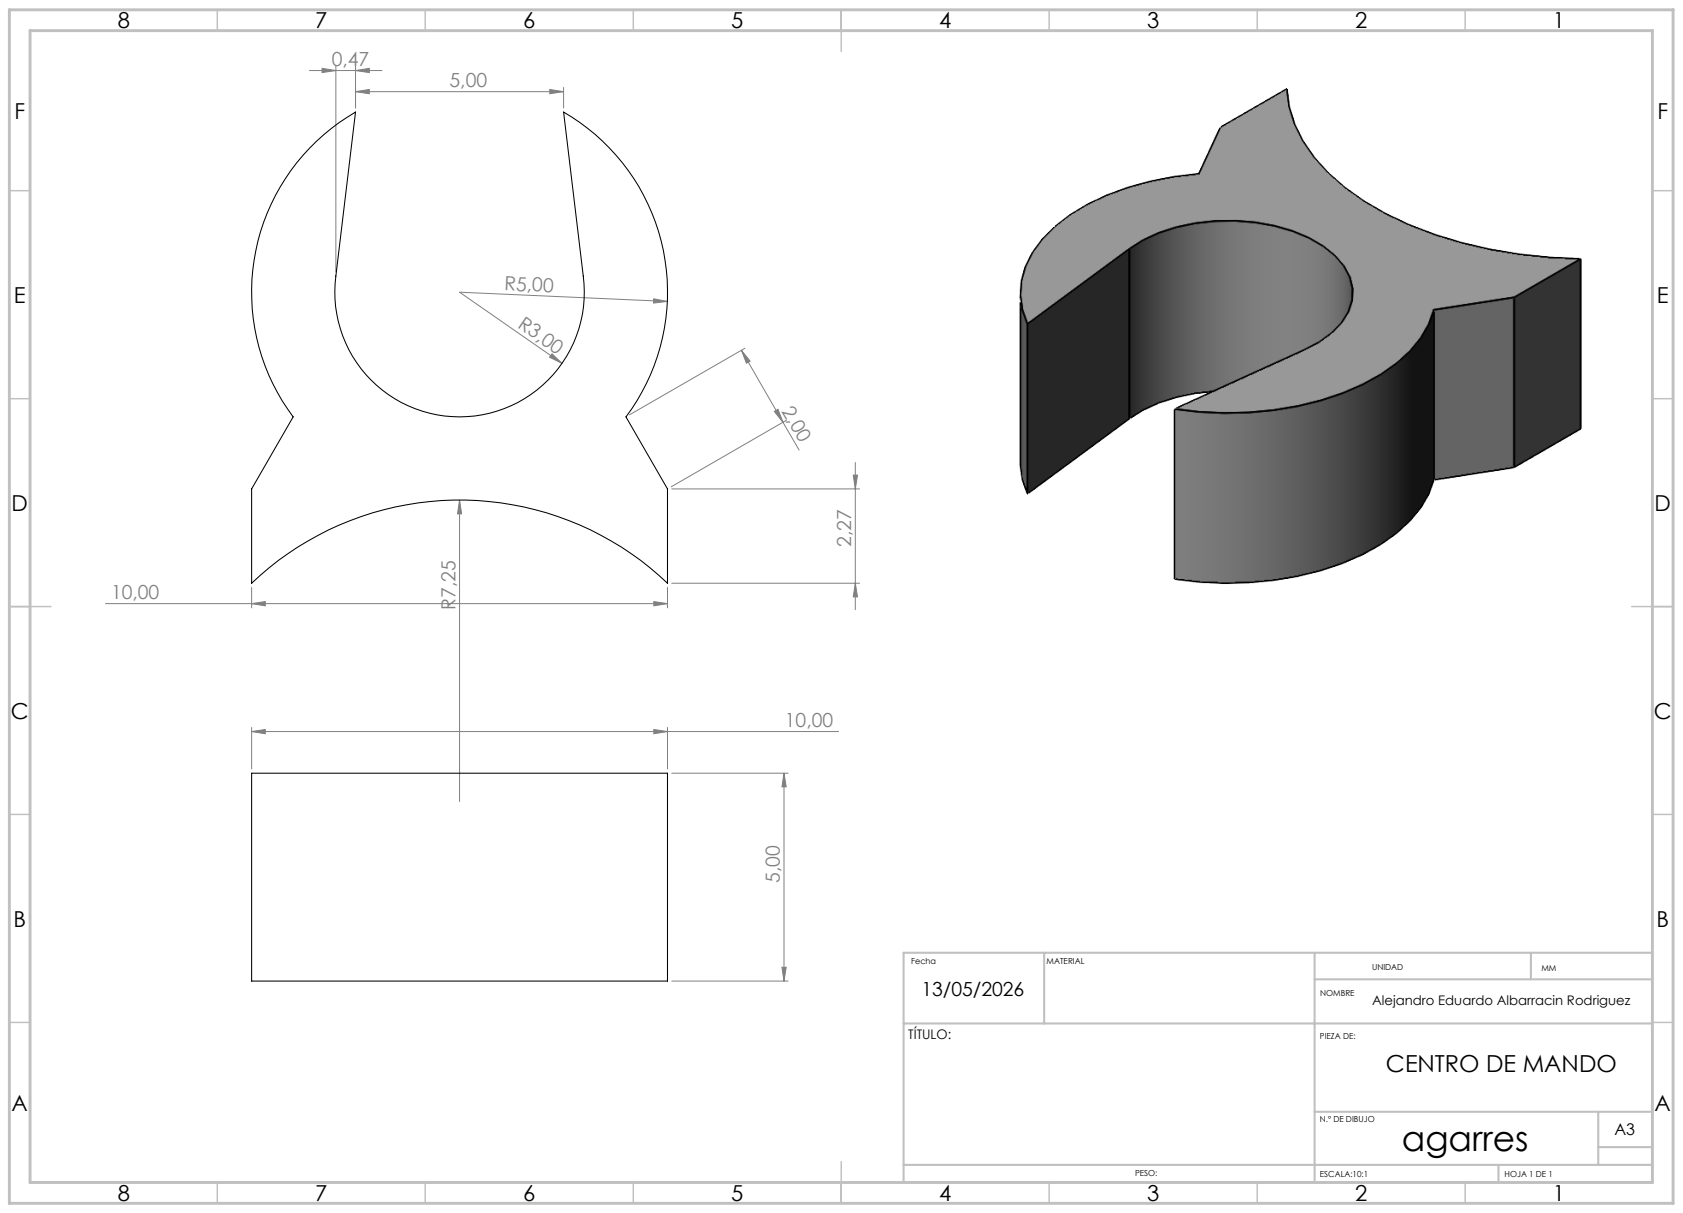
[picture p122: page 1]
ESCALA:10:1; HOJA 1 DE 1; Alejandro Eduardo Albarracin Rodriguez

TÍTULO: | PIEZA DE: CENTRO DE MANDO

N.º DE DIBUJO agarres | A3
