albale15/simulador_de_Extraccion_de_polipos_intestinales/Planos/centro de mando/pdfs/base carcasa.pdf

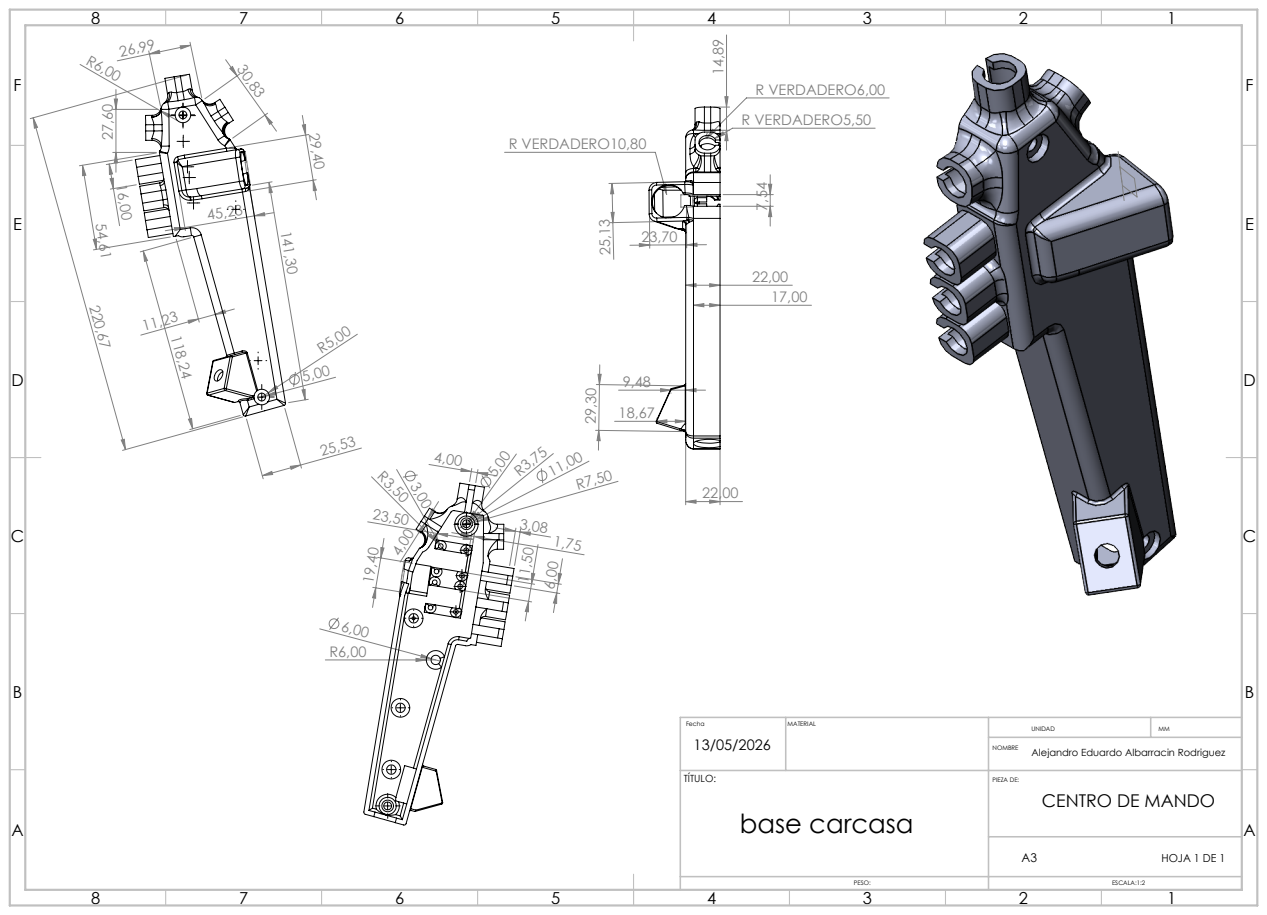
[picture p123: page 1]
R VERDADERO10,80 25,13; R VERDADERO5,50; R VERDADERO6,00; HOJA 1 DE 1; Alejandro Eduardo Albarracin Rodriguez

TÍTULO: base carcasa | PIEZA DE: CENTRO DE MANDO
