albale15/simulador_de_Extraccion_de_polipos_intestinales/Planos/centro de mando/pdfs/tapa.pdf

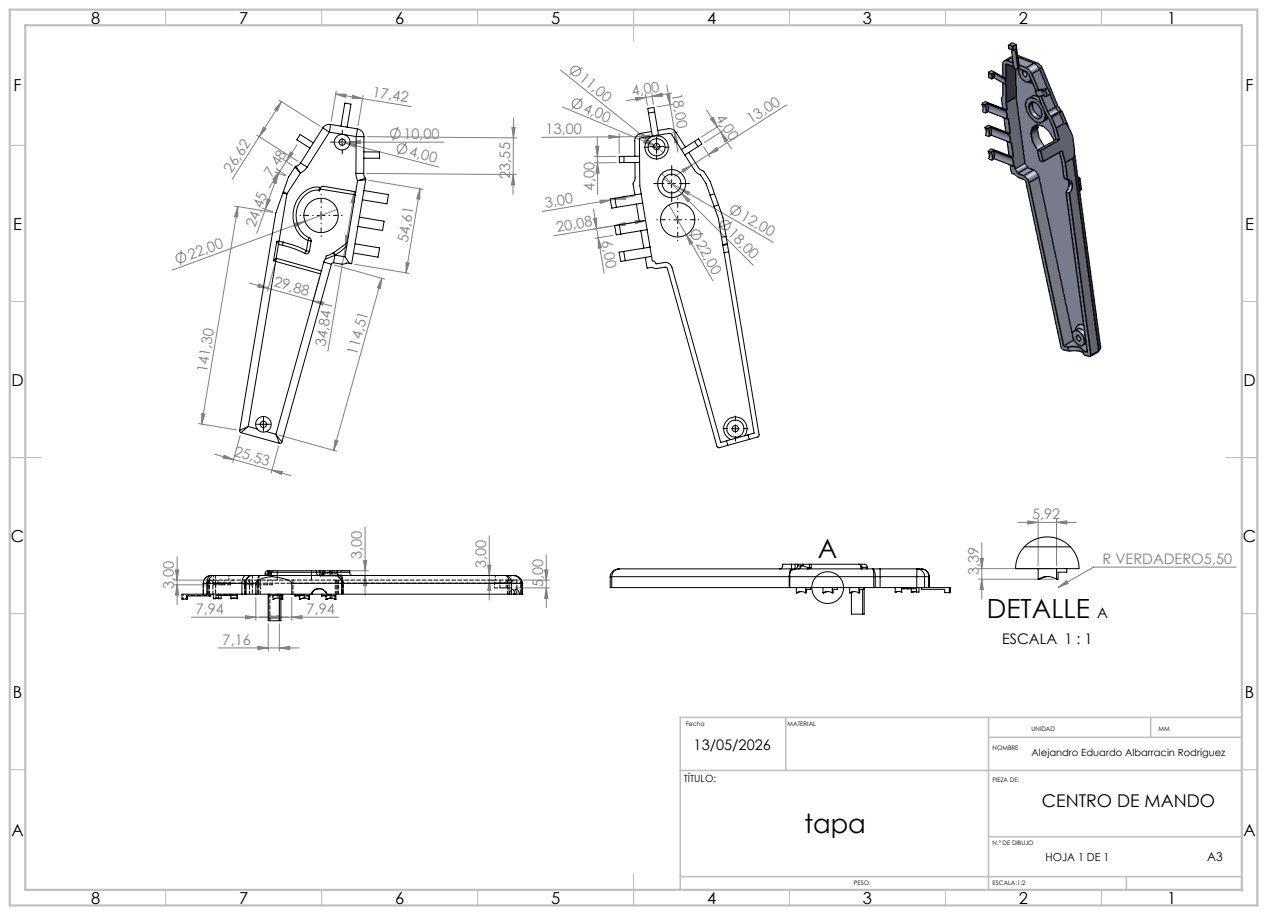
[picture p126: page 1]
R VERDADERO5,50 3,39; DETALLE A; ESCALA 1 : 1; N.º DE DIBUJO; HOJA 1 DE 1; Alejandro Eduardo Albarracin Rodriguez

TÍTULO: tapa | PIEZA DE: CENTRO DE MANDO
