albale15/simulador_de_Extraccion_de_polipos_intestinales/Planos/centro de mando/pdfs/volante1.pdf

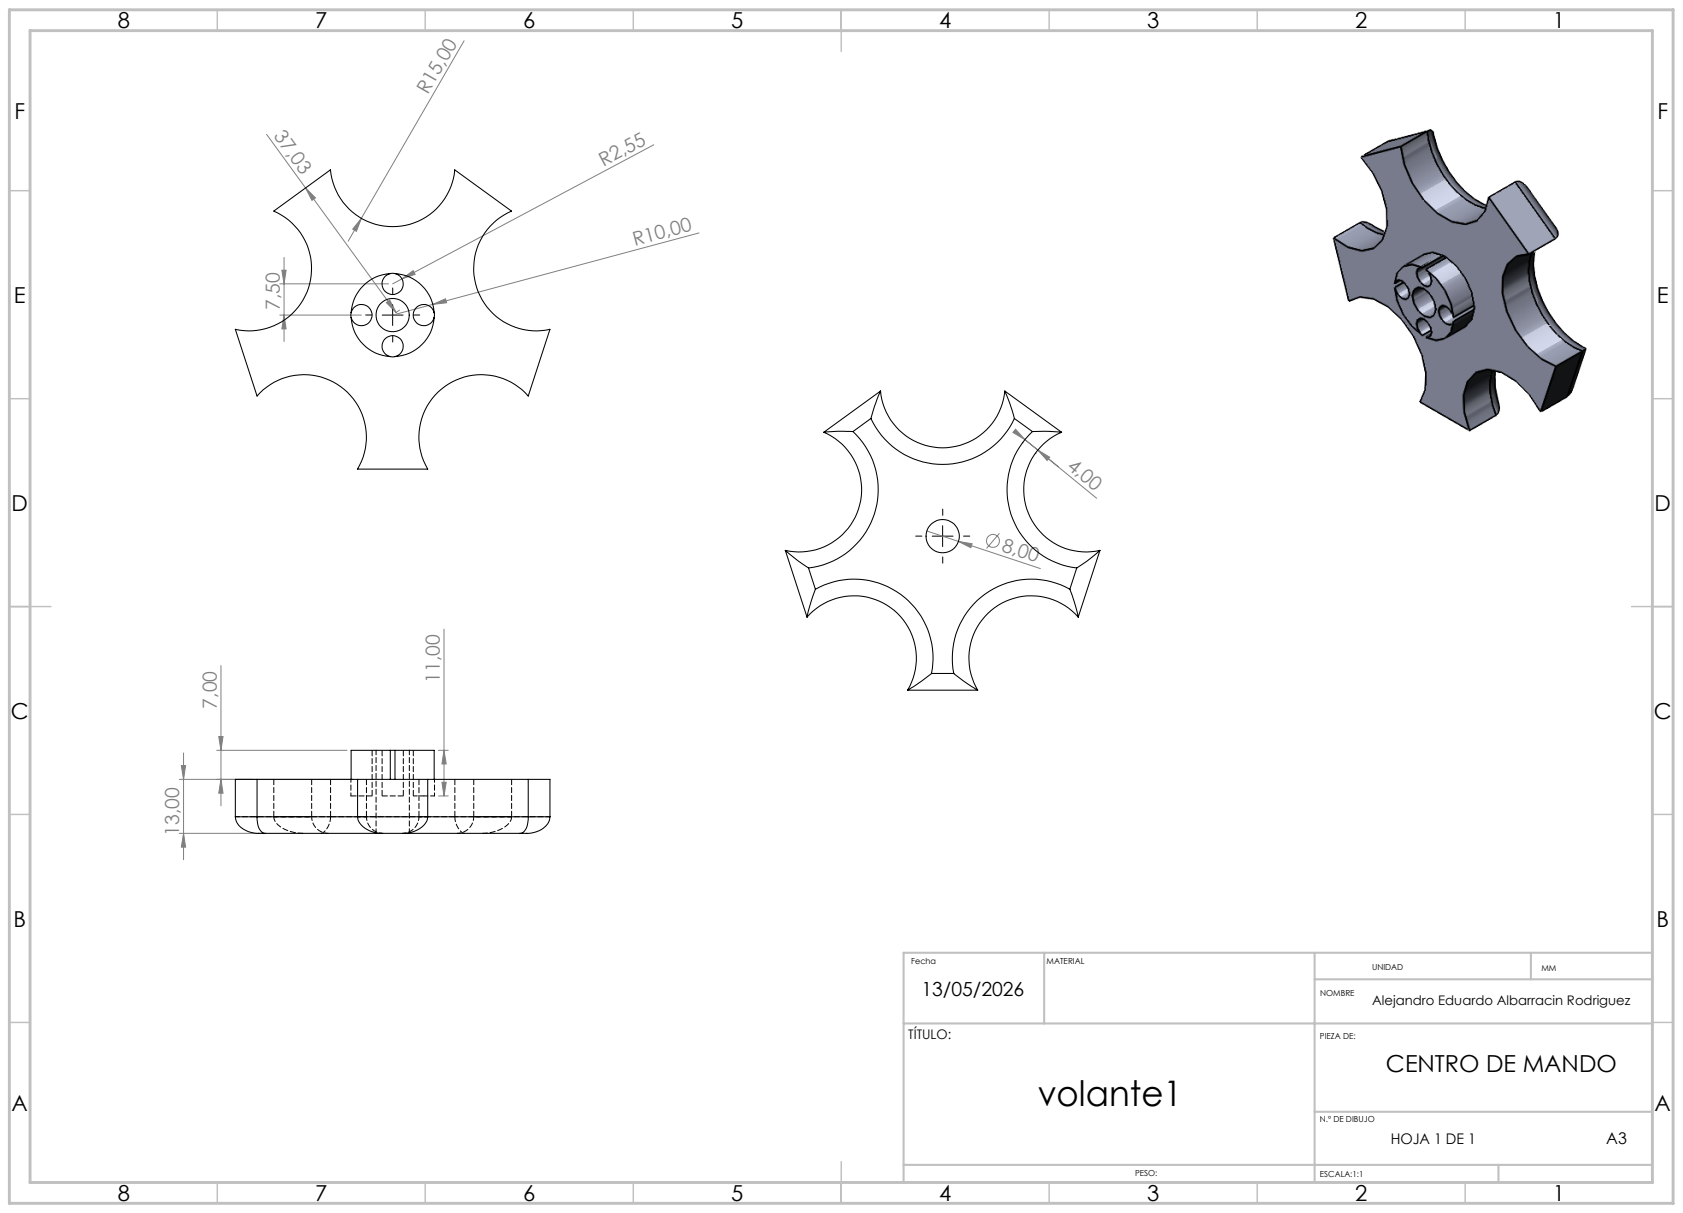
[picture p127: page 1]
N.º DE DIBUJO; HOJA 1 DE 1; Alejandro Eduardo Albarracin Rodriguez

TÍTULO: volante1 | PIEZA DE: CENTRO DE MANDO
