albale15/simulador_de_Extraccion_de_polipos_intestinales/Planos/centro de mando/pdfs/volante2.pdf

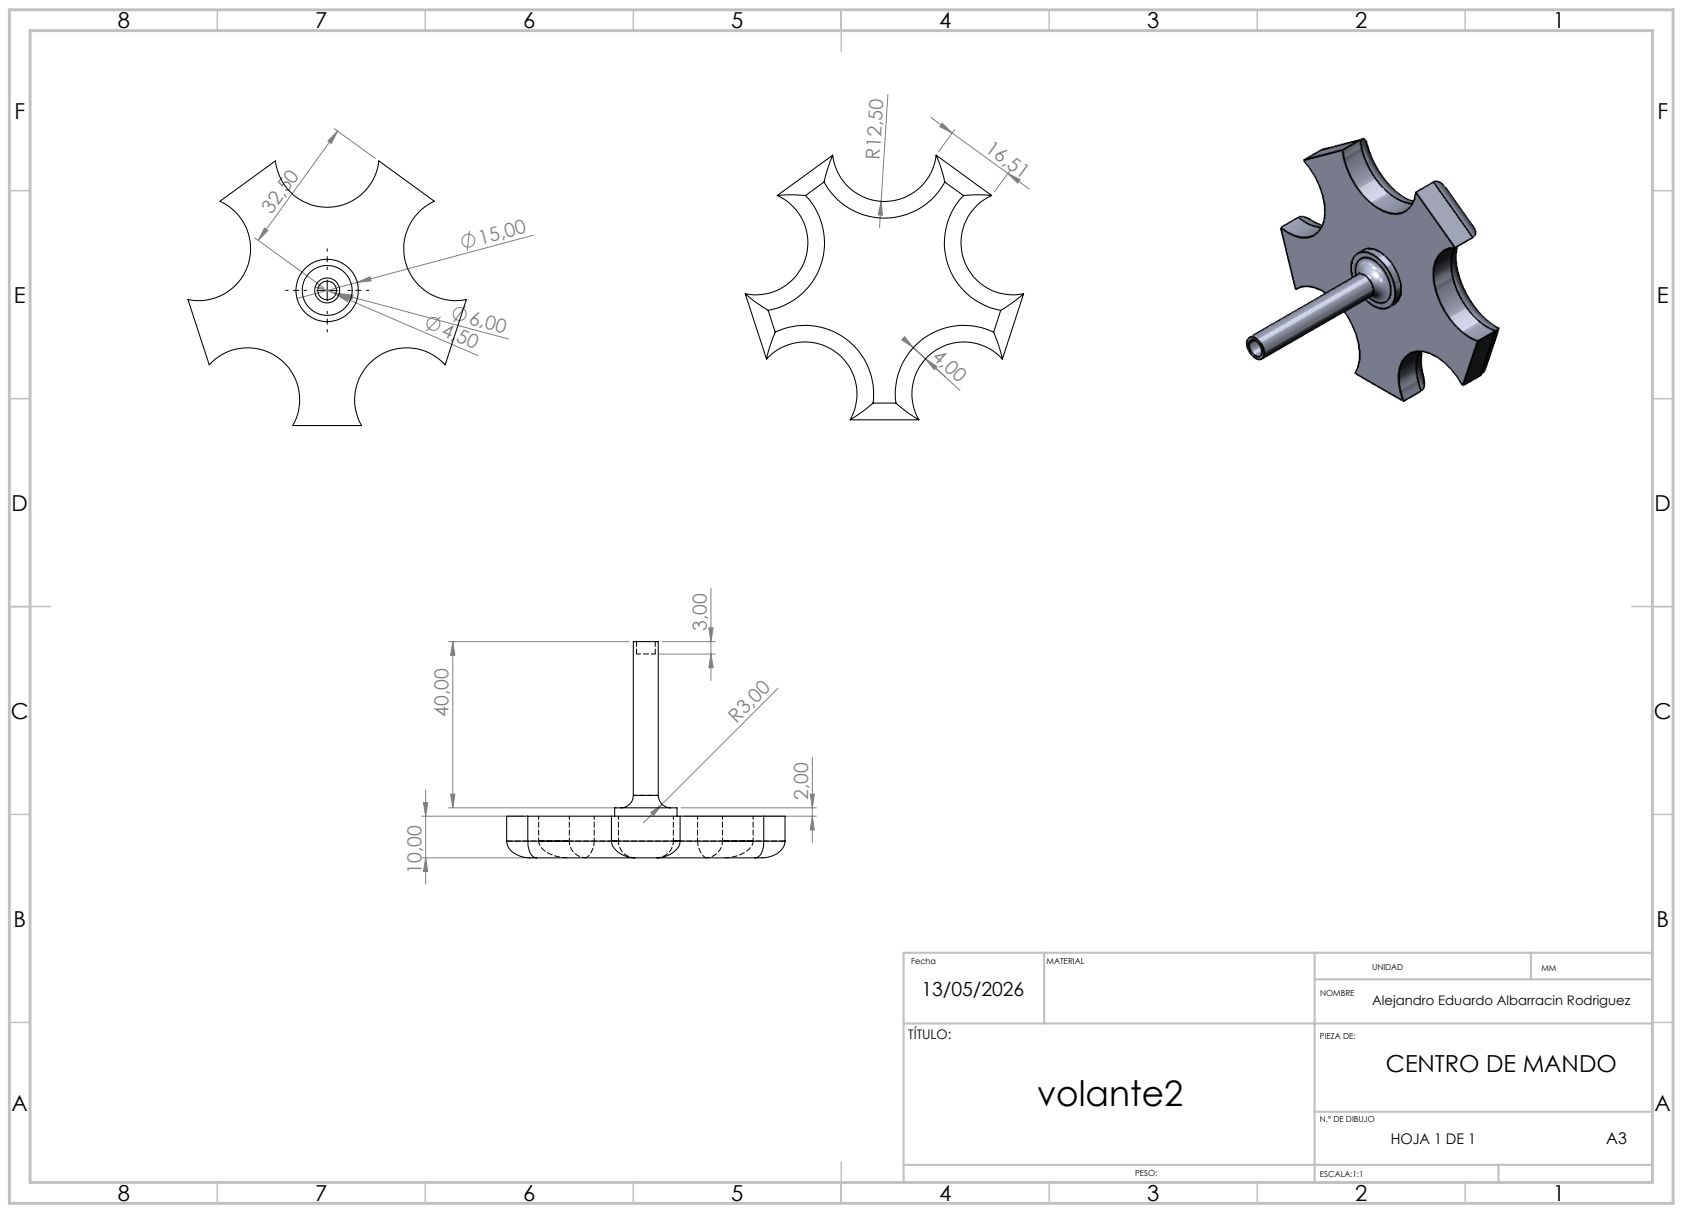
[picture p128: page 1]
N.º DE DIBUJO; HOJA 1 DE 1; Alejandro Eduardo Albarracin Rodriguez

TÍTULO: volante2 | PIEZA DE: CENTRO DE MANDO
