albale15/simulador_de_Extraccion_de_polipos_intestinales/Planos/mecanismo de insercion/pdf/EngraneEncoderR2.pdf

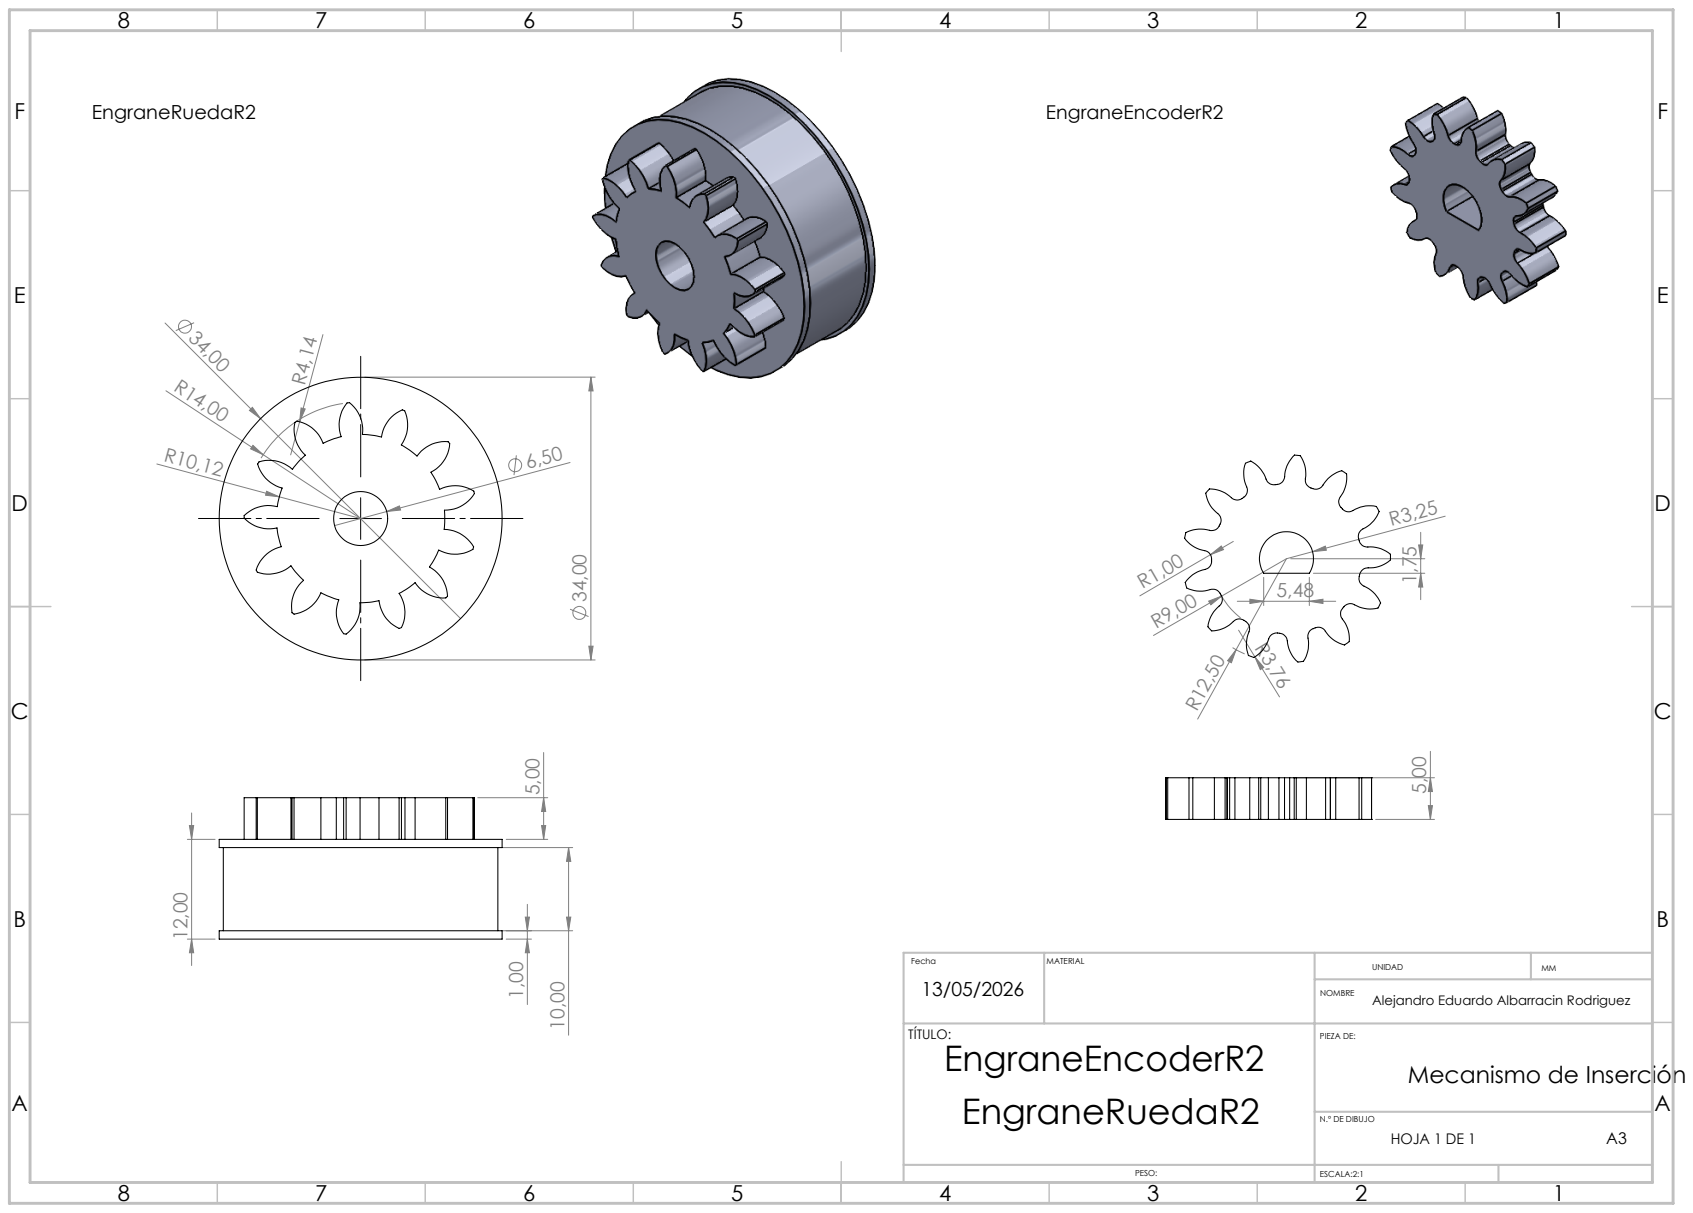
[picture p130: page 1]
N.º DE DIBUJO; HOJA 1 DE 1; Alejandro Eduardo Albarracin Rodriguez

PIEZA DE:
Mecanismo de Inserción
