albale15/simulador_de_Extraccion_de_polipos_intestinales/Planos/mecanismo de insercion/pdf/parte2TapaEngranes.pdf

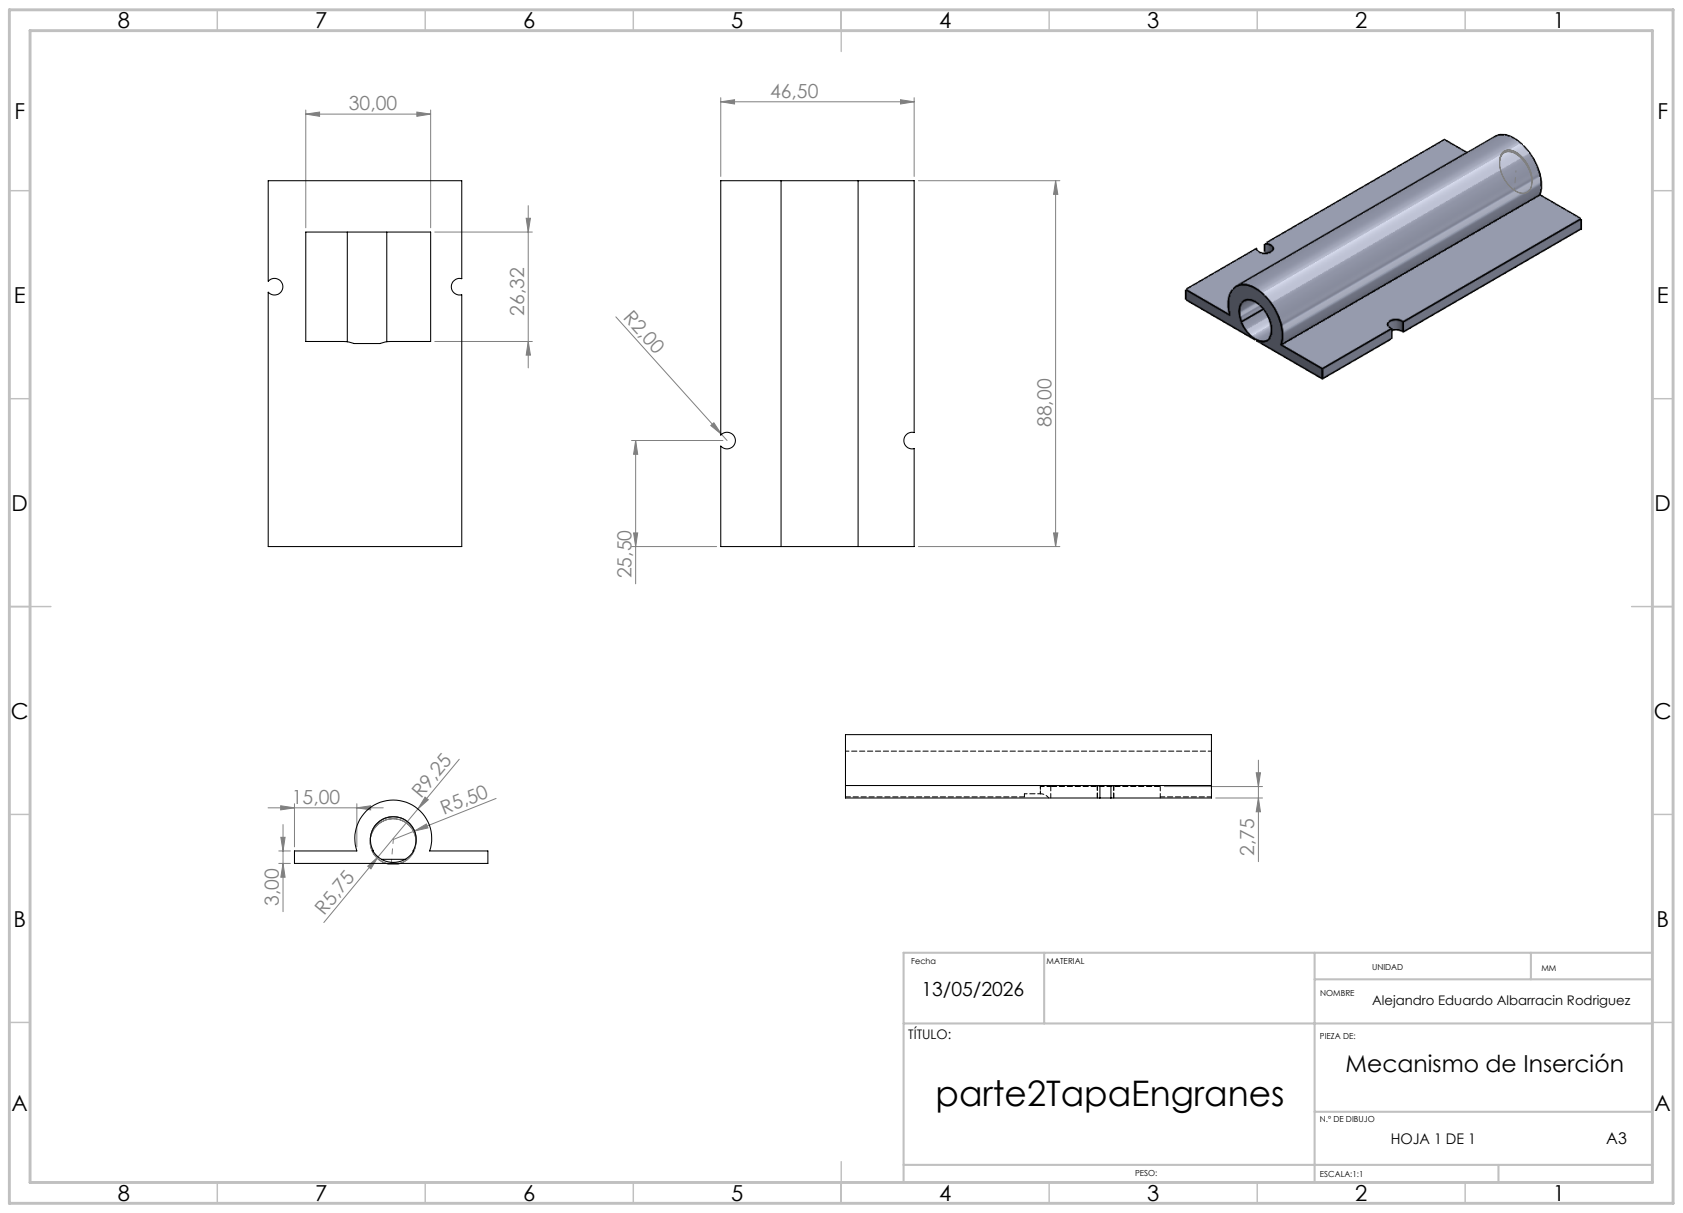
[picture p131: page 1]
N.º DE DIBUJO; HOJA 1 DE 1; Alejandro Eduardo Albarracin Rodriguez

TÍTULO: parte2TapaEngranes | PIEZA DE: Mecanismo de Inserción
