albale15/simulador_de_Extraccion_de_polipos_intestinales/(list of files, drawings)

Other design files:
placa de circuito/circuito final para pcb.pdsprj
placa de circuito/Project Backups/circuito final para pcb [20260512, 11-32-25].pdsprj
placa de circuito/Project Backups/circuito final para pcb [20260512, 11-46-20].pdsprj
placa de circuito/Project Backups/circuito final para pcb [20260512, 11-51-24].pdsprj
placa de circuito/Project Backups/circuito final para pcb [20260512, 11-54-33].pdsprj
placa de circuito/Project Backups/circuito final para pcb [20260512, 11-55-44].pdsprj
placa de circuito/Project Backups/circuito final para pcb [20260512, 12-01-31].pdsprj
placa de circuito/Project Backups/circuito final para pcb [20260512, 19-24-50].pdsprj
placa de circuito/Project Backups/circuito final para pcb [20260513, 12-06-21].pdsprj
placa de circuito/Project Backups/circuito final para pcb [20260513, 12-13-48].pdsprj
placa de circuito/Project Backups/circuito final para pcb [20260513, 16-23-40].pdsprj
