albale15/simulador_de_Extraccion_de_polipos_intestinales/stm32 centro de mando/Core/Src/main.c

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
/* Includes ------------------------------------------------------------------*/
#include "main.h"
#include "i2c.h"
#include "tim.h"
#include "usart.h"
#include "gpio.h"

/* USER CODE BEGIN Includes */
#include <stdio.h>  // Necesario para printf y sscanf
#include <string.h>
/* USER CODE END Includes */


/* USER CODE BEGIN PV */
uint8_t btn_lim, btn_su, btn1, btn2, btn3, btn4;
uint8_t bl_last=0, bs_last=0, b1_last=0, b2_last=0, b3_last=0, b4_last=0;
uint16_t angulo_anterior_1 = 0, angulo_anterior_2 = 0;
int32_t enc1_accumulator = 0, enc2_accumulator = 0;
//4096 pulsos del sensor en 360 grados
const int32_t MAGNETIC_THRESHOLD_1 = 90; // Para el volante 1 e2 de 8 grado
const int32_t MAGNETIC_THRESHOLD_2 = 90; // Para el volante 2 e1 de 8 grado es mayor por la transmision
int8_t enc1_send = 0, enc2_send = 0, activate = 0;

volatile int32_t encoder_insercion = 0;
uint32_t last_irq_ins = 0;
int8_t pasos_acumulados_ins = 0;
const int8_t PASOS_POR_CLICK = 2;


uint8_t err_encoder = 0;


uint8_t rx_byte;
char rx_buffer[20];
uint8_t rx_index = 0;
uint8_t mensaje_completo = 0;

// VARIABLES PARA EL VIBRADOR
uint32_t tiempo_inicio_vibracion = 0;
uint8_t vibrando = 0;


// Tabla de estados válidos del encoder
// Solo suma 1 o resta -1 si la secuencia física es matemáticamente correcta.
const int8_t tabla_encoder[16] = {0, 1, -1, 0, -1, 0, 0, 1, 1, 0, 0, -1, 0, -1, 1, 0};

// Memoria para guardar el estado del milisegundo anterior
uint8_t estado_ant_1 = 0;
uint8_t estado_ant_2 = 0;

/* USER CODE END PV */

void SystemClock_Config(void);
/* USER CODE BEGIN 0 */
#define AS5600_ADDR 0x6C // 0x36 desplazado a la izquierda para STM32
#define RAW_ANGLE_REG 0x0C

// Llamamos a los puertos I2C que configurarás en el CubeIDE
extern I2C_HandleTypeDef hi2c1;
extern I2C_HandleTypeDef hi2c3;


uint8_t readButton(GPIO_TypeDef* GPIOx, uint16_t GPIO_Pin, uint8_t *lastState) {
    uint8_t current = HAL_GPIO_ReadPin(GPIOx, GPIO_Pin);
    uint8_t pressed = 0;

    if (current != *lastState) {
        HAL_Delay(10); // debounce
        current = HAL_GPIO_ReadPin(GPIOx, GPIO_Pin);

        if (current != *lastState) {
            *lastState = current;
            if (current == 1) pressed = 1; // Solo reacciona al soltar/presionar (flanco de subida)
        }
    }
    return pressed;
}

// Leer ángulo del AS5600
uint16_t Leer_Angulo_AS5600(I2C_HandleTypeDef *hi2c, uint16_t angulo_seguro) {
    uint8_t buffer[2];
    // Solicitamos 2 bytes desde el registro 0x0C
    if (HAL_I2C_Mem_Read(hi2c, AS5600_ADDR, RAW_ANGLE_REG, I2C_MEMADD_SIZE_8BIT, buffer, 2, 10) == HAL_OK) {
        uint16_t angulo = (buffer[0] << 8) | buffer[1];
        return angulo & 0x0FFF; // Filtramos la basura para dejar solo 12 bits
    }
    return angulo_seguro; // Si el I2C falla Retorna 0 si el sensor está desconectado
}

int _write(int file, char *ptr, int len) {
    HAL_UART_Transmit(&huart2, (uint8_t*)ptr, len, HAL_MAX_DELAY);
    return len;
}
// INTERRUPCIONES DE LOS ENCODERS (Máquina de Estados)
void HAL_GPIO_EXTI_Callback(uint16_t GPIO_Pin) {

    // ENCODER 1: Inserción (PB5 = CLK, PA12 = DT)
    if(GPIO_Pin == GPIO_PIN_5 || GPIO_Pin == GPIO_PIN_12) {

        uint8_t clk = HAL_GPIO_ReadPin(GPIOB, GPIO_PIN_5);
        uint8_t dt = HAL_GPIO_ReadPin(GPIOA, GPIO_PIN_12);

        uint8_t estado_actual = (clk << 1) | dt;
        uint8_t indice = (estado_ant_1 << 2) | estado_actual;

        int8_t movimiento = tabla_encoder[indice];

        if(movimiento != 0) {
            // En lugar de disparar directo, ACUMULAMOS los micropasos
            pasos_acumulados_ins += movimiento;

            // Verificamos si ya se completó el "Click Físico"
            if(pasos_acumulados_ins >= PASOS_POR_CLICK) {
                encoder_insercion += 1;
                activate = 1;
                pasos_acumulados_ins = 0; // Vaciamos el acumulador
            }
            else if(pasos_acumulados_ins <= -PASOS_POR_CLICK) {
                encoder_insercion -= 1;
                activate = 1;
                pasos_acumulados_ins = 0; // Vaciamos el acumulador
            }
        }

        estado_ant_1 = estado_actual;
    }
}
// INTERRUPCIÓN DE RECEPCIÓN UART (Mensajes de Unity)
// Unity debe enviar mensajes terminados en '\n', ej: "V1:100\n"

void HAL_UART_RxCpltCallback(UART_HandleTypeDef *huart) {
    if(huart->Instance == USART2) {

        // 1. CASO  pregunta de identificación?
        if(rx_byte == '?') {
            // Respondemos con la firma única del proyecto
            // El \n es vital para que el puerto serial de Unity sepa que terminó la línea
            printf("ID:ENDOSCOPIO_V1\n");

            // NO guardamos el '?' en el buffer, simplemente reiniciamos la escucha
        }
        // CASO PING INSTANTÁNEO
        else if(rx_byte == 'P') {
			printf("PONG\r\n"); // Rebota a la velocidad de la luz
		}
		// ------------------------------------
		// 2. CASO NORMAL: Mensajes de vibración terminados en \n
		else {
			if(rx_byte == '\n' || rx_index >= 19) {
				rx_buffer[rx_index] = '\0'; // Terminamos el string
				mensaje_completo = 1;
				rx_index = 0;
			} else {
				rx_buffer[rx_index++] = rx_byte;
			}
		}

        // 3. CONTINUIDAD: Volvemos a habilitar la escucha del siguiente byte
        HAL_UART_Receive_IT(&huart2, &rx_byte, 1);
    }
}
/* USER CODE END 0 */

/**
  * @brief  The application entry point.
  * @retval int
  */
int main(void)
{

  /* MCU Configuration--------------------------------------------------------*/

  /* Reset of all peripherals, Initializes the Flash interface and the Systick. */
  HAL_Init();

  /* Configure the system clock */
  SystemClock_Config();

  /* Initialize all configured peripherals */
  MX_GPIO_Init();
  MX_I2C1_Init();
  MX_I2C3_Init();
  MX_TIM2_Init();
  MX_USART2_UART_Init();
  /* USER CODE BEGIN 2 */
  printf("\r\n--- INICIANDO TEST CRUDO I2C ---\r\n");
    uint8_t test_buffer[2];

    // Test I2C1 (Volante 1 en PA9/PA10)
    if(HAL_I2C_Mem_Read(&hi2c1, 0x6C, 0x0C, I2C_MEMADD_SIZE_8BIT, test_buffer, 2, 100) == HAL_OK) {
        printf(">>> I2C1 (PA9/PB10) VIVO <<< Angulo: %d\r\n", (test_buffer[0] << 8) | test_buffer[1]);
    } else {
        uint32_t err1 = HAL_I2C_GetError(&hi2c1);
        printf("I2C1 MUERTO. Codigo error HAL: %lu\r\n", err1);
    }

    // Test I2C3 (Volante 2 en PA7 / PB4)
    if(HAL_I2C_Mem_Read(&hi2c3, 0x6C, 0x0C, I2C_MEMADD_SIZE_8BIT, test_buffer, 2, 100) == HAL_OK) {
        printf(">>> I2C3 (PA7/PB4) VIVO <<< Angulo: %d\r\n", (test_buffer[0] << 8) | test_buffer[1]);
    } else {
        uint32_t err3 = HAL_I2C_GetError(&hi2c3);
        printf("I2C3 MUERTO. Codigo error HAL: %lu\r\n", err3);
    }

    printf("--------------------------------\r\n");
    HAL_Delay(3000);
  // Encender PWM de Motores en 0% (TIM2)
  HAL_TIM_PWM_Start(&htim2, TIM_CHANNEL_1); // PA0
  HAL_TIM_PWM_Start(&htim2, TIM_CHANNEL_2); // PA1
  TIM2->CCR1 = 0; // Motor 1 apagado (0 a 1000)
  TIM2->CCR2 = 0; // Motor 2 apagado

  // Iniciar escucha por Serial (UART2)
  HAL_UART_Receive_IT(&huart2, &rx_byte, 1);

  // Lectura inicial de AS5600
  angulo_anterior_1 = Leer_Angulo_AS5600(&hi2c1, 1512);
  angulo_anterior_2 = Leer_Angulo_AS5600(&hi2c3, 1512);
  /* USER CODE END 2 */

  /* Infinite loop */
  /* USER CODE BEGIN WHILE */
  while (1)
    {


	    // 1. BOTONES
	    btn_lim = readButton(GPIOB, GPIO_PIN_1, &bl_last);
	    btn_su  = readButton(GPIOA, GPIO_PIN_3, &bs_last);
	    btn1    = readButton(GPIOA, GPIO_PIN_4, &b1_last);
	    btn2    = readButton(GPIOA, GPIO_PIN_6, &b2_last);
	    btn3    = readButton(GPIOA, GPIO_PIN_8, &b3_last);
	    btn4    = readButton(GPIOB, GPIO_PIN_0, &b4_last);

		// 2. VOLANTES (AS5600)
	    uint16_t angulo_actual_1 = Leer_Angulo_AS5600(&hi2c1, angulo_anterior_1);
		uint16_t angulo_actual_2 = Leer_Angulo_AS5600(&hi2c3, angulo_anterior_2);

		if(angulo_actual_1 == 1512 && angulo_actual_2 == 1512) err_encoder = 1;
		else err_encoder = 0;

		int16_t diff_1 = angulo_actual_1 - angulo_anterior_1;
		int16_t diff_2 = angulo_actual_2 - angulo_anterior_2;

		if (diff_1 > 2048) diff_1 -= 4096;
		if (diff_1 < -2048) diff_1 += 4096;
		if (diff_2 > 2048) diff_2 -= 4096;
		if (diff_2 < -2048) diff_2 += 4096;

		angulo_anterior_1 = angulo_actual_1;
		angulo_anterior_2 = angulo_actual_2;

		enc1_accumulator += diff_1;
		enc2_accumulator += diff_2;

		if (enc1_accumulator >= MAGNETIC_THRESHOLD_1) {
					enc1_send = 1; enc1_accumulator -= MAGNETIC_THRESHOLD_1; activate = 1;
		} else if (enc1_accumulator <= -MAGNETIC_THRESHOLD_1) {
			enc1_send = -1; enc1_accumulator += MAGNETIC_THRESHOLD_1; activate = 1;
		}

		if (enc2_accumulator >= MAGNETIC_THRESHOLD_2) {
			enc2_send = 1; enc2_accumulator -= MAGNETIC_THRESHOLD_2; activate = 1;
		} else if (enc2_accumulator <= -MAGNETIC_THRESHOLD_2) {
			enc2_send = -1; enc2_accumulator += MAGNETIC_THRESHOLD_2; activate = 1;
		}

		// 3. RECEPCIÓN UNITY -> VIBRACIÓN (COPIA SEGURA ANTI-CORRUPCIÓN)
		if(mensaje_completo == 1) {
			char local_buffer[20];

			// --- ZONA CRÍTICA ---
			// Deshabilitamos interrupciones globales un instante para que la UART
			// no modifique el string mientras lo estamos duplicando.
			__disable_irq();
			strcpy(local_buffer, (char*)rx_buffer);
			mensaje_completo = 0; // Bajamos la bandera inmediatamente
			__enable_irq();
			// --- FIN ZONA CRÍTICA ---

			int fuerza_motor = 0;

			// Ahora escaneamos el buffer local aislado. La UART puede interrumpir
			// y escribir en rx_buffer todo lo que quiera, no nos corromperá este análisis.
			if(sscanf(local_buffer, "V1:%d", &fuerza_motor) == 1) {
				TIM2->CCR1 = fuerza_motor;
				tiempo_inicio_vibracion = HAL_GetTick();
				vibrando = 1;
			}
			else if(sscanf(local_buffer, "V2:%d", &fuerza_motor) == 1) {
				TIM2->CCR2 = fuerza_motor;
				tiempo_inicio_vibracion = HAL_GetTick();
				vibrando = 1;
			}
		}

		  // 4. EL AUTO-APAGADO DEL VIBRADOR (Cooldown de 1 segundo)
		  if(vibrando == 1 && (HAL_GetTick() - tiempo_inicio_vibracion >= 1000)) {
			  TIM2->CCR1 = 0; // Apaga Motor 1
			  TIM2->CCR2 = 0; // Apaga Motor 2
			  vibrando = 0;   // Resetea el estado
		  }
		// 5. ENVÍO DE DATOS A UNITY
		  if (btn_lim || btn_su || btn1 || btn2 || btn3 || btn4 || activate == 1) {

			  // Limitador a +1 / -1 solo para Inserción
			  if (encoder_insercion > 1) encoder_insercion = 1;
			  else if (encoder_insercion < -1) encoder_insercion = -1;

			  //FORMATO DE ENVÍO ORDENADO
			  // Lim:0 Su:0 B1:0 B2:0 B3:0 B4:0 E1:0 E2:0 INS:0
			  printf("Lim:%d Su:%d B1:%d B2:%d B3:%d B4:%d E1:%d E2:%d INS:%ld\r\n",
					 btn_lim, btn_su, btn1, btn2, btn3, btn4,
					 enc2_send, enc1_send, -encoder_insercion);

			  activate = 0;
			  enc1_send = 0;
			  enc2_send = 0;
			  encoder_insercion = 0;
		  }

		  HAL_Delay(10);
	  }
    /* USER CODE END WHILE */

}

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
/* USER CODE BEGIN 4 */

// PROTOCOLO DE RESURRECCIÓN UART
void HAL_UART_ErrorCallback(UART_HandleTypeDef *huart) {
    if (huart->Instance == USART2) {

        // 1. Limpiamos las banderas de error de hardware (Overrun, Noise, Framing)
        __HAL_UART_CLEAR_OREFLAG(huart);
        __HAL_UART_CLEAR_NEFLAG(huart);
        __HAL_UART_CLEAR_FEFLAG(huart);

        // 2. Forzamos a la UART a volver a escuchar
        HAL_UART_Receive_IT(&huart2, &rx_byte, 1);
    }
}
/* USER CODE END 4 */
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
