albale15/simulador_de_Extraccion_de_polipos_intestinales/codigos/centro de mando/Core/Inc/main.h

#define MCO_Pin GPIO_PIN_0
#define MCO_GPIO_Port GPIOA
#define VCP_TX_Pin GPIO_PIN_2
#define VCP_TX_GPIO_Port GPIOA
#define VCP_RX_Pin GPIO_PIN_3
#define VCP_RX_GPIO_Port GPIOA
#define SWDIO_Pin GPIO_PIN_13
#define SWDIO_GPIO_Port GPIOA
#define SWCLK_Pin GPIO_PIN_14
#define SWCLK_GPIO_Port GPIOA
#define LD3_Pin GPIO_PIN_3
#define LD3_GPIO_Port GPIOB
