albale15/simulador_de_Extraccion_de_polipos_intestinales/(commit log)

2026-04-06 subida de datos hardware y circuito v0.1
    [agarres.SLDPRT, base carcasa.SLDPRT, basecarcasav2.SLDPRT, caja de encoders.SLDPRT, circuito final para pcb.pdsprj, engrane1.SLDPRT, engrane2.SLDPRT, listaDeMatertiales.xlsx]
2026-04-07 circuito de pistas de la pcb v1
    se diseño la pcb para su creacion de manera fisica y hacer pruebas del sistema ya en un ambiente mas realista.
    [circuito final para pcb [20260407, 10-30-43].pdsprj, circuito final para pcb [20260407, 10-35-47].pdsprj, circuito final para pcb [20260407, 11-19-37].pdsprj, circuito final para pcb [20260407, 11-45-43].pdsprj, circuito final para pcb [20260407, 11-48-25].pdsprj, circuito final para pcb [20260407, 11-55-16].pdsprj, circuito final para pcb [20260407, 11-58-12].pdsprj, circuito final para pcb.pdsp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]
2026-04-07 vercion del cirtcuito con pistas t40
    [circuito final para pcb [20260407, 10-30-43].pdsprj, circuito final para pcb [20260407, 10-35-47].pdsprj, circuito final para pcb [20260407, 11-19-37].pdsprj, circuito final para pcb [20260407, 12-01-08].pdsprj, circuito final para pcb [20260407, 12-18-33].pdsprj, circuito final para pcb [20260407, 12-19-16].pdsprj, circuito final para pcb [20260407, 12-19-57].pdsprj, circuito final para pcb [202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]
2026-04-07 vercion del cirtcuito mejora de pistas t40
    se arreglo el crosor para el soldado correcto de las piezas
    [circuito final para pcb [20260407, 11-45-43].pdsprj, circuito final para pcb [20260407, 16-31-10].pdsprj, circuito final para pcb.pdsprj]
2026-04-09 cambios en el modelado mecanico para ingreso de la placa
    [base carcasa.SLDPRT, basecarcasav2.SLDPRT, basecircuitov1.SLDPRT, circuito final para pcb [20260407, 11-48-25].pdsprj, circuito final para pcb [20260407, 18-58-24].pdsprj, circuito final para pcb.pdsprj, creacion de elementos.SLDPRT, listaDeMatertiales.xlsx]
2026-04-13 cambios para la prueba v1
    [base carcasa.SLDPRT, circuito final para pcb [20260407, 11-55-16].pdsprj, circuito final para pcb [20260407, 11-58-12].pdsprj, circuito final para pcb [20260410, 19-26-46].pdsprj, circuito final para pcb [20260413, 10-57-03].pdsprj, circuito final para pcb.pdsprj, listaDeMatertiales.xlsx, tapa.SLDPRT]
2026-04-17 arreglos del circuito para version final
    se agrego una guia de pines ademas de arreglarel diseño del circuito ya con pruiebas reales en placa
    [circuito final para pcb [20260407, 12-01-08].pdsprj, circuito final para pcb [20260407, 12-18-33].pdsprj, circuito final para pcb [20260407, 12-19-16].pdsprj, circuito final para pcb [20260407, 12-19-57].pdsprj, circuito final para pcb [20260407, 12-19-58].pdsprj, circuito final para pcb [20260407, 13-04-11].pdsprj, circuito final para pcb [20260407, 16-31-10].pdsprj, circuito final para pcb [202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]
2026-04-17 arreglos del modelo, creacion de la parte de la mesa de insercion
    en este modulo se arreglo los detalles de la carcasa para que el cable usb entre de manera optima, ademas se avanzo en la version 1 del diseño de la caja de encoders y el tubo de insercion
    [BaseEncodersEngranes.SLDPRT, BaseRasp.SLDPRT, EngraneEncoderR1.SLDPRT, EngraneEncoderR2.SLDPRT, EngraneRuedaR1.SLDPRT, EngraneRuedaR1.STL, EngraneRuedaR2.SLDPRT, EngraneRuedaR2.STL]
2026-04-17 Configuración inicial de Unity y Gitignore y creacion del proyecto de unity
    [creacion de elementos.SLDPRT]
2026-04-18 Agregue el logotipo y actualice la configuración del proyecto de Unity.
    Agregue el logotipo de endoscopia (PNG) con su archivo Unity .meta y regístrelo como un recurso de compilación/icono. Actualice ProjectSettings: establezca companyName en 'Sagitus Entmt.', agregue Standalone applicationIdentifier, registre la entrada del icono haciendo referencia al nuevo GUID y cambie apiCompatibilityLevel. Actualice editor/UserSettings (ajustes de diseño, Search.index y Search.settings). Incluya también los archivos de proyecto CAD/PCB modificados y elimine un archivo temporal de SolidWorks. Estos cambios aplican la marca y las preferencias del editor para simulador_extracción_polipos_I.
    [creacion de elementos.SLDPRT]
2026-04-18 creacion de elementos y codigo v1 stm32
2026-04-18 Agregar interfaz de usuario de conectividad serial y protocolo de enlace STM32
    Agregar conectividad serial del lado de Unity: nuevo SerialManager (Assets/.../conectividad) que escanea puertos COM, realiza un handshake, crea un hilo lector en segundo plano y expone estado/puerto/ultimoJson; y ConnectivityUI que vincula elementos TextMeshPro para mostrar el estado de la conexión y JSON sin procesar. Actualizar MenuPrincipal.unity para incluir UI GameObjects (variablesDatos, fondo, conexionConCentroDeMando) y renombrar un objeto de texto a tituloCentroDeMando; agregar archivos .meta relacionados. Modificar el firmware STM32 (Core/Src/main.c) para que responda a '?' con "ID:ENDOSCOPIO_V1\n" en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
2026-04-19 crea<cion de aplicaciondes y pruebas de conectibvidad
    [BaseEncodersEngranes.SLDPRT, BaseRasp.SLDPRT, CE3E3V2_parteMediaCajaEngranes.3mf, EngraneEncoderR1.SLDPRT, EngraneEncoderR2.SLDPRT, EngraneRuedaR1.SLDPRT, EngraneRuedaR2.SLDPRT, ParedSoporteEngranes.SLDPRT]
2026-04-19 Reestructurar los archivos de compilación de Linux; actualizar Windows
    Normaliza y mueve los artefactos de compilación de Linux (cambia el nombre de las rutas eliminando espacios a simulador_Endoscopico_*, agrega nuevos archivos de datos como Assembly-CSharp.dll, UnityPlayer.png, recursos level0 y sharedassets0, y elimina los duplicados antiguos). Actualiza varios archivos de tiempo de ejecución (boot.config, globalgamemanagers, resources.assets, sharedassets) y bibliotecas MonoBleedingEdge en la compilación de Linux. También aplica actualizaciones a los artefactos de compilación de Windows y archivos de proyecto de Unity: modifica los archivos ejecutables y de datos de Windows, y camb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
2026-04-19 Agregar archivos temporales de Word y docx de GDD
    Agregue el documento de diseño 'GDD Simulador de Extracción de Pólipos Intestinales.docx'). El archivo .docx principal contiene el diseño y las especificaciones del Simulador de Extracción de Pólipos Intestinales.
2026-04-20 Agregar la interfaz de usuario del menú principal y el controlador Menu_Principal.
    Actualiza MenuPrincipal.unity para añadir los elementos de la interfaz de usuario del menú principal (botones, paneles, textos TMP, administrador de MenuPrincipal) y ajusta la configuración de RectTransform y la fuente. Añade un nuevo script de controlador Assets/Scripts/Menu_Principal/ControladorMenuPrincipal.cs (con .meta) para gestionar la lógica del menú. Además, actualiza el diseño de UserSettings (default-2022.dwlt) para reflejar los cambios en el diseño del editor.
2026-04-20 v1 menu principal_Agregar interfaz de usuario de configuración, envío serial; actualizar MenuPrincipal
    Agregue scripts ConfigManager (singleton) y ConfigUI para almacenar y exponer configuraciones de usuario (inserción/torsión/controles) y para controlar la interfaz de usuario de configuración. Extienda SerialManager con EnviarDato(string) para que la interfaz de usuario pueda enviar comandos de vibración de prueba al STM32 cuando esté conectado. Actualice MenuPrincipal.unity para agregar elementos de interfaz de usuario de configuración/salida, conectar varios eventos OnClick a ControladorMenuPrincipal (MostrarPantallaConfiguracion, SalirDeLaAplicacion, MostrarPantallaHistorial, Mos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
    [BaseEncodersEngranes.SLDPRT, BaseEncodersEngranes.STL, BaseRasp.SLDPRT, EngraneEncoderR1.SLDPRT, EngraneEncoderR2.SLDPRT, EngraneRuedaR1.SLDPRT, EngraneRuedaR2.SLDPRT, ParedSoporteEngranes.SLDPRT]
2026-04-22 version 1 escena configuracion funcional Actualizar la interfaz de usuario de MenuPrincipal, añadir modelos y copias de seguridad de STM32.
    Refactorización de MenuPrincipal.unity UI: se reorganizaron y renombraron varios GameObjects (p. ej. botones_de_accion -> PruebaVibracion, variablesDatos -> ConfiguracionRotativos, Canvas -> Configuracionboton, etc.), se ajustaron RectTransforms/anchors/sizes, se actualizaron los destinos de los botones y los enlaces OnClick a los métodos ConfigUI (ProbarVibracionSTM, MapearVolYArr), se cambió el texto/color/estilo de TextMeshPro. Actualización de los scripts relacionados: ConnectivityUI.cs, ConfigManager.cs, ConfigUI.cs, SerialManager.cs. Agregar/m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
    [BaseEncodersEngranes.SLDPRT, BaseEncodersEngranes.STL, EngraneEncoderR1.STL, EngraneEncoderR2.STL, EngraneRuedaR1.SLDPRT, EngraneRuedaR1.STL, EngraneRuedaR2.SLDPRT, EngraneRuedaR2.STL]
2026-04-22 version 0.2 Menu Principal Agregar administrador de historial/interfaz de usuario y pantalla de carga
    Introducir un sistema de historial y un flujo de inicio mejorado: agrega las clases HistoryManager, HistoryUI y SesionPractica (lector archivos json, exportación CSV, eliminar/exportar) y sus archivos meta; agrega un prefab Molde_BotonArchivo y meta de carpeta. Implementar una rutina de splash loading en ControladorMenuPrincipal (RutinaDeCargaReal) con campos de UI (barra de progreso, texto de estado) y alternancias de pantalla más seguras. Actualizar ConnectivityUI para eliminar el manejo directo del panel de carga y ajustar el manejo de estado para el estado Iniciando. Actualización me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
2026-04-22 Agregar escena de juego y actualizar la interfaz de usuario del menú principal.
    Se añade la nueva escena EscenaGameplay (y .meta) y se introducen los scripts previaDeLaPartida (SetupUI.cs, manejadorDePartida.cs). Se realizan modificaciones importantes en MenuPrincipal.unity: cambios en la jerarquía de la interfaz de usuario y RectTransform, se renombran elementos, se ajustan el texto, la fuente y el diseño, y se actualizan los componentes de la interfaz de usuario (incluidos los cambios en HistoryManager/HistoryUI). Se actualizan los ajustes de compilación del usuario del proyecto y del editor para incluir la nueva escena y los ajustes de la interfaz de usuario.
2026-04-23 Agregar elementos de intestino y pólipos en 3D
    Agregue varios modelos 3D (FBX y BLEND) para los recursos de intestino y pólipos en la aplicación/modelados3d e importe copias al proyecto de Unity (aplicacion/simulador_extraction_polipos_I/Assets/3D) con los archivos .meta correspondientes. Actualice EscenaGameplay.unity para agregar instancias de prefab para intestinoMASgRANDE, intestinoparaunity y Set_Polipos_Yamada. Ajuste EditorUserSettings y el diseño predeterminado (posiciones y selecciones de ventanas/paneles). Elimine un documento de Word temporal/bloqueado.
    [intestino.blend, intestino2.blend, intestinoMASgRANDE.blend, poliposYamada.blend]
2026-04-25 Agregar/actualizar modelos 3D y configuración de escena de Unity
    Agregue varios recursos 3D (FBX/BLEND) para herramientas y anatomía (pinzaAsas, pinzaDientes, puntaEndoscopio, intestinoMASgRANDE2, etc.) y actualice los modelos existentes (intestinoMASgRANDE, poliposYamada, Set_Polipos_Yamada). Agregue los archivos de recursos de Unity correspondientes y la configuración de importación .meta; reduzca la escala global del ModelImporter intestinoMASgRANDE de 10 a 4. Modifique EscenaGameplay.unity y MenuPrincipal.unity para colocar y configurar nuevos prefabs (transformaciones, escalas, rotaciones), ajuste la cámara cerca del plano de recorte, agregue objetos de juego de colisionador de mal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
    [TapaEngranes.SLDPRT, TapaEngranes.STL, intestinoMASgRANDE.blend, intestinoMASgRANDE2.blend, pinzaAsas.blend, pinzaDientes.blend, poliposYamada.blend, puntaEndoscopio.blend]
2026-04-26 modelo v0.3gameplay primeros resusltados de mecanica movimiento endoscopio-Agregar nuevo controlador de endoscopio y actualizaciones de escena
    Reemplazar ControladorEndoscopio con el nuevo CerebroEndoscopio (EndoscopioCurvas) implementando rotaciones óseas globales, deformación de onda e inserción controlada por física; se eliminó el script antiguo y se actualizó su meta GUID. Agregar/modificar recursos 3D (puntaEndoscopio.fbx actualizado, nuevo puntaEndoscopioConHuesos .blend/.blend1) y ajustar la importación FBX globalScale. Agregar materiales físicos (Assets/Materials/Fisiscas: Material_Resbaladizo, hielo) y carpeta meta, y asignar material al collider de malla en la escena. Actua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
    [intestinoMASgRANDE2.blend, puntaEndoscopio.blend, puntaEndoscopioConHuesos.blend]
2026-04-26 v 0.4 Mejorar los controles del endoscopio y añadir detectores de colisiones.
    Refactorizar el comportamiento del endoscopio y los colliders de escena. Deshabilitar la importación de animación FBX para puntaEndoscopio.fbx. Actualizar EscenaGameplay.unity para agregar múltiples componentes SphereCollider para los huesos del endoscopio y la cámara principal, agregar un MonoBehaviour y Rigidbody de Sistema_Endoscopio con valores de ajuste, ajustar la transformación de la cámara y desactivar un GameObject. Refactorizar CerebroEndoscopio.cs (EndoscopioCurvas): introducir controles separados de torque de inserción y rotación de punta (velocidadTorque, velocidadGiroPunta), suavizado (suavid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
2026-04-26 v0.4.1 Añade fatiga por torsión, detección de bucles y seguridad.
    Introducir simulación médica y mecánica de seguridad para el endoscopio: nuevos ajustes serializados (fuerzas de rigidez/retracción, umbral de bucle, par máximo, intentos y temporizadores), contadores y temporizadores internos, y seguimiento de inputTorque. Implementar reglas de fatiga de par (advertencia de 3 golpes, temporizador de retención para romper, par bloqueado y tolerancia al liberar), detección de bucles/obstrucciones que reduce la velocidad de inserción y acumula advertencias de daño/perforación del paciente, y enderezamiento basado en tensión aplicado a curvas óseas. Refactorizar el manejo de entrad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
    [puntaEndoscopio.blend]
2026-04-26 v0.4.2 Agregar controles de seguridad, renderizado de tubos
    Introduce múltiples funciones de juego y seguridad en el controlador del endoscopio: manejo de fatiga de torque y torque máximo con advertencias y condiciones de fin de juego, detección de bucles/intersecciones automáticas y fricción/desgarro (incluidos temporizadores y advertencias de daño), suavizado de entrada para la dirección y una visualización de tubo externo basada en LineRenderer con gestión de trayectoria. También agrega ajustes de configuración de Rigidbody, historial de curvas para extracción inversa, un asistente ProcesarGameOver y varios contadores/indicadores de estado nuevos para centralizar la lógica de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
2026-04-27 v 0.4.3 Cambiar el nombre y refactorizar el script del endoscopio; actualizar la escena.
    Cambie el nombre de CerebroEndoscopio.cs a EndoscopioCurvas.cs (y .meta) y aplique refactorizaciones y cambios en el código. El script se actualizó (se modificaron algunos campos del inspector, comentarios y cadenas visibles para el usuario; tenga en cuenta que algunos caracteres acentuados muestran cambios de codificación) y conserva la mecánica del endoscopio y el manejo de la tensión.
    Actualice EscenaGameplay.unity para ajustar la jugabilidad y los efectos visuales: establezca la intensidad del halo en 0, cambie el campo de visión de la cámara de 50 a 60, asigne material a varios SphereCollide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
2026-04-27 v 0.4.4 Aumenta la velocidad de extracción y mejora el enrutamiento de los tubos.
    Introducir una velocidadExtracción separada (con información sobre herramientas) y usarla al retraer para permitir velocidades de inserción/retracción independientes. Actualizar los valores predeterminados de la escena (velocidadExtracción, tiempoMaximoTiron aumentado, grosorTubo aumentado). Mejorar la visualización de la trayectoria del tubo agregando un filtro direccional (producto escalar + umbral de distancia) para evitar puntos espurios al dibujar el tubo exterior. Corregir muchos problemas de cadenas/codificación en registros, advertencias y encabezados de la interfaz de usuario y aclarar algunos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
2026-04-27 v 0.4.5 Agregar límites de caída por gravedad y flexión dinámica
    Introduce la caída de la punta inducida por la gravedad natural y los límites de flexión dinámica para el endoscopio. Agrega nuevos campos públicos (caidaGravedad, limiteFlexionNormal, limiteFlexionRelajada) con información sobre herramientas y un nuevo encabezado para la flexibilidad dinámica. Al avanzar sin la entrada de flechas, la punta ahora cae según caidaGravedad atenuada por el torque actual, y las abrazaderas de rotación usan un límite dinámico que depende del estado de empuje/tracción. También se asegura que la inserción/retracción use velocidadInsercion/velocidadExtraccion correctamente y se elimin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
2026-04-27 v 0.5 Agregar prefabs de polipos y scripts de extracción
    Agregue prefabs realistas de pólipos de Yamada (realYamada_1..4) y archivos meta de carpeta, además de nuevos scripts de extracción (PoliposManager, PolipoInteractuable, SistemaHerramientas, ZonaExtraccion) y sus meta. Actualice EscenaGameplay.unity para colocar nuevos prefabs/spawns y ajustar instancias. Reduzca la importación globalScale de Set_Polipos_Yamada.fbx de 10 a 5 y modifique EndoscopioCurvas.cs y la configuración de TagManager en consecuencia. y agregue las mecanicas basicas de extraccion en escena
2026-04-27 V 0.5.1 Agregue recursos de interfaz de usuario y actualice las escenas.
    Agregar sprite y meta IndicadorPinza; introducir script MonitorEndoscopiaUI. Actualizar EscenaGameplay.unity y MenuPrincipal.unity para agregar y reconfigurar la interfaz de usuario del juego (nuevo CanvasUIDePractica, campos de texto, botones y GameObjects relacionados como Txt_Profundidad, Txt_Reloj, BotonMenuPrincipal, TextDeDesconeccion, etc.), ajustar el escalador del lienzo y los canales del sombreador. Modificar los scripts relacionados con la jugabilidad (EndoscopioCurvas, PoliposManager, PolipoInteractuable, SistemaHerramientas, ZonaExtraccion) y los controladores de menú (ControladorMenuPrincipal, manejadorDe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
    [ParedSoporteEngranes.SLDPRT, ParedSoporteEngranes.STL]
2026-04-28 v0.5.2 version de cambios de parametro en torque y giro en monitos
    se cambio la forma de mostrar en el monitor los giros y se cambio la direccion de giro, ademas de volver a mostrar el torque original
2026-04-28 v 0.5.3 Utilice singletons y mejore el flujo de la interfaz de usuario de conexión.
    Corrige los anclajes de escena y desactiva un objeto en MenuPrincipal.unity; conecta la interfaz de usuario y los administradores a SerialManager.instancia / ConfigManager.instancia para evitar referencias faltantes del Inspector. Refactoriza ConnectivityUI para inicializar singletons, agrega comprobaciones de seguridad de nulos, centraliza las actualizaciones de estado visual y borra automáticamente el texto de estado. Evita los oyentes duplicados y agrega comprobaciones de seguridad en MonitorEndoscopiaUI (solo fuerza la pausa en caso de error si no está en modo PC, bloquea la reanudación cuando el hard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
2026-04-28 v 0.5.4Agregar botón de acción, ajustes de interfaz de usuario y correcciones de controles.
    Actualizaciones de escena e interfaz de usuario: se ajustan las posiciones y tamaños de múltiples RectTransform, se habilitan/deshabilitan los elementos interactivos y se añade un nuevo BotonAccion/Text (y un TMP hijo) a MenuPrincipal; se introduce una nueva asignación de mapAccion y se conecta una referencia a txtMapAccion. Se limpian las entradas de prefab eliminadas/añadidas y se realizan otras tareas de mantenimiento menores en EscenaGameplay y MenuPrincipal.
    EndoscopiaCurvas: se corrige el manejo del modo de entrada introduciendo modoPC = !usarControlHardware, se añaden comprobaciones de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
2026-04-28 v 0.5.5 Agregar lógica de zona de higiene y extracción, correcciones de hardware
    Se introducen funciones de higiene y zona de extracción, además de varias correcciones de robustez. Cambios clave:
    - EndoscopioCurvas: se aplica el modo PC/hardware estricto, se verifica la nulidad de los datos del hardware antes del procesamiento y se congela la rotación del cuerpo rígido cuando el control está activo.
    - SistemaHerramientas: se añade el indicador `enZonaExtraccion`, sensores de movimiento y contadores para controlar la higiene (`movimientosSinSuccionar`, `movimientosEnSeleccion`), se cancela el menú de selección si el endoscopio se mueve, se penaliza dejar tejido cortado sin aspirar,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
2026-04-28 version de arreglo para errores por movimientos
    se hicieron cambios en como se manda la informacion de daño y se agrego una iu de dalo al simulador
2026-04-28 v0.5.6 Agregar resultados e interfaz de usuario de confirmación a EscenaGameplay
    Se actualizó EscenaGameplay.unity con múltiples elementos de interfaz de usuario nuevos y cambios de diseño: se agregaron Scrollbar Vertical, Viewport, Handle, Panelresultados y varias entradas Text (TMP) / RectTransform, además de un Indicador_Octagono. Se introdujeron referencias de escena (panelConfirmarSalida, txtPreguntaConfirmacion, panelResultadosFinales, txtResultadosFinales, txtDetallePenalizaciones, btnFinalizarReporte, scrollRespuestas) y se renombró Txt_Profundidad (1) a Txt_tituloIndicador. Se ajustaron los componentes EventSystem / TMP y las instancias de prefab para que se ajusten a la nueva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
2026-04-28 v0.5.7 Agregar interfaz de usuario de indicador y penalizaciones por bucle atascado
    Introducir un nuevo "panelIndicativo" en el juego (con título/texto/botón) y ajustar varios anclajes/tamaños de RectTransform en EscenaGameplay.unity. Actualizar EndoscopioCurvas para detectar cuando el endoscopio está atascado en un bucle peligroso (atascadoPorBucle), evitar la rotación de la punta mientras está atascado, agregar umbrales de penalización 'suavidad' progresivos (siguienteUmbralSuavidad) y lógica de reinicio, y notificar a la UI cuando el juego termina. Actualizar MonitorEndoscopiaUI para exponer panelIndicativo, conectar el botón continuar para finalizar la simulación, almacenar una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
2026-04-28 v 0.5.8 Agregar animación de texto (TMP) y nuevos elementos de interfaz de usuario
    Agrega una animación de texto en bucle (TMP) (bucle.anim) y su AnimatorController. Actualiza EscenaGameplay.unity para agregar un botón 'BotonReconectar' (Reconectar Hardware), un panel de guía contextual (Panel_GuiaContextual) con texto y un indicador 'TextBucle'. Ajusta varias propiedades de la interfaz de usuario (etiqueta del botón 'Iniciar' -> 'Continuar', alineación vertical, ajustes de RectTransform, indicadores activos) y agrega campos de estado de juego (polipoEnMira, ultimoPolipoCortado). También incluye actualizaciones de script y diseño diversas a las que se hace referencia en el conjunto d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
2026-04-29 v0.5.9 Gestión del estado del hardware y guardado de sesión
    Agregue monitoreo robusto de conexión de hardware y persistencia de sesión. MonitorEndoscopiaUI ahora rastrea el estado anterior de SerialManager, centraliza VigilarHardware con salida anticipada, actualiza alertas de conexión, fuerza/bloquea el modo PC cuando es necesario y pausa automáticamente al desconectarse. Genera un informe de penalizaciones y ensambla un objeto SesionPractica para guardar el JSON de la sesión a través de HistoryManager. HistoryManager ahora usa ManejadorPartida.rutaGuardado cuando se proporciona. También un pequeño ajuste de la interfaz de usuario (alfa de color de MenuPrincipal) y grandes actuali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
2026-04-29 v 0.6.0 Agregar sistema de tutoriales y actualizar la escena de juego.
    Introducir un nuevo sistema de tutoriales (TutorialManager, TutorialStep, TutorialHighlight y metadatos) e integrar los recursos del tutorial. Actualizar EscenaGameplay.unity con entradas de geometría/GameObject de ProBuilder añadidas y componentes relacionados, y añadir ajustes de proyecto de ProBuilder. Modificar varios scripts de jugabilidad/menú (EndoscopioCurvas, MonitorEndoscopiaUI, SistemaHerramientas, ConfigManager, manejadorDePartida) y actualizar Packages/manifest.json y GraphicsSettings.asset.
2026-04-29 v 0.6.1 Agregar pasos de tutorial y protecciones de modo tutorial ademas de arreglos de detalles de las intefaces de preinicio del menu principal
    Se habilita un flujo de tutorial más completo y se evitan apariciones aleatorias en el modo tutorial. Los cambios incluyen:
    - Escenas: EscenaGameplay.unity: se añaden muchos pasos nuevos al tutorial, se corrigen errores tipográficos en el texto del tutorial, se reordenan algunos elementos secundarios de RectTransform y se exponen dos objetos de escena como elementosSoloTutorial; MenuPrincipal.unity: se ajustan múltiples anclas, posiciones y tamaños de RectTransform y se establece un valor predeterminado de un deslizador en 0.
    - Jugabilidad: P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
2026-04-29 v0.6.2 se arreglo un error en la extraccion del endoscopio en la simulacion
    se procuro un metodo de arrectamiento cuando se hace la extraccion del endoscopio para evitar que la punta genere garfios o retracciones en el intestino cuando se hace la extraccion del polipos intestinales
2026-04-30 v0.6.3 Restringe acciones en tutorial y valida UI
    Introduje un mecanismo para que el tutorial pueda requerir una única acción activa y así limitar las entradas del jugador durante el tutorial. Cambios principales:
    - TutorialManager: añade la propiedad acciónEsperadaActiva y la actualiza según el paso del tutorial, limpiándola al finalizar.
    - EndoscopioCurvas: respeta la acciónEsperadaActiva para bloquear/neutralizar entradas no permitidas (empuje/jalón, torque, movimiento con flechas) y ajusta la lógica de extracción para usar un hueso guía al retraer.
    - SistemaHerramientas: respeta accionEsperadaActiva y desactiva botones distintos al solicitado por el tutorial cuando correspon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
2026-04-30 v 0.6.4 arreglos interfaz de preinicio de la simulacion
    se hicieron arreglos en las prelimitantes de los sliders y los inputs de lossliders
2026-04-30 v 0.7.0 aplicacion base funcional
    se hizo la finalizacion y arreglos de un sistema base de endoscopia que cumple con los sistemas basicos del simulador
2026-05-01 v 0.7.1 Arreglos Version funcional, Filtrar codificadores mecánicos; desactiva automáticamente el modo PC.
    Agregue un filtro de software para codificadores mecánicos ruidosos en stm32 centro de mando (Core/Src/main.c): introduzi acumuladores, SENSITIVITY_THRESHOLD_MEC y processEncoderDelta(), aplique el filtro antes de actualizar encoder_insercion/encoder_torsion y relaje la lógica de eliminación de rebotes. En la interfaz de usuario de Unity (MonitorEndoscopiaUI.cs) desactive automáticamente 'Modo PC' y actualice la alerta de conexión cuando el hardware STM32 se conecte para que el hardware tenga prioridad. También aplique varias correcciones de escena de Unity: establezca algunos G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
    [TapaEngranes.SLDPRT, TapaEngranes.STL]
2026-05-03 Arreglos en los encoder rotativos. Agregar bibliotecas ProBuilder; actualizar la interfaz de usuario y el codificador STM32.
    Agregue DLLs administradas por Unity ProBuilder y nuevos recursos de compilación de Windows, y actualice ScriptingAssemblies.json para incluir entradas de ProBuilder. Cambie ProjectSettings para eliminar los scripts de ProBuilder en la compilación. Modifique SetupUI.cs para establecer las entradas de penalización por defecto en 5. Intercambie los GUID de RecentlyUsedScene en EditorUserSettings y aplique pequeñas ediciones de documentación a 'guia de pines.txt'. Actualice varios archivos de modelos CAD/STL y paquetes/niveles de recursos de Unity. Cambios en el firm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
    [BaseEncodersEngranes.SLDPRT, EngraneEncoderR1.SLDPRT, EngraneEncoderR2.SLDPRT, EngraneRuedaR1.SLDPRT, EngraneRuedaR1.STL, EngraneRuedaR2.SLDPRT, ParedSoporteEngranes.SLDPRT, TapaEngranes.SLDPRT]
2026-05-12 v0.8.0 Despues de las recomendaciones del especialista en endoscopia se realizaron cambios:Actualizaciones de compilaciones, manejo de entrada, tutorial y recursos
    725
    Agrega/actualiza artefactos de compilación de Unity para Linux y Windows y DLL administradas relacionadas (incluidas las DLL de ProBuilder) y actualiza ScriptingAssemblies y GUID de configuración de arranque. Corrige el manejo de entrada: ConfigManager inicializa campos de botones de hardware y agrega LateUpdate para borrar indicadores de botones momentáneos (tratar los botones como disparadores) para evitar entradas atascadas de STM32. TutorialManager ahora espera antes de cerrar las instrucciones finales, desactiva elemen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
    [BaseEncodersEngranes.SLDPRT, EngraneEncoderR1.SLDPRT, EngraneEncoderR2.SLDPRT, EngraneRuedaR1.SLDPRT, EngraneRuedaR1.STL, EngraneRuedaR2.SLDPRT, EngraneRuedaR2.STL, ParedSoporteEngranes.SLDPRT]
2026-05-12 v 0.8.1 Se hizo arreglos en la logica de botones y encoders en el simulador con la eliminacion del torque en todas las acciones, ademas de agregar el boton de limpiado del lente, Actualizar la interf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
    Refactorizar MenuPrincipal.unity: eliminar los GameObjects/componentes de la interfaz de usuario no utilizados, agregar nuevos elementos de texto para los botones configurables (TextBotonesConcambios, TextBotonesSinCambio), cambiar el nombre de BotonSuction a BotonAccion y reposicionar varios elementos de la interfaz de usuario y posiciones ancladas. Actualizar las referencias y asignaciones de escena serializadas: introducir mapLimpia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
    [circuito final para pcb [20260505, 18-51-46].pdsprj, circuito final para pcb [20260512, 19-24-50].pdsprj, circuito final para pcb.pdsprj]
2026-05-13 Agregue imágenes de circuitos, cambie los elementos del csircuito, actualice los diseños y la guía de pines.
    Agregue varias imágenes de PCB/Proteus a los apéndices del informe y actualice la imagen PCB del proyecto. Actualice el diseño del editor de Unity (aplicacion/.../default-2022.dwlt): cambie el título de la ventana y los ID de control, ajuste las configuraciones de panel/vista, modifique la configuración de la cámara y la vista, y agregue entradas de vista/ventana serializadas. Edite la guía de pines (guia de pines.txt): cambie el nombre de las entradas BT (por ejemplo, bt1 → bt1succion, bt6limpieza agregada) y marque un elemento como eliminado. Cambie el nombre de un archi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
    [circuito final para pcb [20260505, 18-51-52].pdsprj, circuito final para pcb [20260506, 12-43-48].pdsprj, circuito final para pcb [20260512, 11-30-27].pdsprj, circuito final para pcb [20260513, 12-06-21].pdsprj, circuito final para pcb [20260513, 12-13-48].pdsprj, circuito final para pcb [20260513, 16-23-40].pdsprj, circuito final para pcb.pdsprj, estructura de insercion.SLDPRT]
2026-05-16 Agregar Planos solidworks; actualizar Unity con la eliminacion de elementos de torque y cambios en la STM32
    Agregar varios dibujos CAD (.SLDDRW/.SLDPRT) y exportaciones PDF para 'centro de mando' y 'mecanismo de insercion', además de archivos STL nuevos/actualizados para impresión. Renombrar/eliminar un archivo de pieza en mayúsculas (parteMediaCajaEngranes -> parteMediaCajaEngraness). Ajustar proyecto Unity: modificar parámetros EscenaGameplay (espera/acción de instrucción, velocidades, torque/umbrales, valor de daño, configuración de tubo/giro), actualizar escena/recursos y archivos de datos Unity generados. Intercambiar algunos valores de EditorUserSettings/Layout. Cambios de firm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
    [BaseEncodersEngranes.SLDDRW, BaseEncodersEngranes.SLDPRT, BaseEncodersEngranes.STL, EngraneEncoderR1.SLDPRT, EngraneEncoderR2.SLDDRW, EngraneEncoderR2.SLDPRT, EngraneRuedaR1.SLDPRT, EngraneRuedaR2.SLDPRT]
2026-05-17 Se añade efecto de suciedad en la lente, ajuste del tamaño de los pólipos para que la logica de pinzas se centre en el tamaño y no tipo y retoques en la interfaz de usuario.
    Introducir un sistema visual de limpieza y detección de suciedad en la lente (suciedad.png + imagen de la interfaz de usuario, corrutina de limpieza, penalizaciones) e integrarlo en la lógica de la herramienta. Agregar tamaños de pólipos aleatorios y escalados clínicamente, y escalado visual (PoliposManager, PolipoInteractuable) y aplicar reglas de selección de herramientas basadas en el tamaño real en SistemaHerramientas. Ajustar el comportamiento del endoscopio y los umbrales de seguridad (EndoscopioCurvas)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
    [parteMediaCajaEngranes.SLDPRT]
2026-05-18 Agregar sistema de partículas de sangre a la escena del juego, arreglar y reforzar logica de succion y agarre del asa
    Agregue un objeto de juego ParticulasSangre ParticleSystem a EscenaGameplay y conéctelo a los componentes de juego. La escena ahora contiene una referencia serializada de particulasSangrado y el objeto de juego de partículas (transformación + renderizador + sistema) con forma, emisión y efectos visuales configurados para efectos de sangre. Se actualizaron los scripts relacionados (MonitorEndoscopiaUI.cs, PoliposManager.cs, PolipoInteractuable.cs, SistemaHerramientas.cs) y MenuPrincipal.unity para integrar el comportamiento de sangrado/partículas durante la extracción d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
2026-05-18 Mejorar los mensajes de la interfaz de usuario, la lógica de las herramientas y el tamaño de los pólipos.
    MonitorEndoscopiaUI: actualiza el panel azul en cada fotograma; actualiza las etiquetas dinámicas de los botones (Succión/Atrapar/Soltar/Aspirar) y los mensajes de guía contextual con sugerencias de teclas mapeadas; reordena los mensajes de prioridad (sangrado y fluidos mayor prioridad) y ajusta la guía de exploración. PoliposManager: ajusta los rangos de tamaño aleatorios para los tipos de pólipos para cambiar los valores mínimos/máximos. SistemaHerramientas: agrega temporizadores/penalizaciones de sangrado y manejo para succión interrumpida, rastrea el estado de sangrado/s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
2026-05-18 v0.8.2 finalizacion de arreglos segun opinion de especialista.
    se arreglaron animaciones creando un avance y recogida del asa de polipectomia mas limpia, ademas de un acercamiento mas optimo de las pinzas al polipo y ademas se hizo un arreglo con el mandado de informacion del vibrador para no generar ruido o falsos positivos en el hilo principal de unity y se cambio parametros para una mejor inmersion en el sistema de unity.
    [main.c]
2026-05-18 v0.8.3 Agregar herramienta cable LineRenderer y recursos, arreglar dimensionesmecanicas para impresion 3d
    Se agregó un nuevo cable basado en LineRenderer para herramientas y recursos necesarios. Se agregó un sprite de interfaz de usuario (sucicion suc (1).png) y un material metálico (metalicoPinzas.mat) y se actualizó la escena EscenaGameplay para incluir el componente LineRenderer (vinculado al nuevo material) y para referenciarlo desde SistemaHerramientas. Se implementó el campo cableHerramienta y la lógica LateUpdate en SistemaHerramientas.cs para habilitar/deshabilitar el cable y establecer sus puntos finales (canalDeTrabajo a los puntos finales de la herramienta activa). También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
    [BaseEncodersEngranes.SLDPRT, BaseEncodersEngranes.STL, ParedSoporteEngranes.SLDPRT, ParedSoporteEngranes.STL, parte2TapaEngranes.SLDPRT, parte2TapaEngranes.STL, parteMediaCajaEngraness.SLDPRT, parteMediaCajaEngraness.STL]
2026-05-19 Actualizar la escena de Unity, los prefabs y los textos del tutorial para su uso en diferentes pantallas..
    Aplicar varias actualizaciones al proyecto Unity: reemplazar los binarios y recursos de datos compilados/administrados para la compilación de Windows, ajustar los anclajes/posiciones/tamaños de UI RectTransform en EscenaGameplay.unity, cambiar la alineación del texto del prefab Molde_BotonArchivo y refinar el texto del tutorial/instrucciones en español para mayor claridad y coherencia. También agregar referencias de UI (succion/limpiado) e incluir una hoja de cálculo de materiales actualizada (listaDeMatertiales.xlsx). Estos cambios parecen ser ajustes de diseño y contenido para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
    [listaDeMatertiales.xlsx]
2026-05-19 arreglo mapeo de botones en la interfaz configui
    se arreglo la anulacion de botones para el mapeo del configui ademas de tambien mejorar el tipo de mapeo para escucha de los demas elementos
2026-05-24 v 0.9.0 Agregar validación de hardware, monitor de FPS y ajustes de control, arreglos de parametros para que sea realista
    Agregar múltiples imágenes de informes, archivos CAD/STL y evidencias; mover Planos antiguos a la versión antigua. Introducir los scripts MonitorFPS y ValidadorHardware y registrarlos en la escena MenuPrincipal. Actualizar SerialManager: limpiar registros, agregar prueba de ping de latencia (20 pings) y manejo más seguro de la cola de mensajes; mantener las mejoras de Traducción/EnviarDato y pequeñas correcciones de texto. Cambiar ConfigManager para acumular entradas de rueda de hardware, borrar ejes/botones en cada fotograma y ajustar los asistentes de guardar/car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
    [CentroDeMando.SLDDRW, EngraneRuedaR2.SLDPRT, EngraneRuedaR2.STL, EnsamblajemodeloEndoscopi.SLDASM, ParedSoporteEngranes.SLDPRT, ParedSoporteEngranes.STL, agarres.SLDPRT, agarres.STL]
2026-05-27 Agregue dibujos CAD, imágenes y actualice la compilación de la simulación.
    Agregue varios apéndices de informe (PDF/PNG) y exporte PDF para CentroDeMando y mecanismo de inserción; agregue dibujos de SolidWorks y un ensamblaje para el mecanismo de inserción. Mueva los archivos CAD más antiguos a 'version antigua' / 'planos antiguos' y elimine los archivos temporales ~$. Actualice varias piezas de SolidWorks (EngraneRuedaR2, engrane2) y modifique el dibujo de CentroDeMando. Actualice los datos de compilación de Unity Windows (Assembly-CSharp.dll, assets, levels) y aumente el build-guid de boot.config.
    [BaseEncodersEngranes.SLDDRW, CentroDeMando.SLDDRW, EngraneEncoderR2.SLDDRW, EngraneRuedaR2.SLDPRT, EnsamblajeMecanismo de insercion.SLDASM, ParedSoporteEngranes.SLDDRW, agarres.SLDDRW, engrane2.SLDDRW]
2026-06-10 elementos de funcionamiento extra
2026-06-10 cambio de nombre a carpetas
    [EnsamblajemodeloEndoscopi.SLDASM, agarres.SLDPRT, agarres.STL, agarres2.SLDPRT, agarres2.STL, base carcasa.SLDPRT, base carcasa.STL, basecircuitov1.SLDPRT]
2026-06-19 elementos del informe
    se agrego en el repositorio tanto la presentacion como los elementos de la apk
2026-06-19 cambios en escena paramovimientos mas fluidos y toma de datos optimizada
    se mejoro el sistema para la adaptacion a una toma de datos y movimientos de insercion mas optimizados
2026-06-20 mejora de mecanicas de unity
    se agrego un mejor control a los movimientos de unity y se adapto de mejor manera lapared intestinal
2026-06-22 mejora visual del lanzamiento del bucle y creacion de graficos del excel
    [evidencias.xlsx]
2026-06-22 mejora escena de gameplay del texto de bucle
2026-06-22 arreglos visuales y creacion de materiales de la escena gameplay
    se agregaron textruar y materiales a los distintos elementos del entorno 3
    [main.c]
2026-06-24 cambios despues de la migracion a windows 11
    [tapaCable.SLDPRT, tapaCable.STL]
2026-06-24 arreglos en la presentacion del prototipo funcional, subida del documento eh imagen de qr del repositorio de guithub
2026-06-24 powerpoint de presentacion bien subido
2026-07-08 mejora de las diapositivas de powerpoint
2026-07-21 arreglos de la presentacion y aplicacion
2026-07-28 observaciones para mejorar la presentacion
    [tabla de requerimientos.xlsx]
2026-07-29 observaciones propias para mejorar el simulador
    [datosEstadoDelArte.xlsx]
2026-07-29 mejras tutorial
    se quito las limitaicones de codigo en el tutorial
