albale15/simulador_de_Extraccion_de_polipos_intestinales/(notices)

Notices in the files:
stm32 centro de mando/Core/Src/main.c:
Copyright (c) 2025 STMicroelectronics.
All rights reserved.
This software is licensed under terms that can be found in the LICENSE file
